zohaib-khan-786/Infernonet/InfernoNet/Documentation/FreshGuard IoT Monitor.pdf

F

r

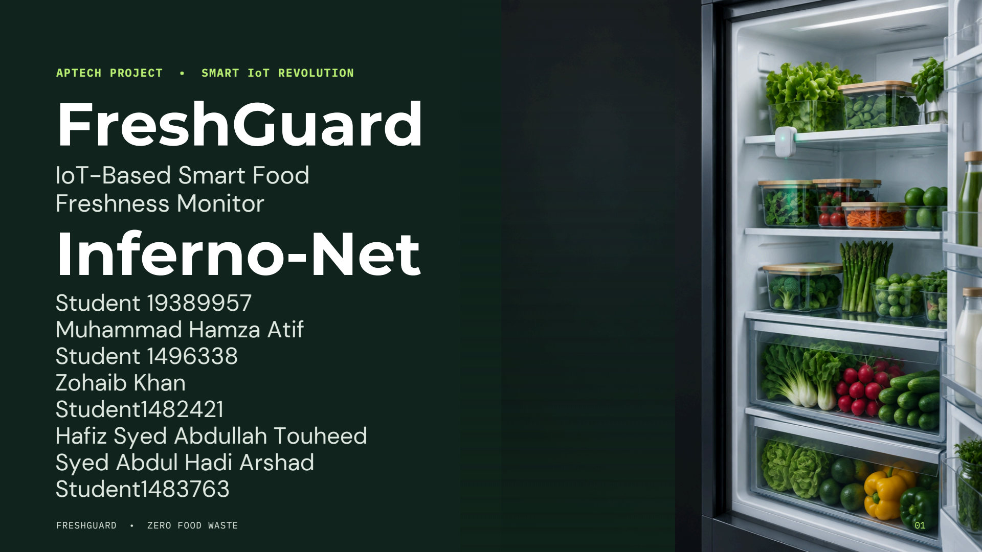
[picture p1: page 1]

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
# d IoT-Based Smart Food Freshness Monitor ZERO FOOD WASTE FRESHGUARD • ZERO FOOD WASTE

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
# tif

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
# aib

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
# fiz

S

y

e

d

A

b

d

# ulla

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
# ul H

a

# di A

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
01 / CONTEXT

# Waste often begins with missing visibility

OVERBUY

Items are forgotten behind newer stock.

POOR STORAGE

Temperature and humidity drift unnoticed.

LATE ACTION

Spoilage is discovered only at use time.

Continuous monitoring turns hidden drift into an early decision.

FRESHGUARD • ZERO FOOD WASTE | 02

02 / SOLUTION

# A small loop with a practical outcome

SENSE
conditions

INTERPRET
risk

NOTIFY
user

ACT
earlier

## A prototype that records storage conditions, links them to registered food, and creates

freshness guidance.

FRESHGUARD • ZERO FOOD WASTE | 03

03 / ARCHITECTURE

# From shelf conditions to a useful alert

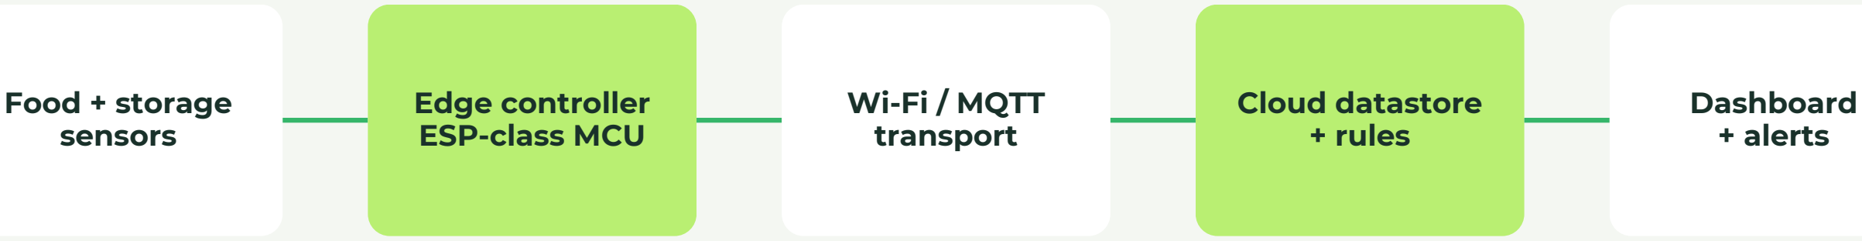
[picture p2: figure]
Food + storage sensors; Edge controller ESP-class MCU; Wi-Fi / MQTT transport; Cloud datastore + rules; Dashboard + alerts

## Telemetry → timestamp → store → evaluate → visualize

FRESHGUARD • ZERO FOOD WASTE | 04

04 / BUILD

# Hardware components

Controller

ESP32 / Wi-Fi MCU

Temperature

Digital probe or DHT

Humidity

DHT-class sensor

Gas / VOC

Air-quality sensor

Identity

RFID / NFC reader

Local alert

LED + buzzer

Display

Small OLED

Power

USB supply + enclosure

FRESHGUARD • ZERO FOOD WASTE | 05

05 / SENSING

# Three signals, one storage picture

### 01 TEMPERATURE

Tracks cold-chain stability and warm excursions.

Use trends and calibrated thresholds— not a single reading.

### 02 HUMIDITY

Reveals moisture conditions linked to drying or mold risk.

Use trends and calibrated thresholds— not a single reading.

### 03 GAS / VOC

Detects relative changes in emitted compounds during spoilage.

Use trends and calibrated thresholds— not a single reading.

FRESHGUARD • ZERO FOOD WASTE | 06

06 / IDENTITY
Register once. Track continuously.

1

SCAN OR ENTER

### RFID/NFC tag or manual ID

2

ADD CONTEXT

### Food type, quantity, stored date

3

LINK LOCATION

### Fridge zone or container sensor

FRESHGUARD • ZERO FOOD WASTE | 07

07 / LOGIC

# Freshness is a decision, not a sensor value

ITEM PROFILE
type • stored date • expected life

LIVE CONDITIONS
temperature • humidity • VOC trend

RULES
thresholds • duration • confidence

DECISION
ENGINE

FRESH

USE SOON

CHECK / DISCARD

FRESHGUARD • ZERO FOOD WASTE | 08

08 / EXPERIENCE

# The right alert, through the right path

RULE TRIGGERED

LOCAL

LED status • OLED message • buzzer for urgent events

REMOTE

Dashboard banner • push/email notification • event history

FRESHGUARD • ZERO FOOD WASTE | 09

09 / DASHBOARD
See status now. Understand change over time.

LIVE STATUS

## Item freshness Storage conditions Alert history Trend charts

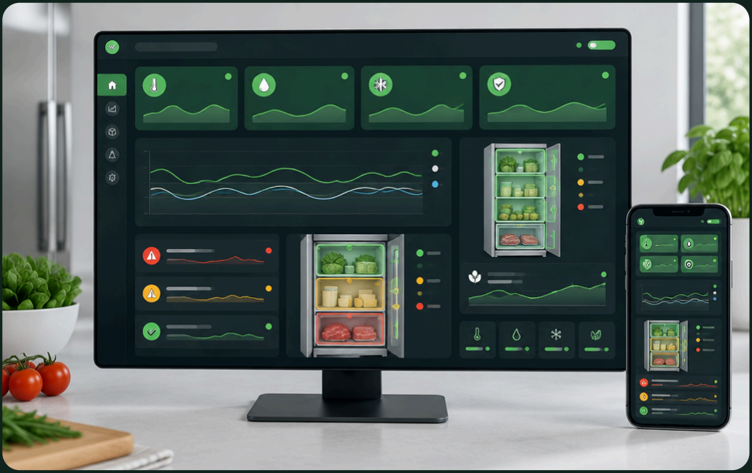
[picture p3: figure]

FRESHGUARD • ZERO FOOD WASTE | 10

10 / REQUIREMENTS

# What the system must do

REGISTER

Create and update food records

SAMPLE

Read sensors at set intervals

STORE

Timestamp and retain telemetry

EVALUATE

Apply freshness rules

ALERT

Notify on meaningful risk

VISUALIZE

Show status and history

FRESHGUARD • ZERO FOOD WASTE | 11

11 / QUALITY

# Useful means reliable, clear, and maintainable

RELIABILITY

Recover from Wi-Fi loss; buffer readings.

USABILITY

Status understandable at a glance.

SECURITY

Authenticated access; protected data.

PERFORMANCE

Timely sampling and alert delivery.

MAINTAINABILITY

Configurable thresholds and modular code.

FRESHGUARD • ZERO FOOD WASTE | 12

# IoT test matrix

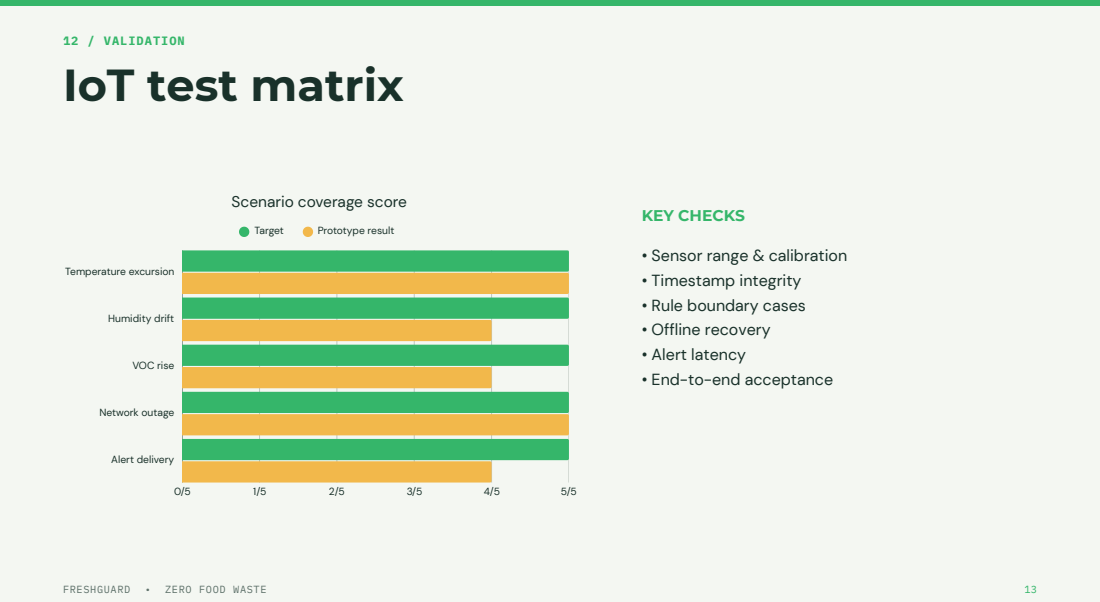
[picture p4: page 13]
12 / VALIDATION; Target; Prototype result; Temperature excursion; Humidity drift; VOC rise; Network outage; Alert delivery; KEY CHECKS; FRESHGUARD • ZERO FOOD WASTE

Scenario coverage score

• Sensor range & calibration
• Timestamp integrity
• Rule boundary cases
• Offline recovery
• Alert latency
• End-to-end acceptance

13 / SUBMISSION

# Final project package

01

WORKING PROTOTYPE

Sensors, controller,
alerts

02

SOURCE CODE

Firmware, backend,
dashboard

03

DOCUMENTATION

Architecture, setup,
user guide

04

EVIDENCE

Test matrix, logs,
screenshots

05

DEMO

Scenario-led
presentation
FRESHGUARD • ZERO FOOD WASTE | 14

14 / CONCLUSION

# FreshGuard makes storage conditions visible—and action

timely.

PRACTICAL PURPOSE

## Reduce avoidable waste through

monitoring, context, and early prompts.

HONEST BOUNDARY

## A prototype risk indicator—not a laboratory test or guarantee of food

safety.

FRESHGUARD • ZERO FOOD WASTE | 15

FRESHGUARD

# Thank you

# Questions & Discussion

ZERO FOOD WASTE × SMART IoT REVOLUTION

FRESHGUARD • ZERO FOOD WASTE | 16
