zohaib-khan-786/Infernonet/FreshGuard_Enterprise_Dashboard_UI_Guide.md

# FreshGuard Enterprise Dashboard — UI & Feature Build Guide

## 1. Product Definition

FreshGuard is an enterprise cold-storage monitoring and food-safety platform.

The dashboard is not a generic IoT telemetry screen. It is an operational control center designed to answer, immediately:

1. Is the refrigeration/storage environment safe?
2. Is the Raspberry Pi/controller and hardware healthy?
3. What changed recently?
4. Which food/items need attention?
5. Are temperature, humidity, gas, pressure, and cooling conditions within configured limits?
6. Is the refrigerator actively cooling?
7. What alerts require action?
8. What has happened over time?
9. Is the device online and actually reporting fresh data?

The UI must prioritize operational clarity over decoration.

---

# 2. Design Direction

## Visual language

Use a premium enterprise dark interface.

### Primary characteristics

- Dark navy/near-black application shell.
- Slightly lighter blue-black cards.
- High contrast typography.
- Thin borders instead of heavy shadows.
- Moderate corner radius: 10–14px.
- Restrained glow only around active/critical status indicators.
- Dense enough for professional monitoring, but never cramped.
- Strong visual hierarchy.
- Consistent status colors.
- Compact controls.
- Responsive layout.
- No excessive gradients.
- No glassmorphism everywhere.
- No giant hero section.
- No unnecessary 3D graphics.
- No decorative charts without operational meaning.

### Suggested palette

```text
App background:       #06111F
Sidebar:              #081525
Card:                 #0B1B2D
Card elevated:        #10243A
Border:               #1C3854
Primary text:         #F3F7FB
Secondary text:       #91A4B8
Muted text:            #60758A

Success:               #20C997
Warning:               #F59E0B
Danger:                #EF4444
Info:                  #3B82F6
Purple/diagnostic:     #8B5CF6
Cyan/temperature:      #22D3EE
```

Do not hard-code these colors into chart libraries if the chart system has a central theme. Define them as design tokens.

---

# 3. Global Application Layout

Desktop:

```text
┌──────────────────────────────────────────────────────────────────────────┐
│ Sidebar │ Global Header                                                  │
│         ├────────────────────────────────────────────────────────────────┤
│         │ Page content                                                    │
│         │                                                                  │
│         │                                                                  │
└─────────┴──────────────────────────────────────────────────────────────────┘
```

Recommended dimensions:

```text
Sidebar width: 240–260px
Header height: 68–76px
Content max-width: 1800px
Content padding: 20–28px
Card gap: 14–18px
```

The content should use a 12-column responsive grid.

---

# 4. Sidebar

## Brand area

Show:

- FreshGuard logo
- FreshGuard name
- Subtitle: `Cold-Storage Safety Monitor`
- Current application version

Example:

```text
[Shield]
FreshGuard
Cold-Storage Safety Monitor
```

## Navigation

### Main

- Dashboard
- Live Monitoring
- Food & Inventory
- Refrigeration
- Alerts
- Logs & History
- Reports

### Administration

- Devices
- Thresholds
- Users & Roles
- Integrations
- Settings

### Bottom status card

```text
● System Online
All systems operational
```

The status card changes to:

```text
● Degraded
2 devices need attention
```

or

```text
● Offline
Live telemetry unavailable
```

## Sidebar behavior

Desktop:
- Always visible.
- Active item has a filled background and subtle left/accent indicator.

Tablet:
- Collapsible.

Mobile:
- Off-canvas drawer.
- Bottom navigation may be used for the five most important destinations.

---

# 5. Global Header

The header should identify the currently selected device/site.

Example:

```text
[Refrigerator Icon]

Refrigerator Unit #1     ● Online
Location: Kitchen
ID: FG-001
Last sync: 2 min ago
```

Right side:

```text
Date / Time
Notifications
User avatar
User name
Role
Dropdown
```

## Device selector

Allow:

```text
All Devices
Refrigerator Unit #1
Refrigerator Unit #2
...
```

Changing device refreshes all dashboard telemetry.

## Connection indicator

States:

### Online

```text
● Online
Last sync: 8 sec ago
```

### Delayed

```text
● Delayed
Last sync: 2 min ago
```

### Offline

```text
● Offline
Last sync: 18 min ago
```

Never imply that a stale reading is live.

---

# 6. Dashboard Page

The dashboard is the primary operational page.

## Layout

```text
Header

KPI / telemetry cards
──────────────────────────────────────────────

Temperature Trends        Quick Stats
                         Device Health
──────────────────────────────────────────────

Food & Storage            Environmental Conditions

Alerts & Notifications    Recent Events

Quick Actions
```

---

# 7. Top Telemetry Cards

Use 5 primary cards.

## Card 1 — Refrigerator Temperature

Display:

```text
Refrigerator Temperature

2.8 °C

Optimal

Target: 2–5 °C
```

Include:
- Current value
- Unit
- Status
- Target range
- Mini sparkline
- Last updated timestamp

Status examples:

```text
Optimal
Warning
Critical
No Data
```

## Card 2 — Humidity

```text
Humidity

61.3 %RH

Optimal

Target: 50–70 %RH
```

## Card 3 — System Pressure

```text
System Pressure

1,003 hPa

Normal

Target: 950–1,050 hPa
```

If refrigeration pressure transducers are later added, this card should become configurable to display suction/discharge pressure.

## Card 4 — Air Quality / Gas

```text
Air Quality

137.8 ppm

Good

Target: <300 ppm
```

For MQ-135, do not falsely represent an uncalibrated sensor as laboratory-grade ppm.

The UI should support a `relative / uncalibrated` designation.

## Card 5 — Pi Temperature

```text
Pi Temperature

32.1 °C

Normal

Target: <60 °C
```

This becomes important when the refrigeration system is also used to cool the Raspberry Pi.

---

# 8. KPI Card Interaction

Each card is clickable.

Clicking opens the metric detail drawer/page.

Metric detail contains:

- Current value
- Target
- Current status
- Historical chart
- Min
- Max
- Average
- Time outside threshold
- Number of alerts
- Last update
- Sensor/device source
- Sensor health

Example:

```text
Temperature
2.8 °C

Target
2–5 °C

Today
Min     Avg     Max
2.1     2.9     4.8

Out of range
00:12:14

Alerts
2
```

---

# 9. Temperature Trends Chart

This is the main chart.

## Chart type

Line chart.

## Series

For the full refrigeration version support:

```text
Refrigerator
Evaporator
Condenser
Pi CPU
Coolant
Ambient
```

The user can toggle series.

## Controls

```text
1H   6H   24H   7D   30D
```

Also support custom date/time range.

## Chart requirements

- Interactive tooltip.
- Crosshair.
- Timestamp.
- Current value.
- Threshold bands.
- Threshold lines.
- Alarm markers.
- Door-open markers.
- Compressor start/stop markers.
- Missing-data indication.
- Zoom/pan for long ranges.
- Legend with clickable series.
- Export CSV.
- Export chart image/report.

## Threshold visualization

Example:

```text
Critical High ─────────────────
Warning High  ─────────────────
                temperature line
Warning Low   ─────────────────
Critical Low  ─────────────────
```

Do not rely solely on color. Labels must exist.

---

# 10. Environmental Conditions Panel

Use a compact 2x3 grid.

Cards:

### Temperature
Current:
`2.8 °C`

Target:
`2–5 °C`

Status:
`Optimal`

### Humidity
Current:
`61.3 %RH`

Target:
`50–70 %`

### Gas
Current:
`137.8 ppm`

Target:
`<300 ppm`

### Pressure
Current:
`1,003 hPa`

Target:
`950–1,050 hPa`

### Pi Temperature
Current:
`32.1 °C`

Target:
`<60 °C`

### Ambient Temperature
Current:
`24.6 °C`

Target:
`Reference only`

---

# 11. Quick Stats

Quick Stats are operational states rather than raw sensors.

## Compressor

```text
Compressor
Running

Runtime: 42 min
```

States:

- Running
- Stopped
- Starting
- Fault
- Locked out

## Energy

```text
Energy Consumption
0.82 kWh

Today
```

If an energy meter is installed, support:

- Instant power
- Current
- Voltage
- Energy today
- Energy this week
- Energy this month
- Compressor energy

## Door

```text
Door Status
Closed

Since 2h 14m
```

States:

- Closed
- Open
- Open too long
- Sensor fault

## Fan

```text
Evaporator Fan
On
```

States:

- On
- Off
- Fault

---

# 12. Device Health

Device Health is a hardware diagnostics panel.

List every important component.

Example:

```text
Device Health                       Healthy

● Raspberry Pi 4              Online
● ADS1115 ADC                 Online
● BMP280                      Online
● DHT11                        Online
● MQ-135                      Online
● MFRC522 RFID                Online
● DS3231 RTC                  Online
● Refrigeration controller    Online
● Temperature probe #1        Online
● Pressure sensor             Online
```

Each item should show:

- Online/offline
- Last reading
- Last communication
- Error count
- Firmware version where applicable

Clicking opens diagnostics.

---

# 13. Hardware Diagnostics

Provide:

```text
Device
Firmware
Uptime
CPU temperature
CPU load
Memory
Storage
Network
MQTT connection
Last packet
Packet loss
Sensor status
GPIO status
```

For Raspberry Pi:

```text
CPU Temperature
CPU Load
RAM
Disk
Temperature throttling
Undervoltage
Network
MQTT
```

---

# 14. Alerts & Notifications

This panel should show alerts requiring attention.

Each alert:

```text
[Severity]
Title
Short explanation
Timestamp
Device
Current value
Threshold
Action
```

Example:

```text
CRITICAL
Refrigerator temperature too high

Current: 8.7 °C
Limit: 5 °C

Started 14:21
Refrigerator Unit #1

[Acknowledge]
[View details]
```

## Severity

Use:

```text
Critical
Warning
Info
Resolved
```

Do not make every event an alert.

---

# 15. Alert Detail

Opening an alert should show:

```text
Alert
Refrigerator temperature too high

Current value
8.7 °C

Threshold
5 °C

Started
14:21

Duration
00:18:34

Device
FG-001

Sensor
Evaporator temperature

Related events
Door opened
Compressor started
Temperature crossed threshold
```

Actions:

- Acknowledge
- Resolve
- Add note
- View chart
- View related events

---

# 16. Food & Storage

This is a core business feature.

Display:

```text
Food & Storage

8 Items

Fresh             6
Needs Attention   1
Expired           1
```

Use a donut chart for composition.

The chart should never be the only representation. Always show counts beside it.

## Inventory table

Columns:

```text
Item
RFID / ID
Category
Stored
Last checked
Temperature exposure
Status
Expiry
Actions
```

Example:

```text
Milk
F-001
Dairy
26 May 14:12
Fresh
28 May
Fresh
>
```

---

# 17. Food Item Detail

Clicking an item opens:

```text
Milk

Status: Fresh

RFID:
F-001

Stored:
26 May 14:12

Expiry:
28 May

Current storage temperature:
2.8 °C

Temperature exposure:
Within limits

Door events:
2

Temperature excursions:
0

History
```

Show a temperature exposure timeline.

---

# 18. RFID Workflow

When RFID is scanned:

```text
RFID Scan Detected

Tag:
04:A3:...

Item:
Milk

Action:
Inventory lookup

Result:
Found

Status:
Fresh
```

If unknown:

```text
Unknown RFID tag

Tag:
04:A3:...

[Register Item]
[Ignore]
```

---

# 19. Recent Events

Show a chronological event stream.

Example:

```text
14:28  RFID
Food item scanned

13:42  Door
Door opened for 4 seconds

12:17  Temperature
Temperature returned to normal

11:03  Gas
Gas level increased

08:00  System
System started
```

Each event should have:

- Timestamp
- Event type
- Description
- Device
- Severity
- Related entity

Provide:

`View All`

---

# 20. Event Log Page

Full searchable audit log.

Filters:

```text
Device
Event type
Severity
Sensor
User
Date range
```

Search:

```text
Search events...
```

Table:

```text
Timestamp
Type
Device
Source
Value
Severity
Message
User
```

Support pagination and export.

---

# 21. Refrigeration Page

This page is required for the custom refrigerator concept.

## System overview

Display:

```text
Cooling System

Compressor       Running
Evaporator       -7.5 °C
Condenser        32.4 °C
Coolant          6.8 °C
Refrigerator     3.1 °C
Pi               32.1 °C
```

## Refrigeration schematic

Provide a simplified animated flow diagram:

```text
Compressor
    ↓
Condenser
    ↓
Expansion Device
    ↓
Evaporator
    ↓
Compressor
```

Show current temperatures and pressures around the loop.

Do not use decorative animation that obscures actual system state.

---

# 22. Pi Cooling Page

Because the Raspberry Pi is also a cooling load, expose its thermal system separately.

Show:

```text
Pi Temperature
32.1 °C

Cold Plate
8.2 °C

Coolant
6.8 °C

Ambient
24.6 °C

Dew Point
16.1 °C

Condensation Risk
Low
```

## Critical safety indicator

If:

```text
Cold surface temperature <= calculated dew point
```

show:

```text
CONDENSATION RISK
Cold surface is at/below dew point.

Cooling protection may activate.
```

This should be a high-priority safety condition.

---

# 23. Cooling System Controls

Controls must be permission-protected.

Possible controls:

```text
Cooling Mode
[Auto]

Compressor
[Running]

Evaporator Fan
[On]

Pump
[On]

Pi Cooling
[Enabled]
```

Manual controls require confirmation.

Example:

```text
Start compressor manually?

This bypasses automatic cooling logic.

[Cancel] [Confirm]
```

Never allow dangerous hardware controls through an accidental single click.

---

# 24. Energy Dashboard

Display:

### Current

```text
Power
142 W

Voltage
231 V

Current
0.62 A
```

### Consumption

```text
Today       2.8 kWh
7 days      17.4 kWh
30 days     74.2 kWh
```

Charts:

1. Power over time — line
2. Energy consumption by day — bar
3. Compressor runtime — bar
4. Temperature vs power — multi-series line
5. Energy per cooling hour — line

---

# 25. System Performance Charts

## Temperature vs time

Line.

Series:
- Refrigerator
- Evaporator
- Pi
- Ambient

## Humidity vs time

Line.

## Pressure vs time

Line.

## Gas level vs time

Line.

## Power vs time

Line.

## Compressor runtime

Bar chart by hour/day.

## Energy consumption

Bar chart by day.

## Food status

Donut chart:
- Fresh
- Needs attention
- Expired

## Alert distribution

Bar chart:
- Critical
- Warning
- Info
- Resolved

## Sensor health

Bar chart or status table:
- Online
- Delayed
- Offline

---

# 26. Chart Interaction Rules

Every chart must support:

- Hover tooltip.
- Exact timestamp.
- Current value.
- Time-range selector.
- Legend toggles.
- Threshold overlay.
- Empty state.
- Loading state.
- Error state.
- No-data state.

Charts must not show fake data as real data.

Use explicit demo labels when seeded data is used.

---

# 27. Reports

Reports page:

```text
Reports

Temperature Report
Food Storage Report
Energy Report
Device Health Report
Alert Report
Audit Report
```

Filters:

```text
Device
Date range
Report type
```

Actions:

```text
Preview
Export PDF
Export CSV
```

---

# 28. Dashboard Quick Actions

Provide four compact actions:

```text
Export Report
Refresh Data
Scan RFID
Settings
```

Additional actions can be:

```text
Add Food Item
Acknowledge Alerts
Run Diagnostics
Device Restart
```

Dangerous actions must be visually separated.

---

# 29. Notifications Center

Bell icon opens a notification drawer.

Group by:

```text
Critical
Today
Earlier
```

Example:

```text
Critical
Temperature exceeded limit
2 min ago

Warning
Door open too long
12 min ago

Info
RFID item scanned
24 min ago
```

Provide:

`Mark all read`

Do not automatically clear critical notifications.

---

# 30. Threshold Management

Administrator page.

Each threshold has:

```text
Metric
Minimum
Maximum
Warning level
Critical level
Delay
Action
Enabled
```

Example:

```text
Refrigerator Temperature

Target:
2–5 °C

Warning:
1–7 °C

Critical:
<0 °C or >8 °C

Delay:
60 seconds
```

Allow per-device and global thresholds.

Show change history.

---

# 31. Audit Trail

Every configuration change should be logged.

Example:

```text
27 Sep 2026 15:55

Admin changed:
Temperature max

Previous:
5 °C

New:
6 °C

Reason:
Testing

User:
Administrator
```

Never silently overwrite configuration history.

---

# 32. Device Management

Device table:

```text
Device ID
Name
Type
Location
Status
Firmware
Last Seen
Health
Actions
```

Device detail:

```text
Identity
Connectivity
Sensors
Firmware
Telemetry
Thresholds
Logs
Maintenance
```

Actions:

- Rename
- Assign location
- Update configuration
- Restart
- Disable
- Remove

Dangerous actions require confirmation.

---

# 33. Settings

Organize settings into sections:

### General
- Site name
- Time zone
- Units

### Monitoring
- Sampling interval
- Telemetry retention
- Chart defaults

### Alerts
- Thresholds
- Notification channels
- Alert delays

### Device
- MQTT
- Network
- Firmware

### Security
- Users
- Roles
- API keys
- Sessions

### Integrations
- MQTT
- Backend
- Email
- Webhooks

---

# 34. User Roles

Support:

```text
Administrator
Operator
Viewer
Maintenance
```

Administrator:
- Everything.

Operator:
- Monitor
- Acknowledge alerts
- Inventory
- Reports

Viewer:
- Read-only.

Maintenance:
- Diagnostics
- Hardware
- Device controls
- No user administration.

---

# 35. Responsive Design

## Desktop ≥ 1440px

Full dashboard:

```text
Sidebar
5 KPI cards
Large trend chart
Quick stats
Device health
Food
Environmental
Alerts
Events
```

## Laptop 1024–1439px

- Sidebar remains.
- KPI cards wrap.
- Right panels move below main chart.
- Reduce chart height.

## Tablet 768–1023px

- Collapsible sidebar.
- 2-column cards.
- Right rail becomes a normal content section.
- Charts full width.

## Mobile <768px

Order:

1. Device/header
2. Critical alert
3. Temperature
4. Pi temperature
5. Humidity
6. Other metrics
7. Trend chart
8. Alerts
9. Food
10. Events

Use horizontal scrolling only for dense tables.

Never make the entire dashboard horizontally scroll.

---

# 36. Application States

Every page and component needs:

## Loading

Skeleton cards and chart placeholders.

## Empty

Example:

```text
No telemetry available

The device has not reported any readings yet.
```

## Offline

```text
Device offline

Last reading:
27 Sep 2026 15:52

Data shown below is historical.
```

## Error

```text
Unable to load telemetry

Retry
```

## Stale

```text
Data stale

Last update: 8 minutes ago
```

The UI must never make stale telemetry look live.

---

# 37. Status System

Use consistent status semantics everywhere.

```text
GREEN
Healthy / Optimal / Fresh / Online

AMBER
Warning / Needs attention / Delayed

RED
Critical / Expired / Offline / Fault

BLUE
Informational / Normal system event

PURPLE
Diagnostic / System subsystem
```

Always include text labels. Do not communicate state by color alone.

---

# 38. Accessibility

Required:

- Keyboard navigation.
- Visible focus state.
- Minimum readable contrast.
- Semantic buttons.
- Accessible labels.
- Tooltips for icons.
- Do not rely solely on color.
- Screen-reader-friendly status messages.
- Tables with proper headers.
- Modal focus trapping.

---

# 39. Information Hierarchy

The user should be able to determine these in under a few seconds:

```text
1. Is the system online?
2. Is the refrigerator safe?
3. Is the Pi safe?
4. Is anything currently wrong?
5. What needs action?
```

Do not place low-level diagnostics above operational status.

The dashboard is for decisions first and diagnostics second.

---

# 40. Data Freshness Model

Every telemetry value should carry:

```text
value
unit
timestamp
source
status
quality
```

Example:

```json
{
  "metric": "refrigerator_temperature",
  "value": 2.8,
  "unit": "°C",
  "timestamp": "2026-09-27T15:58:11+05:00",
  "source": "BMP280",
  "status": "optimal",
  "quality": "fresh"
}
```

Possible quality:

```text
fresh
delayed
stale
missing
invalid
```

---

# 41. Suggested Component Architecture

Use reusable components.

```text
AppShell
├── Sidebar
├── Header
├── DeviceSelector
├── NotificationCenter
└── UserMenu

Dashboard
├── AlertBanner
├── MetricCard
├── TrendChart
├── QuickStats
├── DeviceHealth
├── FoodSummary
├── EnvironmentalGrid
├── AlertList
├── EventTimeline
└── QuickActions

Inventory
├── InventorySummary
├── InventoryTable
├── FoodItemDrawer
├── RFIDScanner
└── FoodHistory

Refrigeration
├── CoolingOverview
├── RefrigerationDiagram
├── CompressorStatus
├── ThermalMetrics
├── PressureMetrics
└── CoolingControls

Diagnostics
├── DeviceHealth
├── SensorStatus
├── NetworkStatus
├── SystemResources
└── HardwareLogs
```

---

# 42. Recommended Frontend Structure

```text
src/
├── app/
│   ├── dashboard/
│   ├── monitoring/
│   ├── inventory/
│   ├── refrigeration/
│   ├── alerts/
│   ├── logs/
│   ├── reports/
│   ├── devices/
│   └── settings/
│
├── components/
│   ├── layout/
│   ├── cards/
│   ├── charts/
│   ├── alerts/
│   ├── inventory/
│   ├── refrigeration/
│   ├── diagnostics/
│   └── common/
│
├── lib/
│   ├── api/
│   ├── telemetry/
│   ├── formatting/
│   └── permissions/
│
├── hooks/
├── types/
└── styles/
```

---

# 43. Data Model Concepts

Core entities:

```text
Device
Sensor
TelemetryReading
Threshold
Alert
Event
FoodItem
RFIDTag
RefrigerationState
EnergyReading
User
Role
AuditEntry
Report
```

Relationships:

```text
Device
 ├── Sensors
 ├── Telemetry
 ├── Alerts
 ├── Events
 ├── Thresholds
 └── RefrigerationState

FoodItem
 └── RFIDTag
```

---

# 44. Real-Time Updates

The UI should support real-time telemetry.

Preferred architecture:

```text
Sensors
   ↓
ESP32 / Raspberry Pi
   ↓
MQTT
   ↓
Backend
   ↓
WebSocket / SSE
   ↓
Dashboard
```

Do not poll every metric independently from the browser if a real-time event stream is available.

The UI should visibly show:

```text
Live
Delayed
Offline
```

---

# 45. MQTT / Telemetry UI Requirements

Show connection status:

```text
MQTT
Connected

Last message:
2 sec ago
```

If disconnected:

```text
MQTT
Disconnected

Last message:
4 min ago
```

Telemetry packets should have:

- Device ID
- Sequence number
- Timestamp
- Sensor values
- Firmware version
- Quality/status

---

# 46. Enterprise UX Rules

1. Never hide important operational state behind navigation.
2. Never show raw technical data without context.
3. Every metric needs a unit.
4. Every metric should have a timestamp.
5. Every abnormal value needs a threshold/context.
6. Every alert needs an action or explanation.
7. Historical data must be visually distinguishable from live data.
8. Destructive actions require confirmation.
9. Hardware controls require appropriate permissions.
10. Tables must be searchable/filterable.
11. Charts must have useful tooltips.
12. Empty/error/offline states must be designed, not improvised.
13. Do not use fake success states.
14. Do not call uncalibrated MQ-135 readings laboratory-grade measurements.
15. Do not make the UI look like a toy IoT dashboard.

---

# 47. Dashboard Priority Model

The dashboard should visually prioritize:

```text
CRITICAL ALERT
      ↓
CURRENT SAFETY STATE
      ↓
LIVE TELEMETRY
      ↓
COOLING SYSTEM
      ↓
FOOD / INVENTORY
      ↓
HISTORY
      ↓
DIAGNOSTICS
```

Low-level technical details belong deeper in the application.

---

# 48. Implementation Sequence

Build in this order.

## Phase 1 — Application shell

- Sidebar
- Header
- Device selector
- Responsive grid
- Theme tokens
- Typography

## Phase 2 — Dashboard

- Metric cards
- Alert banner
- Trend charts
- Quick stats
- Device health
- Environmental cards
- Food summary
- Recent events

## Phase 3 — Inventory

- Food table
- Food details
- RFID flow
- Status system

## Phase 4 — Alerts

- Alert list
- Alert detail
- Acknowledgement
- Resolution
- Alert history

## Phase 5 — Refrigeration

- Refrigeration overview
- Compressor
- Evaporator
- Condenser
- Coolant
- Pi cooling
- Condensation risk
- Cooling diagram

## Phase 6 — Diagnostics

- Device health
- Sensor health
- Network
- MQTT
- Raspberry Pi system metrics

## Phase 7 — Reports

- PDF
- CSV
- Filtered reports
- Historical analytics

## Phase 8 — Administration

- Devices
- Thresholds
- Users
- Roles
- Settings
- Audit trail

---

# 49. Final Visual Requirement

The finished product should feel like:

```text
Enterprise monitoring software
+
Industrial refrigeration control
+
Food inventory system
+
IoT observability platform
```

It should NOT feel like:

```text
Student IoT project
Generic admin template
Generic AI dashboard
Crypto dashboard
Gaming UI
```

The interface must communicate that FreshGuard is monitoring a real physical system whose incorrect state can have physical consequences.

Use visual density where information matters, but maintain strong grouping and whitespace.

The most important screen should make the operational state obvious without requiring the user to interpret raw sensor graphs.

---

# 50. Build Acceptance Checklist

Before considering the UI complete:

- [ ] Enterprise dark theme implemented.
- [ ] Responsive desktop/tablet/mobile layouts.
- [ ] Sidebar navigation.
- [ ] Device selector.
- [ ] Live/offline/stale states.
- [ ] Temperature KPI.
- [ ] Humidity KPI.
- [ ] Pressure KPI.
- [ ] Gas KPI.
- [ ] Pi temperature KPI.
- [ ] Temperature trend chart.
- [ ] Environmental conditions.
- [ ] Quick stats.
- [ ] Compressor state.
- [ ] Energy state.
- [ ] Door state.
- [ ] Fan state.
- [ ] Device health.
- [ ] Food inventory.
- [ ] RFID workflow.
- [ ] Alerts.
- [ ] Event timeline.
- [ ] Refrigeration page.
- [ ] Pi cooling page.
- [ ] Dew-point/condensation risk.
- [ ] Energy analytics.
- [ ] Reports.
- [ ] Threshold management.
- [ ] Audit history.
- [ ] Device management.
- [ ] User roles.
- [ ] Settings.
- [ ] Loading states.
- [ ] Empty states.
- [ ] Error states.
- [ ] Offline states.
- [ ] Accessibility.
- [ ] Chart tooltips.
- [ ] Chart range controls.
- [ ] CSV/PDF export.
- [ ] No fake live-data claims.
- [ ] No unsupported food-safety claims.
- [ ] Dangerous hardware actions protected by permissions and confirmation.
