zohaib-khan-786/Infernonet/docs/BUILD_SHEET.html

# FreshGuard — Bench Build Sheet

ESP8266MOD cold-storage food-safety monitor · work top-down, power up in stages, verify before adding the next stage · full reference: docs/WIRING_DIAGRAM.html

## A · Parts check — do not start until every box is ticked

| Part | Model / part number | Count | Check before building
☐ | MCU board | ESP8266MOD | 1 | NodeMCU. Note the silkscreen — trust GPIO numbers, not D-labels
☐ | I/O expander | PCF8574 | 2 | Must be PCF8574 (0x20), not PCF8574A (0x38)
☐ | Level shifter | 4-ch BSS138 | 1 | Bidirectional, has LV1–LV4 / HV1–HV4
☐ | Temperature + pressure | BME280 | 1 | BME280, chip id 0x60 — a real BMP280 (0x58) is rejected by the driver
☐ | Humidity | removed | 0 | DHT11 no longer fitted - the BME280 measures humidity itself, and GPIO16 is now spare
☐ | Gas | MQ-135 | 1 | 4-pin breakout with A0 and D0
☐ | ADC | ADS1115 | 1 | Adafruit 2349 or CJMCU-1115
☐ | RTC | DS3231 | 1 | Charging path must be disabled — see stage D
☐ | RFID | MFRC522 | 1 | 13.56 MHz kit · 3.3 V only
☐ | Display | 16×2 LCD + PCF8574 backpack | 1 | Address 0x27 · 5 V supply
☐ | Door sensor | Reed switch, SPST-NO | 1 | Magnetic type
☐ | Buzzer | TMB12A05 | 1 | 5 V active, 12 mm. The A12 is 12 V and will not sound
☐ | MOSFET | IRFZ44N | 2 | TO-220 logic-level. Buzzer only + 1 spare. NEVER IRF540N — it will not conduct at a 3.3 V gate. The three LEDs need no transistor.
☐ | Diode | 1N4148 | 1 | DO-35 · buzzer flyback
☐ | Resistors 4.7 kΩ | 1/4 W | 1 | MQ divider upper leg
☐ | Resistors 2.2 kΩ | 1/4 W | 1 | MQ divider lower leg
☐ | Resistors 10 kΩ | 1/4 W | 1 | Reed pull-up only — recommended, the PCF8574 has an internal one
☐ | Resistors 330 Ω | 1/4 W | 3 | LED current limiting
☐ | Capacitors 100 nF | ceramic X7R, 104 | 3 | ESP8266 3V3 pin · MQ-135 supply · 5 V rail
☐ | Bulk capacitor | 1000 µF, 16 V | 1 | On the 5 V rail
☐ | LEDs | green · yellow · red, 3 mm | 3 | Indicator colours
☐ | Supply | USB 5 V, 1 A min | 1 | Wi-Fi bursts exceed 300 mA
☐ | Tools | multimeter, side cutters, solderless breadboard | — | Meter is mandatory, not optional

## B · Before first power

### Do not fit these — your modules already have them

Part | Why it is unnecessary | How to confirm
I²C pull-ups | BME280, ADS1115, most PCF8574 and DS3231 breakouts already carry 4.7–10 kΩ on SDA/SCL. The BSS138 board carries its own for the LCD side. | Power off. Measure SDA to 3V3. ~4.7–10 kΩ means they are fitted. Do not add a second set.

### Do not economise on these three

1. 1N4148 across the buzzer. A buzzer is an inductive load; switching it off spikes to tens of volts on a 5 V rail. That spike is created outside the buzzer, by your switching, so no module can contain it. Without it you get unexplainable sensor faults, brownouts and eventually a dead MOSFET.
2. 1000 µF on the 5 V rail. Three loads share one USB feed: ESP8266 Wi-Fi spikes over 300 mA, the MQ-135 heater at ~150 mA, and the LCD plus buzzer. This belongs to the supply path, not to any module.
3. The 100 nF decoupling. The disturbance comes from the inductance of the wire, so a cap soldered to the module is at the wrong end of it to respond.

### Blocking items — resolve all four

1. PCF8574 fitted. Without it the firmware reports Sensor Fault permanently and never produces a food verdict.
2. DS3231 charging disabled. On the HW-084/ZS-042 boards, remove the resistor feeding the DS3231 VCH pin. Confirm with a meter that no current flows into a non-rechargeable CR2032.
3. Level shifter orientation. LV → 3V3, HV → 5V, GND → common ground. LV/HV reversed destroys the translator.
4. No 5 V on any GPIO. Trace it once by hand before applying power. The ESP8266 is 3.3 V only and there is no protection.

#### One clarification, because it trips up almost everyone

The I²C bus is not a component — it is the single shared SDA + SCL wire pair running from GPIO4/GPIO5. Five devices hang off it: BME280 (0x76), DS3231 (0x68), ADS1115 (0x48), the expander PCF8574 (0x20), and — through the level shifter — your LCD backpack (0x27). The RC522 is on a separate SPI bus, and the LEDs and buzzer are plain switch outputs, and only the buzzer has a transistor. The DHT11 is gone - humidity now comes off the BME280 on that same I2C bus, which frees GPIO16.
And note there are two PCF8574 chips, unrelated to each other: the one already soldered inside your LCD at 0x27, and the separate expander module you are buying at 0x20.

## C · Build order — one stage at a time

### Stage 1 · 3.3 V I²C bus

Wire SDA and SCL as a shared pair to BME280, DS3231, ADS1115, PCF8574. Every VCC to 3V3, every GND to common ground. Fit 100 nF at each module. Address straps: BME280 CSB→3V3 and SDO→GND (0x76) · ADS1115 ADDR→GND (0x48) · PCF8574 A0/A1/A2→GND (0x20).

Add 4.7 kΩ pull-ups SDA→3V3 and SCL→3V3 only if your modules carry none.

### Stage 2 · (removed)

This stage used to wire the DHT11 to GPIO16. The DHT11 is removed - the BME280 measures humidity over the I2C bus you already built in stage 1, so nothing is wired here. GPIO16 (silkscreen D0) is spare and is the only non-boot-strapped pin the ESP8266 has to spare.

Reminder from stage 1: on NodeMCU, silkscreen D0 is GPIO16 and GPIO0 is D3. Different pins.

### Stage 3 · RC522 on SPI

3.3V→3V3, GND→GND, SS/NSS→GPIO15, SCK→GPIO14, MOSI→GPIO13, MISO→GPIO12, RST→PCF8574 P5, IRQ unused.

Silkscreen D5=GPIO14, D6=GPIO12, D7=GPIO13, D8=GPIO15.

### Stage 4 · Level shifter and LCD

LV→3V3, HV→5V, GND→common GND. LV1←GPIO4 (SDA) to HV1→LCD SDA. LV2←GPIO5 (SCL) to HV2→LCD SCL. LCD VCC→5V, GND→GND. LV3/LV4 unused.

Adjust the contrast pot only after power-on — the usual symptom is a solid block of blocks.

### Stage 5 · MOSFET driver stage — build 4 identical

gate← PCF pin, source→GND, drain→load, 100 kΩ from gate to GND.

PCF | Load | Wiring from the 5 V rail | Extra
P1 | green | 5V → anode → cathode → 330 Ω → drain | —
P2 | yellow | 5V → anode → cathode → 330 Ω → drain | —
P3 | red | 5V → anode → cathode → 330 Ω → drain | —
P4 | buzzer | 5V → buzzer + ; buzzer − → drain | 1N4148: cathode to 5V, anode to drain

The gate pull-down is what keeps the buzzer silent during boot and if I²C hangs.

### Stage 6 · Reed switch on P0

One terminal to P0, the other to GND, with 10 kΩ from P0 to 3V3. Closed must read LOW. If the switch is normally-closed, invert REED_CLOSED_LEVEL and re-test.

### Stage 7 · MQ-135 into ADS1115 AIN0

MQ-135 VCC→5V with 100 nF across it, GND→GND, D0 unused. Then A0 → 4.7 kΩ → AIN0 node → 2.2 kΩ → GND. AIN1–AIN3 unused.

Measure A0 before fitting the divider. Expect 0.3–0.6 V on a 10 kΩ-load board, lower in a hot humid cabinet. Record the value and the board's load resistor below.

Measured A0 (5 V, 5 min) | Load resistor RL on board | Expected AIN0 = A0 × 0.319

## D · First power-on — staged, meter on the rails

### Power in stages. Do not connect everything and switch on.

| Stage | Measure | Accept | Reject if
☐ | 1 · MCU only | 3V3 pin to GND | 3.20 – 3.40 V | Below 3.1 V or above 3.5 V
☐ | 2 · add I²C modules | 3V3 again, then droop under load | stays above 3.15 V | sags toward 3.0 V
☐ | 3 · add 5 V loads one at a time | 5V at the buzzer, then the LEDs | holds 4.75 – 5.25 V | any visible droop — fit more bulk capacitance
☐ | 4 · final | both rails, board warm after 10 min | stable and warm to touch, not hot | any module too hot to touch

## E · Serial log — expected on first boot

These are the strings the compiled firmware emits. None has yet been observed on hardware — this is what to compare against, not a record of a successful run.

[MQ135] Relative baseline captured: AIN0 0.1xx mV (ADS code nnn) [MQ135] Divider 4.7k/2.2k configured as 4700/2200 ohm; scale 0.319; max A0 at 3300 mV AIN0 10350 mV [MQ135] No ppm/calibration claim; tune delta using test evidence. [ADS1115] OK range=GAIN_ONE full-scale=+/-4.096 V rate=128 SPS [Inventory] Loaded n item(s) [WiFi] Connected: a.b.c.d [Backend] Disabled until BACKEND_URL + BACKEND_INGEST_KEY are set

### Acceptance criteria for "it works"

1. No Sensor Fault in the reported status — the PCF8574 is answering at 0x20.
2. Temperature and pressure both read live, not zero.
3. Humidity reads live.
4. MQ baseline captured, and the AIN0 value sits in the range recorded in stage 7.
5. All three LEDs change with the status the device reports.
6. Buzzer beeps on an alert, and stays silent when idle.
7. LCD shows the status pages, with the contrast pot adjusted.
8. RFID tag scan registers an inventory item and it survives a power cycle.
9. Door open is detected and cleared correctly.
10. [Backend] seq n accepted appears once the service URL and key are set.

## F · Commissioning the backend link

1. Start the service: cd backend && npm start. Confirm GET /healthz returns {"status":"ok"}.
2. In the firmware set BACKEND_URL to the origin only — http://192.168.1.50:8080, no trailing slash and no /api suffix.
3. Set BACKEND_INGEST_KEY to the plaintext whose SHA-256 is the service's FG_INGEST_KEY_SHA256. The service stores only the hash.
4. For plain HTTP over the LAN, no TLS fingerprint is needed. If you use an https URL you must also set BACKEND_TLS_FINGERPRINT_ENABLED and supply a real fingerprint, or the firmware refuses to send.
5. Open the dashboard at http://localhost:5173. The device appears within one interval (30 s).

Built by ______________________ Date ____________ Hardware revision ______

A0 in clean air (measured) | | Load RL
AIN0 after divider | | 3V3 rail (loaded)
5V rail (all loads on) | | Buzzer marking verified | ☐ yes ☐ no

Pin assignments, I²C addresses, the PCF channel map and the 0xC1 configuration value are taken from the compiled FreshGuard.ino, so this sheet and the firmware cannot silently disagree. GPIO numbers are authoritative; the NodeMCU silkscreen column is provisional until confirmed against the actual module.
No step on this sheet has been performed on hardware. There is no bench record, no measured current draw and no confirmed board layout behind any of it. Treat every "accept" figure as a starting point to measure, not a validated limit.
