zohaib-khan-786/Infernonet/docs/WIRING_DIAGRAM.html

# FreshGuard — Complete Wiring & Pinout Diagram

ESP8266MOD cold-storage food-safety monitor · derived from the compiled firmware (FreshGuard.ino) so the wiring and the code cannot disagree.

#### Before you power anything up

- The ESP8266 is 3.3 V only. Nothing 5 V may touch a GPIO. Your BSS138 level shifter is what makes the 5 V LCD safe.
- You do not yet have a PCF8574. It is not an accessory — without it the firmware reports Sensor Fault permanently and no food verdict is ever produced.
- Common ground is mandatory. USB negative, every module GND, and the shifter's GND terminal must all be tied.

## 1System topology

Three separate buses leave the ESP8266: a 3.3 V I²C bus, a 5 V-shifted I²C branch for the LCD, and hardware SPI for the RFID reader. Everything switched (LEDs, buzzer) hangs off the I/O expander, never off the MCU.

Two I²C buses, two voltage domains. The LCD branch is the only 5 V logic path and it is isolated by the shifter. Switched loads never touch a GPIO — the expander drives MOSFET gates.

## 2ESP8266 pin assignment

GPIO numbers are authoritative. The NodeMCU silkscreen is not confirmed for your board, so treat the left column as unverified until you check it against the actual module.

Silkscreen* | GPIO | Function | Dir | Voltage | Connects to
D1 | 5 | I²C SCL | bidir | 3V3 | ADS1115, BMP280, DS3231, PCF8574, and shifter LV2
D2 | 4 | I²C SDA | bidir | 3V3 | ADS1115, BMP280, DS3231, PCF8574, and shifter LV1
D0 | 16 | spare | — | 3V3 | unused — the DHT11 was removed; humidity comes from the BME280
D5 | 14 | SPI SCK | out | 3V3 | RC522 SCK
D6 | 12 | SPI MISO | in | 3V3 | RC522 MISO
D7 | 13 | SPI MOSI | out | 3V3 | RC522 MOSI
D8 | 15 | RC522 SS | out | 3V3 | RC522 SDA/SS/NSS
D3 | 0 | spare | — | boot | Must be HIGH at power-up — leave unused
D4 | 2 | spare | — | boot | Must be HIGH at power-up; also drives the onboard LED
RX / TX | 3 / 1 | Serial debug | in/out | 3V3 | Keep free — this is the 115200 baud console
— | 6–11 | not exposed | — | — | GPIO9/10 are the flash interface. Do not attempt.

* The single most common wiring mistake on this board: on NodeMCU, silkscreen D0 is GPIO16, and GPIO0 is D3. They are different pins. Trust the GPIO number.

#### Why there is no GPIO left

Seven pins serve the three buses, and the two remaining candidates (GPIO0, GPIO2) are boot-strapped — pulling either one at power-up puts the ESP8266 into the wrong boot mode. That is the entire reason the design moves the reed switch, LEDs, buzzer and RC522 reset onto a PCF8574 expander rather than onto the MCU.

## 3I²C bus map

All five devices share the same two wires. Four sit in the 3.3 V domain; the LCD is the only 5 V participant and is the only one behind the shifter.

Address | Device | Domain | VCC | Notes
0x76 | BMP280 | 3V3 | 3V3 | Temperature + pressure. Use 0x77 only if SDO is tied high.
0x68 | DS3231 | 3V3 | 3V3 | RTC. Verify the CR2032 charging path first — see §6.
0x48 | ADS1115 | 3V3 | 3V3 | AIN0 only. AIN1–AIN3 intentionally unused. Address from the ADDR strap.
0x20 | PCF8574 | 3V3 | 3V3 | Must be the 8-bit PCF8574. The PCF8574A answers on 0x38 and will not be found.
0x27 | LCD backpack | 5V | 5V | Contains its own PCF8574 inside the module. Configurable via the A0/A1/A2 solder links.

Pull-ups: one set of 4.7 kΩ from SDA and SCL to 3V3. Most modules already carry them — if you fit a second set you halve the effective resistance, which is harmless but unnecessary. Note the pull-ups belong on the 3.3 V side only; on a shifter board, pull-ups to 5 V on the LV side would fight the translator.

## 4PCF8574 channel map

P0 is the only input; P1–P5 are outputs. The configuration register is written as 0xC1, which makes P0, P6 and P7 inputs and P1–P5 outputs.

One driver topology, four times. Gate from the expander, 100 kΩ pull-down so the load is off during boot and if I²C hangs, source to ground, load between +5 V and drain.

#### Why one MOSFET, and why not an NPN or a ULN2003A

The buzzer is the only load that needs a transistor, because it is the only one that is both inductive and over 25 mA.

MOSFET, not NPN: the port's 100 µA HIGH is ample to charge a MOSFET gate (a few picofarads, finished in well under a microsecond, and drawing nothing thereafter) but nowhere near enough to hold an NPN base in saturation. An NPN here would give a click, not a beep.

TO-220, not TO-92: purely mechanical. TO-92 leads are 0.65 mm apart and line up with no perfboard hole spacing whatsoever, so it cannot be inserted without bending. TO-220 leads are 2.54 mm and drop straight into three adjacent holes. A ULN2003A was considered and rejected: it inverts the logic, needs four extra pull-up resistors because its Darlington inputs draw more than 100 µA, and its inputs cannot be held off at boot, so the buzzer would sound on every power cycle.

## 5Definitive connection list

Every wire, in build order. Each row names the pin, what it belongs to, and what it connects to. This section is the bench checklist — the sections above explain why.

### ESP8266 — pin to purpose

Pin | GPIO | Belongs to | Connects to | Domain
VIN | — | Power in | USB 5 V | 5V
GND | — | Power | Common ground | —
D2 | 4 | I²C SDA | I²C bus + shifter LV1 | 3V3
D1 | 5 | I²C SCL | I²C bus + shifter LV2 | 3V3
D0 | 16 | spare | unused — the DHT11 was removed, humidity is read from the BME280 over I²C
D5 | 14 | RC522 SCK | RC522 SCK | 3V3
D6 | 12 | RC522 MISO | RC522 MISO | 3V3
D7 | 13 | RC522 MOSI | RC522 MOSI | 3V3
D8 | 15 | RC522 SS | RC522 SDA/SS/NSS | 3V3
D3 | 0 | unused | — boot-strapped HIGH at power-up | —
D4 | 2 | unused | — boot-strapped HIGH at power-up | —
RX / TX | 3 / 1 | Serial console | USB serial monitor @ 115200 | 3V3

### I²C bus — parallel to four devices

Module | Address | VCC | GND | SDA / SCL | Address straps & unused pins
BMP280 | 0x76 | 3V3 | GND | bus | CSB→3V3 · SDO→GND
DS3231 | 0x68 | 3V3 | GND | bus | SQW, 32K unused
ADS1115 | 0x48 | 3V3 | GND | bus | ADDR→GND · ALRT unused
PCF8574 | 0x20 | 3V3 | GND | bus | A0,A1,A2→GND

100 nF from each module's VCC to GND at the pins.

### Level shifter and LCD — the only 5 V logic path

Terminal | Connects to | Note
LV | 3V3 | low-voltage reference
HV | 5V | high-voltage reference
GND | Common ground | must be the same ground as everything else
LV1 → HV1 | GPIO4 → LCD SDA | bidirectional
LV2 → HV2 | GPIO5 → LCD SCL | bidirectional
LV3 / LV4 | unused | only two channels are needed
LCD VCC | 5V | backpack supply
LCD GND | GND | —

### PCF8574 channel assignment

Ch | Direction | Belongs to | Connects to
P0 | input | Reed switch (door) | one terminal to P0, other to GND · 10 kΩ from P0 to 3V3 · closed = LOW
P1 | output | Green status LED | gate of MOSFET 1
P2 | output | Yellow status LED | gate of MOSFET 2
P3 | output | Red status LED | gate of MOSFET 3
P4 | output | Buzzer | gate of MOSFET 4
P5 | output | RC522 reset | RC522 RST direct · 3V3 logic · active LOW
P6 / P7 | input | unused | left unconnected

### Output stage — the LEDs are direct, only the buzzer gets a MOSFET

The three driver styles are not interchangeable, because the PCF8574 port is quasi-bidirectional: its HIGH state sources only about 100 µA while its LOW state sinks 25 mA. That 250× asymmetry decides the wiring for each load.

Channel | Load | Wiring | Polarity
P1 | green LED | 5V → anode → cathode → 330 Ω → pin | active-LOW — the pin sinks ~8 mA
P2 | yellow LED | 5V → anode → cathode → 330 Ω → pin | active-LOW
P3 | red LED | 5V → anode → cathode → 330 Ω → pin | active-LOW
P4 | buzzer | 5V → buzzer + ; buzzer − → drain of IRFZ44N | active-HIGH — the pin drives the gate
P5 | RC522 reset | pin → RC522 RST direct | active-LOW

### Buzzer driver — TO-220, one only

Terminal | Connects to
gate | PCF8574 P4
gate | 100 kΩ to GND — holds the buzzer silent at boot and through an I²C hang
source | GND
drain | buzzer −
flyback | 1N4148 cathode to 5V, anode to drain

#### Why the LEDs need no transistor, and the buzzer does

The LEDs are driven from the rail into the pin, so the pin's strong pull-down MOSFET closes the path at about 8 mA — inside the 25 mA sink rating. In the off state the weak 100 µA source simply holds the LED off at a few tens of millivolts. No driver transistor is involved and the pin never sources more than 100 µA.

The buzzer is different twice over. It is inductive and draws up to 30 mA, which exceeds the 25 mA sink rating — and switching an inductive load without a flyback path spikes back into the shared 5 V rail and the I²C bus. Hence the one MOSFET and the 1N4148.

A MOSFET rather than an NPN, because the port's 100 µA is ample to charge a gate (a few picofarads, done in under a microsecond) but nowhere near enough to hold an NPN base in saturation. The same 100 µA is precisely what P5's TTL input needs, which is why the RC522 reset goes straight in — that is the port's intended use.

#### The one part substitution that will silently fail

Use IRFZ44N or IRLZ44N — TO-220, logic-level, Vgs(th) 1–2 V, so the 3.3 V HIGH turns it fully on. Do not fit an IRF540N. It is the most common MOSFET in the world and its Vgs(th) is specified at 2–4 V, which means at a 3.3 V gate it is not guaranteed to conduct at all. The symptom is a buzzer that appears completely dead.

Three leads at 2.54 mm pitch drop straight into three adjacent perfboard holes. That is the reason for the TO-220 package: TO-92 leads are 0.65 mm apart and align with no perfboard hole spacing at all.

Step | Do this | Expect
1 | Power the module at 5 V. Do not connect A0 to the divider yet. | —
2 | Measure A0 to GND with a multimeter, outdoors or in a well-ventilated room, after 5 minutes. | 0.3 – 0.6 V on a 10 kΩ board
3 | Identify RL on the board — it is often marked, or trace A0 back to GND and read the resistor. | 1 k / 10 k / 22 k
4 | Connect the divider, then measure AIN0. | ≈ 0.32 × the A0 value from step 2
5 | Run the firmware and watch the serial log for the captured baseline. | [MQ135] Relative baseline captured: AIN0 … mV

#### What the firmware now does about preheat drift

The datasheet asks for 24–48 hours of preheat before the element settles. The firmware warms up for 60 seconds — long enough to stop a cold sensor raising a false alarm, far short of a settled resistance. On its own that meant the remaining drift accumulated as a rising delta over a shift and could read as spoilage that was not there.

The firmware therefore tracks the baseline slowly (2% per averaging pass, a ~4 minute time constant) but only while the measured delta is already inside the clear threshold. That gate is what makes it safe: tracking can never walk the baseline up into a real event, because a genuine gas rise outpaces it and stops tracking on the next pass. It is RAM-only by design — persisting a tracked baseline would mean thousands of LittleFS writes a year for no benefit, since the baseline is re-captured on every cold boot.

### RC522 — 3.3 V only, never 5 V

Terminal | Connects to
3.3V | 3V3
GND | GND
SDA / SS / NSS | GPIO15
SCK | GPIO14
MOSI | GPIO13
MISO | GPIO12
RST | PCF8574 P5
IRQ | unused

This is the module most often destroyed by a 5 V miswire. It is a 3.3 V part.

## 6Power distribution

#### 5 V rail — from USB / VIN

- LCD backpack VCC
- Buzzer positive terminal
- LED anodes (via series resistor)
- Level shifter HV terminal
- MQ-135 VCC — verify its supply requirement first

#### 3.3 V rail — board regulator output

- ESP8266 (its own onboard regulator)
- BMP280, DS3231, ADS1115, PCF8574
- RC522
- I²C pull-ups, reed pull-up, gate pull-downs
- Level shifter LV terminal

#### Never join the two rails

5 V and 3.3 V must meet only inside the level shifter. A single stray jumper between the LCD's VCC and an ESP8266 pin destroys the module. The shifter is the only bridge between the domains.

Decoupling: 100 nF ceramic at each module's VCC/GND, right at the pins, plus 470 µF bulk on the 5 V rail. The ESP8266's Wi-Fi bursts draw well over 300 mA — if the board's regulator or the USB lead is marginal, brownouts will look like random sensor faults.

## 7Pre-power safety checklist

#### Blocking items

- PCF8574 fitted and addressed 0x20. Without it the firmware latches Sensor Fault forever. Check it is the PCF8574, not the PCF8574A (0x38).
- DS3231 charging path. The HW-084 board charges its cell. On a non-rechargeable CR2032 that is a safety hazard — remove the charging resistor or fit a rechargeable cell. Verify which you have.
- Level shifter orientation. LV to 3V3, HV to 5V, GND to common ground. LV/HV reversed destroys the translator.

#### Verify before relying on it

- MQ-135 divider. A0 → 4.7 kΩ → ADS1115 AIN0 → 2.2 kΩ → GND. This keeps AIN0 under 3300 mV for any input up to ~10.35 V at A0. The resistor values are placeholders until measured.
- Reed switch polarity. Closed must read LOW. If your switch is normally-closed, invert the REED_CLOSED_LEVEL constant and re-test.
- Inductive reed coil. If yours has a coil rather than bare contacts, add a flyback diode with its cathode to the P0 side, anode to GND. Confirm polarity before soldering.
- Buzzer type — resolved. Use a TMB12A05 (5 V active buzzer, 12 mm, ~30 mA, 2300 Hz, built-in oscillator). A TMB12A12 is a 12 V part rated 8–15 V and will be silent at 5 V; using it would require a second power supply on a USB-powered device. Because the buzzer is active, plain on/off from the expander is correct and no tone generator is needed in firmware.

## 8Bill of materials

Decisions taken and locked: one IRFZ44N for the buzzer only, 330 Ω LED resistors, 10 kΩ reed pull-up, 5 V MQ-135 supply, two shifter channels, charging path disabled on the DS3231.

Status | Qty | Part | Specification
Have | 1 | Level shifter | 4-channel BSS138, LV1–LV4 / HV1–HV4. Channels 1 and 2 used.
BUY | 2 | PCF8574 module | 8-bit, address 0x20. One spare. Not PCF8574A (0x38).
BUY | 2 | IRFZ44N (or IRLZ44N) | TO-220 N-channel, logic-level. 1 used for the buzzer + 1 spare. Never IRF540N - Vgs(th) 2–4 V means it may not conduct at a 3.3 V gate. 100 kΩ gate pull-down, 1N4148 flyback.
BUY | 4 | 100 kΩ resistor | MOSFET gate pull-downs.
BUY | 3 | 330 Ω resistor | LED current limiting from the 5 V rail.
BUY | 1 | 1N4148 diode | Flyback across the buzzer coil.
BUY | 1 | TMB12A05 | 5 V active buzzer, 12 mm. Replaces the 12 V TMB12A12.
BUY | 1 ea | 4.7 kΩ and 2.2 kΩ | MQ-135 divider into ADS1115 AIN0.
BUY | 1 | 10 kΩ resistor | Reed pull-up on P0. Recommended for noise immunity; the PCF8574's internal 33–50 kΩ pull-up will also work.
BUY | 3 | 100 nF ceramic | Decoupling at the ESP8266 3V3 pin, the MQ-135 supply, and the 5 V rail.
BUY | 1 | 1000 µF electrolytic | Bulk capacitance on the 5 V rail. Sized for the MQ-135 heater: 33 Ω at 5 V is ~150 mA, on the same rail as the LCD backlight and buzzer, sharing a supply with the ESP8266's 300 mA+ Wi-Fi peaks.
NOT FIT | 0 | I²C pull-up resistors | Your modules almost certainly carry them. Power off, measure SDA to 3V3 — if you read ~4.7–10 kΩ they are present. Do not add a second set.
BUY | 1 | 1000 µF electrolytic | Bulk capacitance on the 5 V rail. Sized for the MQ-135 heater: 33 Ω at 5 V is ~150 mA, on the same rail as the LCD backlight and buzzer, sharing a supply with the ESP8266's 300 mA+ Wi-Fi peaks.
ACTION | — | DS3231 module | Remove the resistor feeding the VCH pin, then meter-confirm no charge current into the CR2032.

## 9Complete component inventory

Every part in the build, with the model or part number to buy. Where any module of a given kind will do, that is stated rather than inventing a part number.

### Active and sensor modules

Component | Model / part number | Form factor | Bus | Addr | Qty | Status
MCU board | ESP8266MOD on NodeMCU DevKit (v1.0 / v2 / v3) | PCB module | — | — | 1 | Have
Pressure + temperature | BME280 (Bosch) — chip id 0x60 | I²C breakout | I²C | 0x76 | 1 | Have
Gas | MQ-135 — breakout with A0 + D0 | 4-pin module | analog | — | 1 | Have
16-bit ADC | ADS1115 (Texas Instruments) — Adafruit 2349 or CJMCU-1115 | I²C breakout | I²C | 0x48 | 1 | Have
Real-time clock | DS3231 — module marked HW-084 or ZS-042 | I²C module | I²C | 0x68 | 1 | Have
RFID reader | MFRC522 13.56 MHz kit | SPI module | SPI | — | 1 | Have
Display | 16×2 character LCD, HD44780-compatible, with PCF8574 backpack | I²C module | I²C | 0x27 | 1 | Have
I/O expander | PCF8574 — 8-bit, 8 I/O | DIP-16 module | I²C | 0x20 | 2 | BUY
Level shifter | 4-channel BSS138 module (LV1–LV4 / HV1–HV4) | PCB module | I²C | — | 1 | Have
Door sensor | Reed switch, SPST normally-open, magnetic | glass tube | GPIO | — | 1 | Have
Buzzer | TMB12A05 — 5 V active magnetic, 12 mm, 2300 Hz, ~30 mA | TH 12 mm | GPIO | — | 1 | BUY

Superseded: the TMB12A12 is a 12 V part (8–15 V) and will not sound at 5 V. The A05 is the 5 V member of the same family with the same footprint.

### Discrete semiconductors

Component | Model / part number | Package | Qty | Role
N-channel MOSFET | IRFZ44N / IRLZ44N | TO-220 | 2 | 1 for the buzzer + 1 spare. Not IRF540N (Vgs(th) 2–4 V may not conduct at 3.3 V). The three LEDs need none.
Switching diode | 1N4148 | DO-35 | 1 | Flyback across the buzzer coil
Status LED — good | Green, 3 mm | TH 3 mm | 1 | Overall status: Fresh
Status LED — warning | Yellow/amber, 3 mm | TH 3 mm | 1 | Overall status: Use Soon
Status LED — alarm | Red, 3 mm | TH 3 mm | 1 | Overall status: Check Food / Sensor Fault

The LEDs are driven from the overall status, which is the worst of the zone reading and every registered item's storage duration. A zone reading that is fine will still show a fault LED if an item has passed its limit.

### Resistors

Value | Qty | Wattage | Function
4.7 kΩ | 1 | 1/4 W | MQ-135 divider, upper leg (A0 → AIN0)
2.2 kΩ | 1 | 1/4 W | MQ-135 divider, lower leg (AIN0 → GND)
10 kΩ | 1 | 1/4 W | Reed pull-up on P0. Recommended, not required — see the note below.
100 kΩ | 4 | 1/4 W | MOSFET gate pull-down, one per channel
330 Ω | 3 | 1/4 W | LED current limiting from the 5 V rail

#### Pull-up resistors: check before you fit any

I²C pull-ups are almost certainly already on your modules. The Adafruit BMP280 and ADS1115, most PCF8574 and DS3231 breakouts all carry 4.7–10 kΩ on SDA and SCL, usually with a solder bridge to remove them. The BSS138 shifter board carries its own for the LCD side. Power off and measure from SDA to 3V3: if you read roughly 4.7–10 kΩ, they are present and you do not need to fit any. Do not add a second set on top — four modules in parallel gives ~1.2 kΩ, which is acceptable but worth knowing.

No DHT11. It has been removed: the BME280 measures humidity itself. The 10 kΩ reed pull-up is the only 10 kΩ in the build.

The reed switch pull-up is the one judgement call. PCF8574 input ports have an internal pull-up of roughly 33–50 kΩ, so P0 will read HIGH with the switch open and no external resistor at all. It will work. For a bare switch on a cable sitting next to a fridge compressor, 10 kΩ is cheap insurance against noise, which is why it is listed as recommended rather than required.

### Capacitors

Value | Qty | Type | Function
100 nF | 3 | Ceramic X7R, marking 104 | At the ESP8266 3V3 pin · at the MQ-135 supply pins · on the 5 V rail
1000 µF | 1 | Electrolytic, 16 V | Bulk capacitance on the 5 V rail

#### Why capacitors cannot be delegated to the modules

A resistor is a static property — you can point a meter at it and see whether it is there. That is why pull-ups are usually already on your modules. A capacitor and a flyback diode protect against transients, and by definition you cannot confirm either with a meter before it matters.

Decoupling. The disturbance is created by the inductance of the wire connecting the module. Even 10 cm of hookup wire is roughly 50–100 nH, and a fast current edge across that inductance produces a voltage spike at the far end, at the pin. A cap soldered onto the module is at the wrong end of the wire to respond to it.

Bulk on the 5 V rail. This belongs to the shared supply path, not to any module. Three loads fight over one USB feed: ESP8266 Wi-Fi transients above 300 mA, the MQ-135 heater at ~150 mA, and the LCD backlight plus buzzer. No sensor can buffer a transient happening at the far end of the USB cable.

Only three decoupling caps are listed, not one per module. The low-current sensors draw so little that their own decoupling barely matters. The ones that count are the ESP8266 rail, the MQ-135 supply, and the 5 V bulk.

#### The one part not to economise on: the 1N4148

A buzzer is an inductive load. Switching it off makes the collapsing magnetic field generate a spike of V = L·di/dt that can reach tens of volts on a 5 V rail. That spike is created by the act of switching, which happens outside the buzzer — no module can contain it, because the module has no idea when you switch it. Every buzzer datasheet assumes you will flyback it.

Without the diode the spike lands across the MOSFET drain and couples back through the shared ground and 5 V rails into every other module. In practice: sensor faults that make no sense, MCU brownouts, and eventually a dead MOSFET. On a device meant to sit unattended in a food bank, that is a reliability landmine for about two cents.

Exception: a bare glass reed switch is just two contacts and stores no energy, so it needs no diode. Only an inductive reed coil does.

### Power and mechanical

Item | Specification | Qty | Status
Power supply | USB 5 V, 1 A minimum (ESP8266 Wi-Fi bursts exceed 300 mA) | 1 | Have
Battery | CR2032 — non-rechargeable, charging path disabled | 1 | Have
Breadboard or perfboard | Breadboard for the prototype, perfboard for the fixed build | 1 | BUY
Hookup wire | 22–26 AWG solid core | as needed | BUY
Enclosure | ABS box, vented, sized for the cold cabinet interior | 1 | BUY

#### Three part substitutions that will silently break the build

- BME280, not BMP280 — confirmed. These modules are routinely mislabelled in both directions, and the two are not interchangeable. The firmware uses the Adafruit_BME280 driver, whose begin() accepts chip id 0x60 only. A genuine BMP280 returns 0x58 and would be rejected. The two share the temperature and pressure register map, so swapping drivers to suit the part actually fitted is the correct fix, not a workaround.
- PCF8574 ≠ PCF8574A. The "A" variant answers on 0x38. The firmware looks only at 0x20, so the A version is invisible and the device latches Sensor Fault forever.
- RC522 is 3.3 V only. It is the module most often destroyed by a 5 V miswire. It is the one item in this build where giving it the "correct" 5 V rail will brick it.

Humidity now comes from the BME280. The DHT11 has been removed, so the BME280 is the only environmental sensor: temperature, pressure and humidity all come from chip id 0x60, and one failure takes all three down. This also frees GPIO16. The one thing to know is that Adafruit_BME280 has an empty constructor, so humidity oversampling reads NAN until setSampling() is called explicitly — the firmware does this at boot, because the alternative is a silent permanent humidity fault.

Generated from FreshGuard.ino — pin defines, the I²C address list, the PCF channel map and the 0xC1 configuration value are all read from the compiled source, so this document and the firmware cannot silently drift apart. GPIO numbers are authoritative; the NodeMCU silkscreen column is provisional until confirmed against your actual module.

Nothing in this document has been verified on hardware. There is no bench test, no measured current draw and no confirmed board layout behind any of it.
