zohaib-khan-786/Infernonet/InfernoNet/Documentation/FreshGuard Developer Guide.pdf

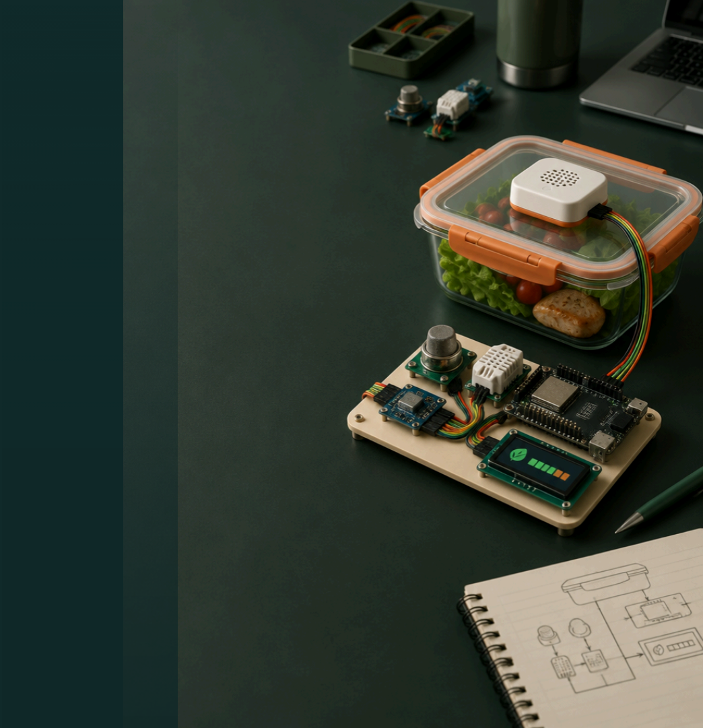
[picture p5: figure]

DEVELOPER GUIDE · SRS-ALIGNED

# FreshGuard

# IoT-Based Smart Food Freshness Monitor

Professional academic implementation guide Team Inferno-Net

SECTION 01

# Project Overview

Purpose, boundaries and success criteria

PURPOSE

Monitor food condition using environmental and gas-sensing inputs.

OBJECTIVES

Acquire sensor data; identify food; estimate freshness; notify users.

IN SCOPE

Prototype sensing, local status, dashboard and temporary
offline operation.

LIMITATIONS

Not a laboratory-grade safety instrument. Exact accuracy depends on calibration.

FRESHGUARD · DEVELOPER GUIDE | 01

SECTION 02

# System Architecture

End-to-end implementation architecture

SENSE

Environmental + gas sensors

EDGE

Controller: to be selected by team

ANALYZE

Freshness rules + storage

PRESENT

Local indicators + dashboard

FRESHGUARD · DEVELOPER GUIDE | 02

SECTION 03

# Hardware Components

Inventory derived from SRS roles

COMPONENT / ROLE | SELECTION STATUS
Controller — acquisition, logic, connectivity | To be selected by team
Gas sensor(s) — spoilage-related signal | Model to be selected by team
Temperature / humidity — context input | Model to be selected by team
Display / LEDs / buzzer — local feedback | As specified or team-selected
Power, breadboard, cables, enclosure | Document ratings and quantities
FRESHGUARD · DEVELOPER GUIDE | 03

SECTION 04

# Software Requirements

Development environment and implementation options

FIRMWARE

IDE, language and libraries: select to match controller.

CONNECTIVITY

Protocol and network
credentials: to be selected by team.

DATA

Local buffer plus remote
persistence; define schema and timestamps.

INTERFACE

Dashboard technology: use an SRS-listed option; document versions.

FRESHGUARD · DEVELOPER GUIDE | 04

SECTION 05

# Hardware & Sensor Integration

Safe wiring and traceable data flow

POWER

Verify voltage and current ratings

CONNECT

Pin mapping: to be selected by team

READ

Timestamp raw sensor samples

VALIDATE

Reject impossible or missing readings

FRESHGUARD · DEVELOPER GUIDE | 05

SECTION 06

# Calibration & Baseline

Prepare sensors before freshness monitoring

WARM UP

Follow sensor datasheet timing

BASELINE

Capture clean-air reference

EXPOSE

Use controlled food conditions

RECORD

Store date, environment and offsets

FRESHGUARD · DEVELOPER GUIDE | 06

SECTION 07

# Food Registration & Identification

Create a durable identity before monitoring

REGISTER

Create food record

IDENTIFY

Method: to be selected by team

ASSOCIATE

Link sensor stream to item ID

TRACK

Maintain status and
timestamps
FRESHGUARD · DEVELOPER GUIDE | 07

SECTION 08

# Freshness Analysis Engine

Inputs, normalization and decision flow

INPUTS

Gas, temperature, humidity, time

NORMALIZE

Apply baseline and quality checks

EVALUATE

Rules / model from
documented matrix

OUTPUT

Freshness state + confidence note

FRESHGUARD · DEVELOPER GUIDE | 08

SECTION 09

# Threshold & Decision Matrices

Document rules without inventing unspecified values

FIELD | TEAM DOCUMENTATION REQUIREMENT
Food category | Name, storage condition and expected monitoring period
Sensor input | Unit, sample interval, baseline and valid range
Threshold | Exact value: to be selected by team and justified
Decision rule | Inputs, operators, persistence window and state
Evidence | Calibration run, source and test result
FRESHGUARD · DEVELOPER GUIDE | 09

SECTION 10

# Alerts & Dashboard

Consistent feedback across local and remote channels

LOCAL

Display, LED or buzzer
communicates current state.

REMOTE

Send notification when
connectivity and configured service permit.

DASHBOARD

Show item, latest values, state, timestamp and connection
status.

MESSAGE

Use clear severity, cause, time and recommended user check.

FRESHGUARD · DEVELOPER GUIDE | 10

SECTION 11

# Offline Sync & Data Handling

Store-and-forward behavior during network loss

DETECT

Recognize connection failure

BUFFER

Queue timestamped records
locally

CONTINUE

Keep sensing and local alerts active

SYNC

Upload in order; prevent
duplicates
FRESHGUARD · DEVELOPER GUIDE | 11

SECTION 12

# Testing & Validation

Minimum IoT test matrix

SCENARIO | EXPECTED EVIDENCE
Power-up and sensor initialization | Stable boot log; failure state visible
Known environmental change | Raw values respond in plausible direction
Food state transition | Rule and alert activate as documented
Temporary network loss | Local operation continues; records buffered
Reconnect and sync | Queued records upload once, in order
FRESHGUARD · DEVELOPER GUIDE | 12

SECTION 13

# Implementation Procedure

Recommended build order

1 · DEFINE

Freeze selections and
interfaces

2 · INTEGRATE

Wire one sensor at a time

3 · IMPLEMENT

Add registration, rules and UI

4 · VALIDATE

Run matrix; package final demo

FRESHGUARD · DEVELOPER GUIDE | 13

SECTION 14

# Troubleshooting

Common prototype faults and first checks

SYMPTOM | CHECK FIRST
No sensor readings | Power rails, common ground, pin map, bus address
Values fixed or implausible | Warm-up, units, range, baseline, damaged sensor
Dashboard stale | Timestamp, network status, endpoint and credentials
Repeated alerts | Threshold hysteresis / persistence: team-defined
Sync duplicates | Record ID, acknowledgement and retry logic
FRESHGUARD · DEVELOPER GUIDE | 14

SECTION 15

# Submission & Demo Checklist

Evidence required for a reproducible prototype

REPORT

Architecture, decisions,
calibration, matrices, results and limitations.

SOURCE ZIP

Firmware, dashboard, schema, README, dependency versions; no live secrets.

DEMO

Registration → sensing →
decision → alert → offline recovery.

FINAL GATE

All placeholders resolved or explicitly marked “to be
selected by team”.
FRESHGUARD · DEVELOPER GUIDE | 15

PROJECT TEAM

### Project identity and member details Names · roles · IDs · supervisor: to be completed by team

Keep final documentation reproducible: record selected controller, pin mapping, thresholds, wiring, credentials handling and dependency versions.

# FreshGuard

# IoT-Based Smart Food Freshness Monitor

ZERO FOOD WASTE

# Inferno-Net

# Student 19389957 Muhammad Hamza Atif Student 1496338 Zohaib Khan Student1482421 Hafiz Syed Abdullah Touheed Syed Abdul Hadi Arshad Student1483763
