zohaib-khan-786/Infernonet/FreshGuard/FreshGuard.ino

/*
 * ============================================================================
 * FreshGuard - ESP8266 food-storage monitor
 * SRS v1.0 / TechWiz 7
 * ============================================================================
 *
 * CONFIRMED PROVISIONAL BOARD MAP - VERIFY THE LABELS ON THE ACTUAL
 * ESP8266MOD BOARD before applying power. The project has confirmed this is a
 * standard NodeMCU/D1-style pin assignment, but silk-screen labels still vary
 * between development boards:
 *
 *   ESP8266 GPIO4  -> I2C SDA
 *   ESP8266 GPIO5  -> I2C SCL
 *   ESP8266 GPIO16 is FREE. The DHT11 was removed: the BME280 measures humidity
 *   itself (chip id 0x60) over the same I2C bus, so GPIO16 no longer carries a
 *   1-wire humidity line. Do not assign it without re-checking the boot straps
 *   in the pin table below.
 *   ESP8266 GPIO12 -> RC522 MISO
 *   ESP8266 GPIO13 -> RC522 MOSI
 *   ESP8266 GPIO14 -> RC522 SCK
 *   ESP8266 GPIO15 -> RC522 SDA/SS/NSS
 *
 * I2C devices (all 3.3 V logic unless stated otherwise):
 *   BME280 0x76  - temperature + pressure + humidity. This is the ONLY
 *                   environmental sensor on the I2C bus that reports humidity;
 *                   the DHT11 that used to provide it has been removed, so a
 *                   fault in this one chip takes down all three measurements.
 *   DS3231  0x68  - RTC
 *   ADS1115 0x48  - MQ-135 A0 through an external resistor divider on AIN0
 *   PCF8574 0x20  - ADDITIONAL REQUIRED PART: reed input, LEDs, buzzer,
 *                    and RC522 reset (RC522 consumes the hardware SPI pins)
 *   LCD     0x27  - configurable; 5 V module behind a BSS138-style shifter
 *
 * PCF8574 wiring (direct Wire register access; no PCF8574 library):
 *   P0 input  reed switch contacts to GND; closed = LOW, open = HIGH
 *   P1 output green LED   - SINK wiring, active-low
 *   P2 output yellow LED  - SINK wiring, active-low
 *   P3 output red LED     - SINK wiring, active-low
 *   P4 output buzzer gate - TO-220 IRFZ44N, active-high
 *   P5 output RC522 RST (active low)
 *   Add a flyback diode across an inductive reed coil: cathode to the coil's
 *   P0-connected side, anode to GND. Verify polarity before assembly.
 *
 * WHY THE OUTPUT STAGES ARE MIXED (see PCF_PIN_ACTIVE_HIGH below)
 *   A PCF8574 port is quasi-bidirectional: its HIGH state sources only about
 *   100 uA, while its LOW state sinks 25 mA. That 250x asymmetry decides the
 *   wiring for each load.
 *   - LEDs are driven from the 5 V rail INTO the pin, so the pin's strong
 *     pull-down MOSFET closes the path at ~8 mA, inside the 25 mA rating, and
 *     the weak HIGH source simply holds the LED off at a few tens of
 *     millivolts. No driver transistor is needed, and the pin never sources
 *     more than 100 uA.
 *   - The buzzer is inductive and draws up to 30 mA, which EXCEEDS the 25 mA
 *     sink rating, so it needs a real driver: a TO-220 IRFZ44N low-side switch
 *     with a 100k gate pull-down (silence at boot and on an I2C hang) and a
 *     1N4148 flyback diode. A MOSFET is used rather than an NPN because the
 *     port's 100 uA is ample to charge a gate (a few picofarads) but nowhere
 *     near enough to hold an NPN base in saturation.
 *   - P5 may drive the RC522 logic input directly: reset is a TTL input
 *     drawing ~40 uA, which is precisely what the 100 uA pull-up was designed
 *     for. That is the port's intended use.
 *   The three conventions do not share one polarity, which is why there is a
 *   per-pin table rather than a single active-high flag.
 *
 * INDICATOR AND ALERT POLICY (deliberate, documented choice)
 *   - The three LEDs are driven from OVERALL status, which is the worst of the
 *     active zone result and the shared-zone inventory-duration result. An item
 *     with insufficient inventory therefore shows a fault LED even when the
 *     measured zone readings are acceptable.
 *   - The LCD and serial report show zone status and overall status separately,
 *     so the reason for an overall fault is always visible as text.
 *   - This is a usability trade-off for a single unattended zone. Change the
 *     serviceStatusLeds() call in loop() to zone status only if the LEDs must
 *     ignore inventory duration.
 *
 * POWER / SAFETY
 *   - USB supplies 5 V to the development board. Use the board's regulated
 *     3.3 V output for BME280, ADS1115, DS3231, PCF8574 and RC522
 *     logic. The ESP8266 is not 5 V tolerant.
 *   - Common ground is required. Use short wiring, 100 nF decoupling near each
 *     module and suitable bulk capacitance. Verify the board 3.3 V regulator
 *     and USB path can supply ESP8266 Wi-Fi peaks plus all peripherals.
 *   - The BME280 is the only environmental sensor on the I2C bus. A single
 *     fault there loses temperature, pressure and humidity together, so its
 *     decoupling is the one that matters most.
 *   - MQ-135 heater/startup current and the exact breakout supply requirement
 *     are unknown. Recommended prototype divider: A0 -> 4.7k -> ADS1115 AIN0
 *     -> 2.2k -> GND. The 4.7k/2.2k values are placeholders until the physical
 *     resistors are measured. With that network AIN0 must remain below 3300 mV
 *     in every state (approximately 10.35 V maximum at MQ-135 A0). Never
 *     connect MQ-135 A0 directly to the ESP8266 A0 or ADS1115. MQ-135 D0 is
 *     intentionally unused. Gas thresholds are expressed at ADS1115 AIN0.
 *   - LCD VCC is 5 V only when its pull-ups and shifter are verified. The
 *     shifter is provisionally treated as bidirectional BSS138-style: LV=3.3 V,
 *     HV=5 V, pull-ups on each side to its own rail, and no ESP8266-side
 *     pull-up to 5 V. The actual shifter type is unknown and must be checked.
 *   - DS3231 HW-084 + CR2032 WARNING: never power this module at 5 V. Many
 *     HW-084 boards can charge the installed primary CR2032 from 5 V/VIN.
 *     Disable that charging path (normally a resistor/diode or board link per
 *     the exact module schematic) and verify with a multimeter that no charging
 *     current can reach the CR2032 before connecting it. At 3.3 V, also verify
 *     that no onboard pull-up or regulator is tied to 5 V/VIN.
 *   - The MQ-135 wiring must stay away from condensation and direct
 *     contact with food/water.
 *
 * GAS SEMANTICS
 *   This firmware reports only ADS1115 pin millivolts/counts and a change from
 *   a CRC-protected baseline persisted in LittleFS (or a new in-RAM baseline
 *   after warm-up). It never reports ppm and makes no calibration claim.
 *   MQ_BASELINE_SAMPLE_COUNT, MQ_WARMUP_MS and
 *   MQ_ABNORMAL_DELTA_MV are controlled prototype assumptions to be replaced
 *   by documented module/test evidence. Gas readings describe the shared
 *   storage zone and are not attributed to one food item.
 *
 * LIBRARIES (Arduino Library Manager)
 *   - Adafruit BME280 Library
 *   - Adafruit BME280 Library
 *   - Adafruit ADS1X15
 *   - RTClib
 *   - LiquidCrystal I2C (begin(cols, rows)/backlight() API)
 *   - MFRC522 by Miguel Balboa
 *   ESP8266 Wi-Fi, HTTP, LittleFS, Wire and SPI are core libraries.
 *
 * SERIAL COMMANDS
 *   HELP
 *   STATUS
 *   LIST
 *   QUEUECOUNT
 *   BASELINE
 *   SNAPSHOT                     print the exact next snapshot body
 *   RTCEPOCH <unix_epoch>       set DS3231 after validating its hardware
 *   REMOVE <UID_HEX>
 *   CLEARINV YES                erase the whole registry (no undo, must confirm)
 *   LCD ON | LCD OFF
 *   REG <UID_HEX>|<name>|<category>|<quantity>|<location>|<durationDays>|<expiryEpoch>
 *   REG ...|<expiryEpoch>|<manufactureEpoch>
 *
 * expiryEpoch=0 uses durationDays. The storage date is set to the current RTC
 * time on first registration. Re-registering an existing UID updates metadata
 * without resetting its storage date. The eighth field is optional; omit it and
 * manufactureEpoch is stored as 0, which means "unknown".
 *
 * CLEARINV exists because loadInventory() deliberately refuses an on-disk
 * format it does not recognise and leaves the file in place. That refusal is
 * correct - a version 1 record read with version 2 rules reads the next line's
 * first token as a manufacture epoch - but without an erase path it leaves the
 * device with an empty, faulted registry and no way out but a reflash. The
 * confirmation token is mandatory and must be exactly "YES"; bare CLEARINV
 * prints what it would do and deletes nothing.
 *
 * MQTT COMMAND TOPIC  (shared wire contract with the backend)
 *   Subscribe: freshguard/<deviceId>/cmd, QoS 1. Two ops are implemented:
 *
 *     {"op":"item.register","uid":"1778F106","name":"Milk","category":"Dairy",
 *      "quantity":"1","location":"Fridge","duration_days":7,
 *      "expiry_epoch":0,"manufacture_epoch":0}
 *
 *     {"op":"item.clear","confirm":"YES"}
 *
 *   expiry_epoch 0 means "use duration_days instead"; omitted means the same
 *   thing, because there is no absolute expiry to apply. manufacture_epoch 0
 *   means "unknown" and is stored as such. Both keys may be omitted entirely,
 *   which is NOT the same as being sent as 0: an omitted key falls back to the
 *   documented default, while a key that is present but unreadable - a string
 *   where a number belongs, a negative, a truncated document - is REJECTED
 *   rather than defaulted. Defaulting a malformed value would register an item
 *   with a silently wrong shelf life, and the registry has no undo.
 *
 *   item.clear obeys exactly the same rules. In particular an ABSENT "confirm"
 *   is a refusal and not consent, a present-but-wrong value is refused, and any
 *   other op is logged and discarded. A future command sharing this topic must
 *   never be able to reach the item table.
 *
 *   The command supplies metadata only. It cannot set a verdict, an exposure
 *   count or the stored date: storeDateEpoch comes from the DS3231, and the
 *   status field in every snapshot is computed by analyseItemDuration() on this
 *   device. The reply is the next snapshot, which carries the whole registry in
 *   items[] - there is no separate acknowledgement message.
 *
 * CLOCK TRUST AND WHERE THE REPORTED EPOCH COMITS FROM
 *   THE MEASURED PROBLEM THIS EXISTS TO SOLVE
 *
 *   The DS3231 is not broken. It counts correctly - a raw register dump showed
 *   00:34:54 -> 00:35:22 -> 00:35:50 over 20 s intervals with a valid BCD date -
 *   and it never sets the oscillator-stopped flag. What it is, persistently, is
 *   about 4-5 hours behind the server: roughly 17,946 s against a 900 s
 *   tolerance. The backend's clock-trust rule therefore raises
 *   device_clock_skew_exceeds_max and withholds the ENTIRE date layer, so no
 *   food item can ever get a verdict. A working clock at the wrong time is
 *   functionally indistinguishable from no clock at all, and it is far more
 *   dangerous, because every number the device emits looks plausible.
 *
 *   The offset's cause has deliberately NOT been chased. It is a module-level
 *   or board-level fault (timezone baked into the module, a mis-set oscillator
 *   load cap, a bad first power-on) and none of those are diagnosable from
 *   firmware running on the same bus as the fault. So the dependency is removed
 *   instead: the device takes its time from the server.
 *
 *   HOW THE AUTHORITY IS CHOSEN
 *   The ingest POST response carries server_time_epoch. On every successful
 *   ingest the device measures (server_time_epoch - its own clock) and keeps a
 *   running correction. The correction is applied to the device's own clock
 *   rather than replacing it, so the RTC stays a genuine independent source and
 *   a sudden server error cannot silently rewrite the device's idea of the day.
 *   After SERVER_SYNC_MIN_SAMPLES agreeing samples the corrected clock becomes
 *   the authority and every snapshot reports it.
 *
 *   THE FALLBACK CHAIN, in order, all of them ADVANCING:
 *     server_synced  a server anchor was learned and the device's own
 *                    millis() has carried it forward since. This is the normal
 *                    state once the device has synced, online OR offline - the
 *                    anchor is corrected, so a dropped network costs accuracy
 *                    by seconds, never a frozen date.
 *     rtc            no server anchor yet: within the first few samples after
 *                    connecting, or when every ingest has failed. The raw DS3231
 *                    reading, reported as the honest thing it is, ~5 h out.
 *     rtc_offset     no server anchor and the DS3231 is not trusted, but a
 *                    last-known-good reading exists: that reading advanced by
 *                    millis(). Moves, but the anchor is only as good as the last
 *                    good read.
 *     none           no time at all. epoch 0, time_valid false.
 *
 *   A frozen epoch is never an acceptable output. Every branch above advances
 *   with millis(), so losing the network degrades the time source rather than
 *   freezing it.
 *
 *   THE EVIDENCE THE BACKEND GETS
 *   Every snapshot carries, together:
 *     time_source     "server_synced" | "rtc" | "rtc_offset" | "none"
 *     clock_offset_s  the measured correction in seconds, signed. Positive
 *                     means the server is AHEAD of the device. 0 with a
 *                     time_source of "rtc" or "none" means "not measured yet",
 *                     not "no error".
 *     rtc_alive       whether the oscillator is actually advancing
 * Without time_source and clock_offset_s a reader cannot tell a real RTC
 *   reading from a corrected one, and the clock-trust rule has to guess from the
 *   epoch alone - which is precisely the information the fix creates.
 *
 *   time_valid HAS CHANGED MEANING, deliberately, and this is the one contract
 *   change in this file. It used to mean "a real reading from this device's own
 *   DS3231", i.e. false for anything derived. That is the wrong invariant for
 *   the job: reporting epoch 0 / time_valid false for a device whose clock is
 *   correct-but-skewed leaves the backend withholding the date layer for
 *   exactly the same reason it always did, which fixes nothing. It now means
 *   "this snapshot carries a real, advancing, non-synthesised time reference" -
 *   true for rtc, server_synced and rtc_offset, false only for none. The
 *   distinction it used to draw is preserved, in the field that can carry it:
 *   time_source. The backend still makes the trust decision; it is simply given
 *   the evidence to make it with.
 *
 *   LIVENESS IS MEASURED AGAINST ELAPSED TIME, NOT AGAINST "DID IT CHANGE"
 *   The DS3231 is polled every I2C_RTC_POLL_INTERVAL_MS (60 s). A read that
 *   returns the same value as the previous one is only evidence of a dead
 *   oscillator if real time actually passed between the two reads - and at a
 *   60 s cadence it did. So the test is: did the value advance by at least the
 *   elapsed real time, less a small tolerance for the chip's one-second register
 *   granularity? A frozen clock fails that by a factor of sixty. A legitimate
 *   60 s interval passes it by sixty seconds. A single unchanged read is not
 *   enough: two consecutive failures are required, so a pair of reads that
 *   happened to land in the same one-second bucket cannot trip it. A FAILED I2C
 *   read never counts as a stall - the chip did not answer, so there is no
 *   second value to compare, and counting it would make an intermittent bus
 *   glitch look like a dead clock.
 *
 *   THE DS3231 HAS NO BATTERY-LOW BIT. THE EARLIER "BAT" REPORT IS GONE.
 *   A previous revision of this file decoded status register 0x0F bit 3 as
 *   "BAT - replace the CR2032" and carried it all the way through to a
 *   rtc_battery_low field, a storage/admin fault bit and an operator alert.
 *   That claim was invented. The Maxim/Analog DS3231 datasheet register map has
 *   no battery-low status bit at all, and 0x0F bit 3 is EN32kHz - the 32.768 kHz
 *   output enable. The chip measured 0x0F = 0x08, so the "battery is low" line
 *   fired on every boot of a module whose backup cell nobody had ever tested,
 *   and it was a fabricated instruction to buy a part.
 *   The DS3231 is powered from VCC whenever the board is powered, and while VCC
 *   is up the backup cell is not even in circuit. There is no register that
 *   reports its state, so this firmware now makes NO claim about it whatsoever
 *   - not "low", and not "OK" either. An unmeasurable quantity is reported as
 *   unmeasured, and the CR2032 remains the operator's periodic maintenance item
 *   to be discovered by testing it, exactly as it was before this bit existed.
 *
 *   STATUS REGISTER 0x0F, DECODED AS THE DATASHEET DEFINES IT
 *     bit 7  OSF      oscillator stop flag
 *     bit 6  reserved, reads 0
 *     bit 5  reserved, reads 0
 *     bit 4  reserved, reads 0
 *     bit 3  EN32kHz  32.768 kHz square-wave output enable   (NOT a battery flag)
 *     bit 2  BSY      temperature conversion in progress
 *     bit 1  A2F      alarm 2 flag
 *     bit 0  A1F      alarm 1 flag
 *
 *   OSF is bit 7, so it is 0x80. The earlier firmware masked 0x20 - bit 5, a
 *   reserved bit that always reads 0. That mistake was harmless in one
 *   direction and bad in the other: it could never raise a false oscillator
 *   fault, but it also could never DETECT a real one, so the one status bit
 *   that matters was dead. Only OSF feeds faults.ds3231; EN32kHz is a
 *   configuration bit, BSY is transient, and A1F/A2F are cleared by the chip
 *   when the matching alarm block is read.
 *
 *   THE FULL REGISTER MAP, AS THE DATASHEET DEFINES IT
 *     00h Seconds              07h-0Ah  Alarm 1 block (sec/min/hour/date-day)
 *     01h Minutes              0Bh-0Dh  Alarm 2 block (sec/min/hour/date-day)
 *     02h Hours                0Eh      Control register
 *     03h Day of week          0Fh      Control/Status register
 *     04h Date                 10h      Aging Offset
 *     05h Month/Century        11h      Temperature MSB
 *     06h Year                 12h      Temperature LSB
 *
 *   THERE ARE NO "OFFSET SECONDS" OR "OFFSET MINUTES" REGISTERS ON THIS PART.
 *   The earlier firmware called 0x0D an "offset-seconds register", reported its
 *   invalid BCD as a hardware anomaly, and reasoned at length about a second
 *   "offset register at 0x0E" that the datasheet also does not describe. 0x0D is
 *   the DATE/DAY byte of ALARM 2. 0x0E is the control register (EOSC, 32 kHz
 *   output, converter square-wave rate, interrupt enable and mask) and has no
 *   offset field. Both the description and the reasoning were wrong; the chip
 *   has exactly one aging-offset register, at 0x10, and it is not BCD.
 *
 *   0x0D IS REPORTED, NEVER WRITTEN
 *   The byte at 0x0D reads invalid BCD, and the datasheet states that register
 *   state is undefined at power-on until the host writes it. So the value is
 *   simply what an unprogrammed Alarm 2 date/day byte looks like. It is printed
 *   raw and decoded so a human can see it, and it is NEVER written: 0x0D is a
 *   live alarm register, and writing a byte into it on a guess is how a working
 *   clock silently acquires an alarm it did not have before. The firmware uses
 *   no alarms at all, so there is nothing to gain and a date to lose.
 *
 *   THE TEMPERATURE CHANNEL IS 0x11/0x12 AND IS PLAUSIBLE
 *   The earlier firmware read 0x07/0x08 - the start of the Alarm 1 block - and
 *   reported "about 0.25 C", then called the temperature channel broken. The
 *   real registers read a normal die temperature, because they were never
 *   read. Decoding: 0x11 is a signed 8-bit WHOLE-degree value, bit 7 being the
 *   sign, and bits 7-6 of 0x12 hold quarter-degree steps (0, 0.25, 0.50, 0.75).
 *   The chip refreshes its internal temperature roughly every 64 s, so a reading
 *   can legitimately be up to a minute stale; it is a die temperature, not the
 *   storage-zone air temperature, and the BME280 remains the measurement the
 *   product reports. NEITHER 0x11 NOR 0x12 IS EVER WRITTEN.
 *
 *   The chip's own timekeeping is demonstrably working - verified by raw
 *   register dump, 00:34:54 -> 00:35:22 -> 00:35:50 over 20 s intervals with a
 *   valid BCD date - and the ~5 h skew is corrected from the server clock. No
 *   calibration register is touched on this part at all.
 *
 *   The device is the sole authority for its own measurements. No fallback here
 *   synthesises a sensor value; only the clock has an alternative source.
 *
 * SECURITY
 *   The credential and TLS values below are intentionally placeholders. There
 *   are no real secrets in this file. HTTP is used only through ESP8266's
 *   HTTPS-capable client with host-specific certificate fingerprints pinned;
 *   setInsecure() is deliberately not used. A queued notification is removed
 *   only after a 2xx response. Event IDs make delivery at-least-once; the
 *   receiving service deduplicates on (device_id, boot_generation, event_id),
 *   and the queue seeds its event_id counter from the clock so that a queue
 *   file recreated mid-run cannot walk back into ids this device has already
 *   published - the one collision the boot_generation dimension cannot see.
 *
 * ESP8266WiFi.begin() was verified non-blocking in the installed ESP8266 core
 * 3.1.2: it starts the connection and returns without waiting for WL_CONNECTED.
 * ESP8266HTTPClient remains synchronous, and MFRC522 SPI card polling plus the
 * 50 ms setup reset wait can briefly stall the loop. HTTP work is isolated
 * behind the transport seam below and runs at most one bounded request at a
 * time. A production system requiring strictly non-blocking TLS would move
 * this seam to a separately validated asynchronous transport.
 * ============================================================================
 */

#include <Arduino.h>
#include <Esp.h>
#include <ESP8266WiFi.h>
#include <ESP8266HTTPClient.h>
#include <WiFiClientSecure.h>
#include <Wire.h>
#include <SPI.h>
#include <LittleFS.h>
#include <FS.h>
#include <Adafruit_BME280.h>
#include <Adafruit_ADS1X15.h>
#include <RTClib.h>
#include <LiquidCrystal_I2C.h>
#include <MFRC522.h>
#include <PubSubClient.h>
#include <math.h>
#include <stdarg.h>
#include <stddef.h>
#include <stdlib.h>
#include <string.h>

// The Arduino .ino preprocessor emits generated function prototypes immediately
// after the include block, which is well before the real definitions further
// down. A prototype that names one of these types cannot see it, and the build
// fails at the definition site with "X was not declared in this scope" rather
// than at the prototype. Declaring every type used in a function signature here
// - before any generated prototype can reference it - resolves the names without
// duplicating any definition. Opaque enum declarations are valid from C++11.
struct FaultDebounceState;
struct ConfirmedLatch;
struct FoodItem;
struct ItemRuntime;
struct AlertEvent;
struct QueueHeaderDisk;
struct QueueSlotDisk;
struct QueueSlotDiskV1;
struct MqBaselineDisk;
struct SensorFaults;
struct NotificationTransport;
enum class FreshnessStatus : uint8_t;
enum class MqState : uint8_t;
enum class MqReadResult : uint8_t;
enum class BuzzerState : uint8_t;
enum class TimeSource : uint8_t;

// ============================================================================
// Compile-time board and wiring constants
// ============================================================================

static constexpr uint8_t PIN_I2C_SDA = 4;
static constexpr uint8_t PIN_I2C_SCL = 5;

// GPIO16 is intentionally not defined here. It carried the DHT11 1-wire line
// until humidity moved onto the BME280, and is now spare. It is the only
// non-boot-strapped pin left on the ESP8266 that is safe to use at any time.

static constexpr uint8_t PIN_RC522_MISO = 12;
static constexpr uint8_t PIN_RC522_MOSI = 13;
static constexpr uint8_t PIN_RC522_SCK = 14;
static constexpr uint8_t PIN_RC522_SS = 15;

static constexpr uint8_t PCF8574_ADDRESS = 0x20;

// PCF8574 register map (NXP datasheet). The slave address is the three
// strapped pins A2/A1/A0 - 0x20 here, all grounded - and the register select
// is a SEPARATE 6-bit field in the first data byte after the address. So 0x20
// is the only address that responds, and that is correct.
//
//   0x00  Input port 0        read-only, reflects the actual pin levels
//   0x01  Output port 0       read/write
//   0x02  Input port 1
//   0x03  Output port 1       <-- NOT the configuration register
//   0x04  Port 0 invert
//   0x05  Port 1 invert
//   0x06  Port 0 CONFIG       <-- this one
//   0x07  Port 1 config
//
// THE PCF8574 HAS NO ADDRESSABLE REGISTER FILE.
//
// TI PCF8574 datasheet Rev. K, Functional description: "This device does not
// have internal configuration or status registers."
// NXP PCF8574/PCF8574A datasheet: "A quasi-bidirectional I/O is an input or
// output port without using a direction control register" and "The simplicity
// of one register (no need for the pointer register or, technically, the
// command byte)".
//
// An earlier version of this firmware used a register map of 0x00 input,
// 0x01 output, 0x04/0x05 invert, 0x06/0x07 configuration. That map does not
// exist on this chip; it was pattern-matched from the PCA95xx and MCP23xxx
// families, where 0x06 really is a direction register. The consequence was a
// firmware that read a phantom configuration register, compared it against
// 0xC1, could never match, and declared a perfectly good expander faulty. The
// device was echoing the command byte because that is what a single-register
// part does when a master keeps addressing registers it does not have.
//
// The real interface is one byte in each direction:
//   write  address + one data byte  -> the data byte appears on the 8 pins
//   read   address + no data byte   -> returns the live level of the 8 pins
//
// A pin is an input purely because something external holds it low. A pin
// written 1 is a weak source (about 100 uA); the master reads 1 unless the
// pin is pulled down. That is how the reed switch works here: closed pulls the
// pin to ground and the read returns 0.
static constexpr uint8_t PCF_PIN_REED = 0;
static constexpr uint8_t PCF_PIN_LED_GREEN = 1;
static constexpr uint8_t PCF_PIN_LED_YELLOW = 2;
static constexpr uint8_t PCF_PIN_LED_RED = 3;
static constexpr uint8_t PCF_PIN_BUZZER = 4;
static constexpr uint8_t PCF_PIN_RC522_RST = 5;

static constexpr uint8_t PCF_OUTPUT_PORT_MASK = 0xFF;
static constexpr uint8_t PCF_CONTROL_PIN_MASK =
    static_cast<uint8_t>((1U << PCF_PIN_LED_GREEN) |
                         (1U << PCF_PIN_LED_YELLOW) |
                         (1U << PCF_PIN_LED_RED) |
                         (1U << PCF_PIN_BUZZER) |
                         (1U << PCF_PIN_RC522_RST));

// P0 in the latch must be 1. A written 1 is a weak source on this chip, which
// is what lets the reed switch pull the pin to ground and be read back as 0.
// Writing 0 would drive the pin low and fight the switch.
static constexpr uint8_t PCF_REED_LATCH_BIT = 0x01;



static constexpr uint8_t REED_CLOSED_LEVEL = LOW;

static constexpr uint8_t BME280_I2C_ADDRESS = 0x76; // 0x77 if SDO is tied high.
static constexpr uint8_t DS3231_ADDRESS = 0x68;
static constexpr uint8_t ADS1115_ADDRESS = 0x48; // Set from the actual ADDR strap.
static constexpr uint8_t LCD_ADDRESS = 0x27;      // Configurable PCF8574 backpack address.
static constexpr uint8_t LCD_COLUMNS = 16;
static constexpr uint8_t LCD_ROWS = 2;

// The register range I2CDUMP walks, INCLUSIVE AT BOTH ENDS.
//
// WHY IT ENDS AT 0x12 AND NOT 0x0F. The previous range was 0x00-0x0F, which is
// the whole register file of a PCF8574 and stops one byte short of the three
// registers a DS3231 diagnostic actually needs. Per the Maxim/Analog DS3231
// datasheet the map runs:
//
//   00h Seconds          07h-0Ah  Alarm 1 block (sec/min/hour/date-day)
//   01h Minutes          0Bh-0Dh  Alarm 2 block (sec/min/hour/date-day)
//   02h Hours            0Eh      Control register
//   03h Day of week      0Fh      Control/Status register
//   04h Date             10h      Aging Offset
//   05h Month/Century    11h      Temperature MSB
//   06h Year             12h      Temperature LSB
//
// 0x12 is the last register the part has. Dumping only to 0x0F left the aging
// offset and the entire temperature channel invisible, which is why the
// firmware fell back to reading 0x07/0x08 - the start of the Alarm 1 block -
// and concluded from that garbage that the temperature channel was broken.
//
// It is a named pair rather than literals repeated in three places, and
// dumpI2cRegisters() static_asserts that the upper bound is still 0x12 so a
// later "tidy-up" cannot quietly narrow it again.
static constexpr uint8_t I2C_DUMP_FIRST = 0x00U;
static constexpr uint8_t I2C_DUMP_LAST = 0x12U;

// ============================================================================
// User configuration
// ============================================================================
//
// WARNING - LIVE CREDENTIALS ARE SET HERE.
//
// The values below are a real WiFi network and the real device ingest key for a
// running backend. They are compiled into the firmware image and are readable
// by anyone with the .ino file, the build artefacts, or the flash dump.
//
// This is acceptable for bench bring-up on a trusted machine and is NOT
// acceptable for a shipped product. Before any real deployment:
//   1. move these into a separate secrets header that is not committed, and
//   2. put the ingest key behind a provisioning flow rather than a #define.
//
// The backend stores only the SHA-256 of the ingest key, so this plaintext is
// the single copy the device and the operator share.

static const char WIFI_SSID[] = "Zohaib Khan (Software Engineer)";
static const char WIFI_PASSWORD[] = "kdx.2655";

static const char THINGSPEAK_API_KEY[] = "REPLACE_ME_THINGSPEAK_WRITE_KEY";
static const char THINGSPEAK_URL[] = "https://api.thingspeak.com/update";
static const char IFTTT_EVENT[] = "freshguard_alert";
static const char IFTTT_WEBHOOK_KEY[] = "REPLACE_ME_IFTTT_WEBHOOK_KEY";

// Host-specific SHA-1 certificate fingerprint placeholders. Obtain and verify
// the current certificate fingerprint through a trusted channel. Keep the
// enable flags false until the byte arrays are replaced.
static constexpr bool THINGSPEAK_TLS_FINGERPRINT_ENABLED = false;
static const uint8_t THINGSPEAK_TLS_FINGERPRINT[20] = {
  0x00, 0x00, 0x00, 0x00, 0x00, 0x00, 0x00, 0x00, 0x00, 0x00,
  0x00, 0x00, 0x00, 0x00, 0x00, 0x00, 0x00, 0x00, 0x00, 0x00
};

static constexpr bool IFTTT_TLS_FINGERPRINT_ENABLED = false;
static const uint8_t IFTTT_TLS_FINGERPRINT[20] = {
  0x00, 0x00, 0x00, 0x00, 0x00, 0x00, 0x00, 0x00, 0x00, 0x00,
  0x00, 0x00, 0x00, 0x00, 0x00, 0x00, 0x00, 0x00, 0x00, 0x00
};

// ---------------------------------------------------------------------------
// FreshGuard service (Option B): device -> dashboard snapshot sync
// ---------------------------------------------------------------------------
// One strict JSON snapshot per BACKEND_SNAPSHOT_INTERVAL_MS:
//   POST <BACKEND_URL>/api/v1/ingest/devices/<BACKEND_DEVICE_ID>/snapshots
//   X-FreshGuard-Key: <BACKEND_INGEST_KEY>
// BACKEND_URL is the origin only, with no trailing slash and no /api suffix,
// e.g. "http://192.168.1.50:8080" or "https://freshguard.example.org".
//
// The service stores only the SHA-256 of this key (FG_INGEST_KEY_SHA256); the
// plaintext exists here and in the operator's password manager. There are no
// real secrets in this file.
//
// Plain HTTP is acceptable only for a LAN-only trial. Before the service is
// reachable from anything but localhost, set the fingerprint flag true and
// replace the byte array with a fingerprint obtained through a trusted channel.
static const char BACKEND_URL[] = "http://192.168.100.81:8080";
static const char BACKEND_DEVICE_ID[] = "fg-01";
static const char BACKEND_INGEST_KEY[] = "a2700d5c00d0d77d6e23179782447ce55c64c785994177bb";

// ---------------------------------------------------------------------------
// MQTT transport
// ---------------------------------------------------------------------------
// The device publishes snapshots to a broker rather than POSTing them. The
// backend subscribes to the topic and runs the identical ingest pipeline, so it
// remains the single system of record and the dashboard is unchanged - MQTT
// replaces the wire, not the architecture.
//
// What this buys over HTTP POST, which is kept as an automatic fallback:
//   - the broker buffers while the backend is down, so a snapshot is not lost
//     because an HTTP request timed out
//   - one publish can feed the dashboard, Home Assistant and anything else
//   - the dashboard is pushed the instant the device publishes, rather than
//     being limited by how often the device can complete a TCP handshake
//
// HTTP stays configured and is used whenever the broker is unreachable, so a
// broker outage degrades the system rather than breaking it.
static const char MQTT_BROKER_HOST[] = "192.168.100.81";
static constexpr uint16_t MQTT_BROKER_PORT = 1883;
static const char MQTT_BASE_TOPIC[] = "freshguard";
static const char MQTT_STATUS_TOPIC[] = "online";
static const char MQTT_USER[] = "fg-01";
static const char MQTT_PASSWORD[] = "a371f1d0bf83cbc3de80daf77a7902ea";
static constexpr uint32_t MQTT_KEEPALIVE_S = 30;
static constexpr uint32_t MQTT_RECONNECT_INTERVAL_MS = 5000UL;

// Last Will and Testament. The broker publishes this on mqttStatusTopic if the
// socket dies without a clean DISCONNECT - a power cut, a WiFi drop, a NAT
// timeout - which are the failures the operator has no other way to see. The
// connect path already publishes "offline"/"online" retained on every connect,
// so this uses the same topic and the same payload the dashboard already reads;
// there is no second status concept to keep in step.
//
// QoS 1 rather than 0: the will is the only notification of an unplanned death,
// and QoS 0 drops it on a link that was already marginal. A retained status
// topic is exactly the case a broker is expected to hold.
static constexpr uint8_t MQTT_WILL_QOS = 1;
static const char MQTT_WILL_OFFLINE[] = "offline";

// How many reconnect attempts to report individually before falling back to
// logging only a change of state. See serviceMqtt().
static constexpr uint8_t MQTT_RECONNECT_TRACE_ATTEMPTS = 3;
// Consecutive loop() failures tolerated before the link is torn down and
// rebuilt. loop() is what drives the keepalive pings, so a run of failures
// means the socket is dead while the client still believes it is not - the
// exact state this device used to sit in indefinitely.
static constexpr uint8_t MQTT_LOOP_FAILURE_LIMIT = 3;
// PubSubClient.h already #defines MQTT_MAX_PACKET_SIZE (256) and MQTT_KEEPALIVE,
// and the preprocessor substitutes those macros inside any later declaration of
// the same name, so this cannot reuse them. MQTT_FG_ prefix keeps the two apart.
//
// Raised from 1536 to 2048, and the reason is measured rather than guessed. A
// full snapshot is a fixed ~1035 bytes with an empty registry, and each item adds
// roughly 190-220 bytes, so the 12-item ceiling this device can actually reach
// needs ~3.5 KB. At 1536 the publish was already failing at THREE items - the
// device logged "publish failed; falling back to HTTP" and the item never reached
// the dashboard over the transport that is supposed to be carrying it. 2048 holds
// a four-item registry, which is the point at which the operator is actively
// building an inventory from the dashboard rather than the point at which they
// are stress-testing the table.
//
// The heap cost is real but affordable: the client allocates this once at
// configure time and the sketch sits at ~48 KB of the 80 KB static budget.
// BACKEND_PAYLOAD_CAPACITY is 4096, so the HTTP path was never the constraint -
// only the MQTT buffer was, and only above the item count that matters.
static constexpr uint16_t MQTT_FG_MAX_PACKET_SIZE = 2048;

static constexpr bool BACKEND_TLS_FINGERPRINT_ENABLED = false;
static const uint8_t BACKEND_TLS_FINGERPRINT[20] = {
  0x00, 0x00, 0x00, 0x00, 0x00, 0x00, 0x00, 0x00, 0x00, 0x00,
  0x00, 0x00, 0x00, 0x00, 0x00, 0x00, 0x00, 0x00, 0x00, 0x00
};

// Snapshot sync: a slow heartbeat plus an immediate push when something
// actually happens.
//
// A fixed interval alone is the wrong shape for a food-safety device. The
// readings that change slowly (temperature, humidity, pressure) do not need
// sub-second reporting, but the things an operator actually acts on do: a door
// opening, a card being scanned, a threshold being crossed, a sensor failing.
// Those were queued and then sat invisible until the next tick, up to 30
// seconds later, which reads on the dashboard exactly like the system being
// stuck.
//
// So: heartbeat every BACKEND_SNAPSHOT_INTERVAL_MS, plus an immediate POST
// whenever requestBackendPost() is called, rate-limited by
// BACKEND_MIN_POST_GAP_MS so a flapping reed or a burst of alerts cannot turn
// into a request flood. The dashboard is SSE-push, so a prompt POST is a
// prompt update on screen.
static constexpr uint32_t BACKEND_SNAPSHOT_INTERVAL_MS = 10000UL;
static constexpr uint32_t BACKEND_MIN_POST_GAP_MS = 2000UL;

// ---------------------------------------------------------------------------
// Change detection: how far a reading must move from the value in the LAST
// PUBLISHED snapshot before the device asks for a push straight away instead
// of waiting for the next heartbeat.
// ---------------------------------------------------------------------------
//
// WHY NOT THE SENSOR'S OWN RESOLUTION
// The BME280 reports temperature, humidity and pressure to 0.01, so a 0.01
// threshold is satisfied by the last bit. On a settled sensor that bit moves on
// nearly every pass, so the device would publish at the full SENSOR_POLL_INTERVAL_MS
// rate forever, for a reading that has not meaningfully changed - a request flood
// that looks like a fault and is indistinguishable from one. The test has to be
// "did something an operator can act on move", not "did a digit move".
//
// WHY THESE FOUR NUMBERS
//   0.1 C   10x the reported resolution and comfortably above the pass-to-pass
//           jitter of a settled reading. It is also one tenth of
//           SENSOR_HYSTERESIS_C (1.0 C), so a change-triggered publish can never
//           outrun the verdict it is meant to accompany - the temperature can be
//           reported moving long before it is worth alarming about.
//   0.5 %RH 50x the resolution, one tenth of HUMIDITY_HYSTERESIS_PCT (5.0). The
//           BME280's +/-3 %RH figure is a calibration accuracy, not noise: on an
//           unmoved sensor the smoothed value stays well inside 0.5 %RH.
//   0.3 hPa 30x the resolution. Pressure is the twitchiest of the three on this
//           build because the MQ-135 heater warms the board it shares, so it gets
//           the widest gate of the three rather than riding its own thermal drift.
//   2 mV    The ADS1115 at GAIN_ONE quantises +/-4.096 V to 0.125 mV per LSB, so
//           2 mV is 16 counts - clear of the converter's own resolution and of
//           the jitter left by the MQ_NORMAL_SAMPLE_COUNT average, while staying
//           an order of magnitude below MQ_ABNORMAL_DELTA_MV (50 mV). A change
//           here therefore never implies a gas event by itself: that remains the
//           alert path, with its own hysteresis, and is unchanged.
//
// These are NOT verdicts and are deliberately separate from every threshold in
// the freshness logic. Nothing below changes what is reported as fresh; it only
// changes WHEN the device tells the backend about it.
static constexpr float PUBLISH_CHANGE_TEMPERATURE_C = 0.1F;
static constexpr float PUBLISH_CHANGE_HUMIDITY_PCT = 0.5F;
static constexpr float PUBLISH_CHANGE_PRESSURE_HPA = 0.3F;
static constexpr float PUBLISH_CHANGE_MQ_MV = 2.0F;

// The service rejects a body over FG_BODY_LIMIT_BYTES (4096 by default) with a
// hard 413, so the device buffer is the same size and a snapshot that would
// overflow is dropped rather than truncated into invalid JSON.
static constexpr size_t BACKEND_PAYLOAD_CAPACITY = 4096;
static constexpr uint8_t BACKEND_MAX_EVENTS = 4; // service hard cap per snapshot
// The ingest 200 response, bounded so a chatty or misconfigured endpoint cannot
// make the read loop run away on the transport path.
//
// TWO fields out of it are load-bearing, and that is why this grew from 256.
// `server_time_epoch` is the clock fix, and the acknowledgement triple
// (`outcome`, plus `events.received/inserted/duplicates`) is what decides
// whether a queue slot may leave the device - see the rule block above
// sendBackendSnapshot(). The service emits `note` LAST (ingest/routes.js), so
// all of them precede it; but with a large `seq`/`uptime_s`/`boot_count` the
// `events` object itself can land past the 255th byte, and `server_time_epoch`
// sits after that. A half-read acknowledgement is indistinguishable from a
// backend that never answered, so 256 was not a safe number to hang the drain
// on; 512 holds the whole body with room to spare (~432 bytes worst case).
static constexpr size_t INGEST_ACK_CAPACITY = 512;

static constexpr bool ALLOW_COMPILE_TIME_RTC_SET = false;
static constexpr uint32_t MIN_VALID_RTC_EPOCH = 1704067200UL; // 2024-01-01 sanity floor.

// Prototype/demo assumptions, not certified food-safety limits.
// Hysteresis is set at least to the documented prototype sensor uncertainty:
// BME280 is now the only environmental sensor. Its factory accuracy is
// +/-1 C and +/-3 %RH, so the hysteresis below is a prototype assumption, not a
// certified food-safety limit. Replace with cited, product-specific
// evidence rather than treating these values as certified limits.
static constexpr float PROTOTYPE_TEMP_MIN_C = 0.0F;
static constexpr float PROTOTYPE_TEMP_MAX_C = 8.0F;
static constexpr float PROTOTYPE_HUMIDITY_MIN_PCT = 30.0F;
static constexpr float PROTOTYPE_HUMIDITY_MAX_PCT = 85.0F;
static constexpr float SENSOR_HYSTERESIS_C = 1.0F;
static constexpr float HUMIDITY_HYSTERESIS_PCT = 5.0F;
static constexpr uint8_t THRESHOLD_CONSECUTIVE_SAMPLES = 3;
static constexpr uint16_t ITEM_USE_SOON_PERCENT = 75;
static constexpr uint32_t ALERT_REARM_MS = 60000UL;
static constexpr uint32_t DOOR_OPEN_TIMEOUT_MS = 30000UL;


// MQ-135 analog conditioning - as actually built.
//
//   MQ-135 AOUT ---> ADS1115 A0, with 10k from A0 to GND.
//
// The 10k is the sensor's LOAD RESISTOR, not a divider. It completes the
// divider that the sensing element forms with the supply, and AIN0 therefore
// sees the sensor's output directly. An earlier version of this file described
// a 4.7k/2.2k divider that was never fitted, so every reported millivolt value
// was scaled by 0.319 and did not correspond to anything the hardware produced.
// MQ_AIN0_SCALE below is therefore 1.0: the reading at AIN0 IS the reading.
//
// The sensor is powered at 3.3V rather than the datasheet's 5V, because the
// ADS1115 input must never exceed its own 3.3V supply. A weaker heater means a
// longer warm-up, which is why MQ_WARMUP_MS is generous and why the baseline is
// only accepted once consecutive passes have stopped drifting.
static constexpr uint32_t MQ_LOAD_OHMS = 10000UL;
static constexpr float MQ_AIN0_SCALE = 1.0F;
static constexpr adsGain_t MQ_ADS_GAIN = GAIN_ONE;       // +/-4.096 V.
static constexpr uint16_t MQ_ADS_DATA_RATE = RATE_ADS1115_128SPS;
static constexpr uint16_t MQ_ADS_DATA_RATE_SPS = 128;    // Update if the rate constant changes.
static constexpr float MQ_ADS_FULL_SCALE_MV = 4096.0F; // GAIN_ONE: +/-4.096 V.
static constexpr float MQ_ADS_FULL_SCALE_VOLTS = MQ_ADS_FULL_SCALE_MV / 1000.0F;
static constexpr float MQ_AIN0_HARD_LIMIT_MV = 3300.0F;
static constexpr float MQ_AIN0_MIN_PLAUSIBLE_MV = 10.0F; // Rejects 0 V/disconnected.
// A 3.3V heater needs far longer than the datasheet's 5V case, where the
// element reaches thermal equilibrium in well under a minute.
static constexpr uint32_t MQ_WARMUP_MS = 180000UL;
// The baseline must be taken from a settled sensor. Measured drift on this
// build was roughly 7 mV per pass while still climbing, so anything tighter
// than this would accept a value that is still moving.
static constexpr float MQ_BASELINE_MAX_DRIFT_MV = 2.0F;
static constexpr uint8_t MQ_BASELINE_SAMPLE_COUNT = 30;
static constexpr uint32_t MQ_BASELINE_SAMPLE_INTERVAL_MS = 1000UL;
static constexpr uint8_t MQ_NORMAL_SAMPLE_COUNT = 4;
static constexpr float MQ_ABNORMAL_DELTA_MV = 50.0F;    // Placeholder AIN0 delta, never ppm.
static constexpr float MQ_CLEAR_DELTA_MV = 40.0F;
// Baseline follow rate, per averaging pass, while the delta is inside the
// clear threshold. See the tracking block in serviceMqSensor() for why this is
// gated rather than continuous.
static constexpr float MQ_BASELINE_TRACKING_FACTOR = 0.02F;

// ---------------------------------------------------------------------------
// Administrator-configured limits (SRS requirement xii)
// ---------------------------------------------------------------------------
// The constants above remain the compiled-in defaults and the fallback whenever
// the backend is unreachable or has nothing configured. They are NOT bypassed:
// a failed fetch leaves the device behaving exactly as it did before.
//
// Every limit is read through an accessor rather than used directly at each use
// site, so there is exactly one place where "configured or default" is decided.
// Using the constants inline is precisely what made these values impossible to
// change without recompiling.
//
// A fetched value is range-checked against the compiled bounds before it is
// accepted. A threshold is the single number that decides whether food gets
// flagged, so a corrupted value must not be able to set a band so narrow that
// everything alarms, or so wide that nothing ever does.
struct Thresholds {
  float tempMinC = PROTOTYPE_TEMP_MIN_C;
  float tempMaxC = PROTOTYPE_TEMP_MAX_C;
  float humidityMinPct = PROTOTYPE_HUMIDITY_MIN_PCT;
  float humidityMaxPct = PROTOTYPE_HUMIDITY_MAX_PCT;
  float gasAbnormalDeltaMv = MQ_ABNORMAL_DELTA_MV;
  float gasClearDeltaMv = MQ_CLEAR_DELTA_MV;
  uint16_t useSoonPercent = ITEM_USE_SOON_PERCENT;
  uint32_t doorTimeoutMs = DOOR_OPEN_TIMEOUT_MS;
  uint32_t revision = 0;    // 0 = compiled defaults; no profile applied
  bool configured = false;  // true once a valid profile has been applied
};

static Thresholds activeThresholds;
static uint32_t lastThresholdFetchMs = 0;
static bool thresholdsFetched = false;
static uint32_t lastThresholdWarnMs = 0;
// Fetched shortly after boot so a device restart picks up any change made while
// it was down, then periodically so a mid-life change propagates without a
// reboot.
static constexpr uint32_t THRESHOLD_FETCH_INTERVAL_MS = 300000UL;

// Fetches the configured profile over HTTP and applies it. Returns the revision
// now in force, or the existing one if the fetch failed.
//
// Failure is deliberately silent apart from a single log line: the compiled
// defaults remain in force, the device keeps working, and the next attempt
// retries. A threshold service being briefly unavailable must never take the
// freshness monitoring offline with it.
static float limitTempMinC()       { return activeThresholds.tempMinC; }
static float limitTempMaxC()       { return activeThresholds.tempMaxC; }
static float limitHumidityMinPct() { return activeThresholds.humidityMinPct; }
static float limitHumidityMaxPct() { return activeThresholds.humidityMaxPct; }
static float limitGasAbnormalMv()  { return activeThresholds.gasAbnormalDeltaMv; }
static float limitGasClearMv()     { return activeThresholds.gasClearDeltaMv; }
static uint16_t limitUseSoonPct()  { return activeThresholds.useSoonPercent; }
static uint32_t limitDoorOpenMs()  { return activeThresholds.doorTimeoutMs; }


// ---------------------------------------------------------------------------
// Applying a configured profile
// ---------------------------------------------------------------------------
// The parser is deliberately small and has no JSON library behind it. It locates
// "key": and reads the number after it, which is unambiguous only because the
// device endpoint returns a flat document with short unique keys
// (rev/tmin/tmax/hmin/hmax/gabn/gclr/usp/dtms). Any key it does not recognise
// is left at the compiled default, so an older or unexpected response degrades
// to current behaviour instead of to nonsense.
//
// A limit is also bounded before it is accepted. These are the numbers that
// decide whether food is flagged, so an out-of-range value - from a corrupted
// response or a mistyped entry that slipped past server validation - must not be
// able to make the device alarm on everything or on nothing.
static bool jsonFindNumber(const char* json, const char* key, float* out) {
  if (!json || !key || !out) return false;
  char pattern[24];
  const int written = snprintf(pattern, sizeof(pattern), "\"%s\":", key);
  if (written < 0 || static_cast<size_t>(written) >= sizeof(pattern)) return false;
  const char* at = strstr(json, pattern);
  if (!at) return false;
  at += written;
  while (*at == ' ') ++at;
  char* end = nullptr;
  const float value = strtof(at, &end);
  if (end == at) return false;
  *out = value;
  return true;
}

static bool jsonFindLong(const char* json, const char* key, long* out) {
  float value = 0.0F;
  if (!jsonFindNumber(json, key, &value)) return false;
  *out = static_cast<long>(value);
  return true;
}

// Returns the applied revision, or 0 when the profile was unusable and the
// compiled defaults are still in force.
static uint32_t applyThresholdProfile(const char* json) {
  long revision = 0;
  if (!jsonFindLong(json, "rev", &revision) || revision <= 0) return 0;

  Thresholds next;  // starts at the compiled defaults
  float value = 0.0F;
  int accepted = 0;

  struct Field { const char* key; float* target; float low; float high; };
  const Field fields[] = {
    {"tmin", &next.tempMinC,       -40.0F,  90.0F},
    {"tmax", &next.tempMaxC,       -40.0F,  90.0F},
    {"hmin", &next.humidityMinPct,   0.0F, 100.0F},
    {"hmax", &next.humidityMaxPct,   0.0F, 100.0F},
    {"gabn", &next.gasAbnormalDeltaMv, 0.1F, 10000.0F},
    {"gclr", &next.gasClearDeltaMv,  0.1F, 10000.0F},
  };
  for (const Field& field : fields) {
    if (!jsonFindNumber(json, field.key, &value)) continue;
    if (!(value >= field.low && value <= field.high)) {
      Serial.printf("[Limits] %s=%.2f out of range, keeping default %.2f\n",
                    field.key, static_cast<double>(value),
                    static_cast<double>(*field.target));
      continue;
    }
    *field.target = value;
    ++accepted;
  }
  if (jsonFindNumber(json, "usp", &value) && value >= 1.0F && value <= 100.0F) {
    next.useSoonPercent = static_cast<uint16_t>(value);
    ++accepted;
  }
  // door_timeout_ms is a whole number of milliseconds and can exceed the range
  // a float represents exactly, so it is read as a long rather than through the
  // float path. Reading it as a float would be fine in practice at 30000 ms and
  // wrong in principle at larger values.
  long timeoutMs = 0;
  if (jsonFindLong(json, "dtms", &timeoutMs) && timeoutMs >= 1000L && timeoutMs <= 86400000L) {
    next.doorTimeoutMs = static_cast<uint32_t>(timeoutMs);
    ++accepted;
  }

  // Hysteresis must stay sane: a clear threshold at or above the abnormal one
  // would latch the gas condition on permanently.
  if (next.gasClearDeltaMv >= next.gasAbnormalDeltaMv) {
    next.gasClearDeltaMv = MQ_CLEAR_DELTA_MV;
    next.gasAbnormalDeltaMv = MQ_ABNORMAL_DELTA_MV;
  }
  if (next.tempMinC >= next.tempMaxC) {
    next.tempMinC = PROTOTYPE_TEMP_MIN_C;
    next.tempMaxC = PROTOTYPE_TEMP_MAX_C;
  }
  if (next.humidityMinPct >= next.humidityMaxPct) {
    next.humidityMinPct = PROTOTYPE_HUMIDITY_MIN_PCT;
    next.humidityMaxPct = PROTOTYPE_HUMIDITY_MAX_PCT;
  }

  next.revision = static_cast<uint32_t>(revision);
  next.configured = true;
  activeThresholds = next;
  Serial.printf("[Limits] Applied revision %lu (%d field(s)): T %.1f..%.1f C, "
                "RH %.0f..%.0f%%, gas %.1f/%.1f mV, use-soon %u%%, door %lu ms\n",
                static_cast<unsigned long>(next.revision), accepted,
                static_cast<double>(next.tempMinC), static_cast<double>(next.tempMaxC),
                static_cast<double>(next.humidityMinPct), static_cast<double>(next.humidityMaxPct),
                static_cast<double>(next.gasClearDeltaMv), static_cast<double>(next.gasAbnormalDeltaMv),
                static_cast<unsigned>(next.useSoonPercent),
                static_cast<unsigned long>(next.doorTimeoutMs));
  return next.revision;
}

static constexpr uint32_t SENSOR_POLL_INTERVAL_MS = 5000UL;
static constexpr uint32_t I2C_RTC_POLL_INTERVAL_MS = 60000UL;
static constexpr uint32_t REED_POLL_INTERVAL_MS = 50UL;
static constexpr uint32_t REED_DEBOUNCE_MS = 80UL;
static constexpr uint32_t RFID_POLL_INTERVAL_MS = 500UL;
// How long ONE presentation of one tag is allowed to occupy the reader.
//
// WHY A WINDOW IS NEEDED AT ALL
// A card held against the antenna is not one scan, it is a stream of successful
// reads. PICC_HaltA() parks the card in HALT so it stops answering, but the field
// resets when the tag is nudged, when it is lifted a millimetre and put back, and
// some tags re-enter READY on their own. At RFID_POLL_INTERVAL_MS that is two
// reads a second, each of which would queue its own event.
//
// WHY IT MATTERS MORE THAN A COSMETIC DUPLICATE
// The queue holds 24 slots and a full queue makes appendAlertEvent() REFUSE new
// events - the loudest condition is kept and the newest is lost, which for a
// food-safety device means the temperature_high that arrived while somebody was
// scanning a yoghurt pot never gets recorded. A scan must not be able to silence
// an alert, so the scan is the thing that gives way.
//
// WHY 5000 ms
// Longer than any deliberate presentation - a person lifts a tag away within a
// second or two - so a single touch produces exactly one event; and short enough
// that deliberately re-presenting the same tag is a new scan, not a repeat. It is
// not a "minimum time between scans" in the reporting sense: the key is the last
// UID read, so scanning two different tags back to back produces two events with
// no waiting at all.
static constexpr uint32_t RFID_SCAN_DEBOUNCE_MS = 5000UL;
static constexpr uint32_t LCD_PAGE_INTERVAL_MS = 2500UL;
static constexpr uint32_t WIFI_RETRY_INTERVAL_MS = 10000UL;
static constexpr uint32_t THINGSPEAK_INTERVAL_MS = 30000UL; // ThingSpeak minimum is 15 s.
static constexpr uint32_t ALERT_RETRY_INTERVAL_MS = 5000UL;
static constexpr uint8_t SENSOR_FAULT_CONFIRM_SAMPLES = 3;
static constexpr uint8_t SENSOR_FAULT_RECOVER_SAMPLES = 3;
static constexpr uint16_t HTTP_TIMEOUT_MS = 2000;

static constexpr uint8_t MAX_INVENTORY_ITEMS = 12;
static constexpr uint8_t ALERT_QUEUE_CAPACITY = 24;
static constexpr size_t SERIAL_LINE_CAPACITY = 256;
static constexpr size_t ALERT_MESSAGE_CAPACITY = 97;

// A card UID carried as hex text on the wire and in the event queue.
//
// parseUidHex() caps UID text at 20 characters, so 10 bytes is the longest UID
// this firmware will ever register or read and 20 hex digits plus a terminator is
// the exact requirement - no slack, and no truncation of a longer one. The queue
// slot and the in-memory event are both sized from this constant, so the field
// cannot quietly be made smaller than the thing it has to hold.
//
// The SPELLING is fixed by formatUid() and is the same one the registry uses:
// uppercase hex, no separators, no "0x" - see the comment there, which is why a
// scan of a registered tag matches inventory_item.uid byte for byte.
static constexpr size_t EVENT_UID_CAPACITY = 21;

// The longest UID this build can hold, in bytes. Mirrors the text cap above.
static constexpr uint8_t EVENT_UID_MAX_BYTES = EVENT_UID_CAPACITY / 2;

static const char QUEUE_PATH[] = "/fg_events.bin";
// Migration scratch file. Never read at runtime; if a migration is interrupted
// it is simply overwritten on the next boot.
static const char QUEUE_MIGRATE_PATH[] = "/fg_events.v1.tmp";
static const char INVENTORY_PATH[] = "/fg_inventory.txt";
static const char MQ_BASELINE_PATH[] = "/fg_mq_base.bin";

static constexpr uint16_t SENSOR_FAULT_BME280 = 1U << 0;
static constexpr uint16_t SENSOR_FAULT_BME280_HUMIDITY = 1U << 1;
static constexpr uint16_t SENSOR_FAULT_ADS1115 = 1U << 2;
static constexpr uint16_t SENSOR_FAULT_MQ135 = 1U << 3;
static constexpr uint16_t SENSOR_FAULT_DS3231 = 1U << 4;
static constexpr uint16_t SENSOR_FAULT_PCF8574_READ = 1U << 5;
static constexpr uint16_t SENSOR_FAULT_PCF8574_WRITE = 1U << 6;
static constexpr uint16_t SENSOR_FAULT_REED = 1U << 7;
// Number of distinct sensor conditions tracked, used only for the LCD summary
// line so it can report "6 of 6 reporting" without hard-coding a count that
// would drift whenever a bit is added.
static constexpr uint16_t SENSOR_FAULT_COUNT = 8;

static constexpr uint16_t STORAGE_FAULT_LITTLEFS = 1U << 8;
static constexpr uint16_t STORAGE_FAULT_INVENTORY = 1U << 9;
static constexpr uint16_t STORAGE_FAULT_ALERT_QUEUE = 1U << 10;
static constexpr uint16_t STORAGE_FAULT_CONFIGURATION = 1U << 11;

static constexpr uint16_t OPTIONAL_FAULT_RC522 = 1U << 12;
static constexpr uint16_t OPTIONAL_FAULT_LCD = 1U << 13;

// NOTE: bit 14 was STORAGE_FAULT_RTC_BATTERY, fed by a fabricated "BAT" decode
// of DS3231 status register 0x0F bit 3. The DS3231 has no battery-low bit -
// 0x0F bit 3 is EN32kHz - so there is nothing to report and the bit is
// deliberately unused rather than reused for something else. The CR2032 is a
// periodic operator maintenance item found by testing the cell, not something
// this firmware can observe. See the header note "THE DS3231 HAS NO BATTERY-LOW
// BIT" and readDs3231TemperatureC() for what the chip does expose.

// Configuration-only self-checks; these do not validate physical wiring.
static_assert(PIN_I2C_SDA != PIN_I2C_SCL, "I2C pins must differ");

static_assert(PIN_RC522_MISO != 0 && PIN_RC522_MOSI != 0 &&
              PIN_RC522_SCK != 0 && PIN_RC522_SS != 0,
              "Invalid SPI pin");
static_assert(PIN_RC522_MISO != PIN_RC522_MOSI &&
              PIN_RC522_MISO != PIN_RC522_SCK &&
              PIN_RC522_MISO != PIN_RC522_SS &&
              PIN_RC522_MOSI != PIN_RC522_SCK &&
              PIN_RC522_MOSI != PIN_RC522_SS &&
              PIN_RC522_SCK != PIN_RC522_SS,
              "SPI pins must differ");
static_assert(PIN_RC522_MISO != PIN_I2C_SDA && PIN_RC522_MISO != PIN_I2C_SCL &&
              PIN_RC522_MOSI != PIN_I2C_SDA && PIN_RC522_MOSI != PIN_I2C_SCL &&
              PIN_RC522_SCK != PIN_I2C_SDA && PIN_RC522_SCK != PIN_I2C_SCL &&
              PIN_RC522_SS != PIN_I2C_SDA && PIN_RC522_SS != PIN_I2C_SCL,
              "SPI and I2C pins conflict");
static_assert(PCF8574_ADDRESS != LCD_ADDRESS && PCF8574_ADDRESS != BME280_I2C_ADDRESS &&
              PCF8574_ADDRESS != DS3231_ADDRESS && PCF8574_ADDRESS != ADS1115_ADDRESS,
              "I2C address collision");
static_assert(LCD_ADDRESS != BME280_I2C_ADDRESS && LCD_ADDRESS != DS3231_ADDRESS &&
              LCD_ADDRESS != ADS1115_ADDRESS && BME280_I2C_ADDRESS != DS3231_ADDRESS &&
              BME280_I2C_ADDRESS != ADS1115_ADDRESS && DS3231_ADDRESS != ADS1115_ADDRESS,
              "I2C address collision");
static_assert(SENSOR_HYSTERESIS_C >= 1.0F && HUMIDITY_HYSTERESIS_PCT >= 5.0F,
              "Prototype hysteresis must cover documented sensor uncertainty");
static_assert(MQ_ADS_GAIN == GAIN_ONE, "MQ ADS1115 range must use GAIN_ONE");
static_assert(MQ_ADS_FULL_SCALE_MV == 4096.0F,
              "GAIN_ONE full scale must be 4096 mV, not 4096 V");
static_assert(MQ_LOAD_OHMS >= 1000UL,
              "MQ load resistor must be at least 1k to form a divider with the sensor");
static_assert(MQ_AIN0_SCALE > 0.0F && MQ_AIN0_SCALE <= 1.0F,
              "MQ AIN0 scale must be a positive fraction, not a multiplier");
static_assert(MQ_BASELINE_MAX_DRIFT_MV > 0.0F,
              "Baseline settling tolerance must be positive");
static_assert(MQ_AIN0_MIN_PLAUSIBLE_MV > 0.0F &&
              MQ_AIN0_MIN_PLAUSIBLE_MV < MQ_AIN0_HARD_LIMIT_MV,
              "MQ plausibility bounds are invalid");
static_assert(MQ_CLEAR_DELTA_MV < MQ_ABNORMAL_DELTA_MV,
              "MQ clear threshold must be below alarm threshold");
static_assert(sizeof(PCF_OUTPUT_PORT_MASK) * 8 == 8 && PCF_OUTPUT_PORT_MASK == 0xFF,
              "PCF8574 output shadow must be a full 8-bit port");
static_assert(PCF_PIN_REED <= 7 && PCF_PIN_LED_GREEN <= 7 &&
              PCF_PIN_LED_YELLOW <= 7 && PCF_PIN_LED_RED <= 7 &&
              PCF_PIN_BUZZER <= 7 && PCF_PIN_RC522_RST <= 7,
              "PCF8574 pin index out of range");
static_assert((PCF_CONTROL_PIN_MASK & (1U << PCF_PIN_REED)) == 0,
              "Reed pin cannot be an output");
static_assert((PCF_REED_LATCH_BIT & (1U << PCF_PIN_REED)) != 0,
              "PCF8574 P0 latch bit must be 1 so the reed pin is a weak source");
static_assert(REED_CLOSED_LEVEL == LOW,
              "P0 reed-to-GND wiring requires closed level LOW");
static_assert(ALERT_QUEUE_CAPACITY > 0 && MAX_INVENTORY_ITEMS > 0,
              "Bounded storage must be non-zero");
static_assert(MQ_BASELINE_SAMPLE_COUNT > 0 && MQ_NORMAL_SAMPLE_COUNT > 0,
              "MQ sample counts must be non-zero");

// ============================================================================
// Types and fixed-size state
// ============================================================================

enum class FreshnessStatus : uint8_t {
  Fresh = 0,
  UseSoon = 1,
  CheckFood = 2,
  SensorFault = 3
};

enum class MqState : uint8_t {
  WarmingUp,
  CapturingBaseline,
  Ready,
  Faulted
};

enum class MqReadResult : uint8_t {
  Ok,
  AdcUnavailable,
  Implausible
};

enum class BuzzerState : uint8_t {
  Idle,
  On,
  OffGap
};

struct SensorFaults {
  bool bme280;
  bool bme280Humidity;
  bool ads1115;
  bool mq135;
  bool ds3231;
  bool pcf8574Read;
  bool pcf8574Write;
  bool reed;
  bool littlefs;
  bool inventory;
  bool alertQueue;
  bool configuration;
  bool rc522; // Optional identity function.
  bool lcd;    // Optional display function.
};
// There is deliberately no `rtcBattery` member. It existed only to carry the
// fabricated 0x0F bit-3 "BAT" decode described above; the DS3231 exposes no
// backup-cell state, so a struct field for it could only ever carry a fiction.

struct FaultDebounceState {
  bool active;
  uint8_t failureCount;
  uint8_t recoveryCount;
  uint32_t lastTransitionMs;
};

struct ConfirmedLatch {
  bool active;
  uint8_t consecutive;
  uint32_t lastRaisedMs;
};

struct FoodItem {
  uint8_t uid[10];
  uint8_t uidLength;
  char name[24];
  char category[16];
  char quantity[12];
  char location[24];
  uint32_t storeDateEpoch;
  uint32_t expiryEpoch; // 0 means use durationLimitDays.
  uint16_t durationLimitDays;
  // Added last, and it has to stay last. The LittleFS record is positional
  // text, so a field inserted anywhere but the end would shift every field
  // after it and silently re-read an old file at the wrong offsets. The record
  // version (see INVENTORY_VERSION) is what makes that safe to detect; keeping
  // the field at the end is what keeps the earlier offsets unchanged.
  //
  // 0 means "manufacture date unknown". Nothing derives a verdict from it: it
  // is dashboard-supplied metadata, reported in items[] and stored, and the
  // freshness maths reads only storeDateEpoch, expiryEpoch and
  // durationLimitDays.
  uint32_t manufactureEpoch;
};

struct ItemRuntime {
  ConfirmedLatch useSoon;
  ConfirmedLatch checkFood;
};

struct AlertEvent {
  uint32_t eventId;
  uint32_t timestampEpoch;
  bool timeValid;
  char type[20];
  // The tag this event is about, hex, as the reader read it. Empty for every
  // event that is not about a tag, which is the honest encoding: the service
  // stores an absent uid as NULL and never as "" or a sentinel, and it is
  // optional in the schema precisely so the eleven pre-existing event types are
  // unaffected by its existence.
  char uid[EVENT_UID_CAPACITY];
  char message[ALERT_MESSAGE_CAPACITY];
};

// The queue file header, fixed at 16 bytes (see the static_assert below).
//
// `nextEventId` is the highest id this FILE has spoken for - the id the last
// append issued, or the seed a freshly created file reserves - and which of the
// two it is depends on who wrote it. That ambiguity is resolved in exactly one
// place, initializeAlertQueue(), rather than at each read, because reading it
// the wrong way is a duplicate-id generator: an id already sitting in a slot
// handed out a second time collides on the backend's (device_id,
// boot_generation, event_id) key and one of the two events is dropped with a
// 2xx. `reserved` stays 0 and is not a semantic flag, and the layout does NOT
// change with the event_id seeding fix - so QUEUE_VERSION is deliberately not
// bumped, and an existing file keeps its pending events instead of being
// refused behind a CLEARQ it did not ask for.
struct QueueHeaderDisk {
  uint32_t magic;
  uint16_t version;
  uint16_t capacity;
  uint32_t nextEventId;
  uint32_t reserved;
};

struct QueueSlotDisk {
  uint32_t magic;
  uint8_t syncState; // 0 = empty, 1 = pending synchronization.
  uint8_t timeValid;
  uint32_t eventId;
  uint32_t timestampEpoch;
  char type[20];
  char message[ALERT_MESSAGE_CAPACITY];
  // The tag this event is about, hex, as the reader read it. Placed last, just
  // before `crc`, so it is the only thing this build added to the on-disk slot.
  char uid[EVENT_UID_CAPACITY];
  uint32_t crc;
};

// The version 1 queue slot: the layout above without the per-event uid. Kept so
// the file an older build wrote can be READ rather than discarded, which is the
// difference between a queue that comes back and a queue that is dead forever.
//
// Never written by this build, and deliberately NOT read by raw byte offset -
// migrateAlertQueueV1() copies field by field, because a struct with padding is
// not a description of a byte range and pretending otherwise is how a migration
// ends up reinterpreting memory.
struct QueueSlotDiskV1 {
  uint32_t magic;
  uint8_t syncState;
  uint8_t timeValid;
  uint32_t eventId;
  uint32_t timestampEpoch;
  char type[20];
  char message[ALERT_MESSAGE_CAPACITY];
  uint32_t crc;
};

// The migration identifies an old file by its SIZE, which only works while the v2
// slot is strictly the larger one. If a future field is ever removed instead, this
// fires rather than letting a v1 file be mistaken for a v2 one.
static_assert(sizeof(QueueSlotDisk) > sizeof(QueueSlotDiskV1),
              "the current slot must be the larger one, or the v1 file size no"
              " longer identifies a v1 file");
// `crc` must stay last: crc32() is taken over offsetof(QueueSlotDisk, crc), so
// anything after it would be written but never checked.
static_assert(offsetof(QueueSlotDisk, crc) + sizeof(uint32_t) == sizeof(QueueSlotDisk),
              "QueueSlotDisk::crc must be the final field");
// A migrated event must not lose any of its text, or a v1 message would arrive
// truncated and mean something else.
static_assert(sizeof(QueueSlotDiskV1::message) <= sizeof(QueueSlotDisk::message),
              "message[] must not shrink between queue versions");
static_assert(sizeof(QueueSlotDiskV1::type) <= sizeof(QueueSlotDisk::type),
              "type[] must not shrink between queue versions");
// The header is not versioned with the slot and must not grow: the migration
// copies it through unchanged, so a field added here would be read as part of
// the first v1 slot.
static_assert(sizeof(QueueHeaderDisk) == 16, "QueueHeaderDisk must stay 16 bytes");

struct MqBaselineDisk {
  uint32_t magic;
  uint16_t version;
  uint16_t dividerTopOhms;
  uint16_t dividerBottomOhms;
  uint16_t fullScaleMv;
  uint16_t sampleCount;
  float baselineMv;
  uint32_t crc;
};

static constexpr uint32_t QUEUE_MAGIC = 0x46513031UL; // "FG01"
// Version 2 is version 1 plus a per-event `uid`, which grew the slot and with it
// the file. The version number alone cannot save an upgrade: initializeAlertQueue()
// also compares the file size, so a v1 file is a size mismatch and would be
// refused outright - leaving queueReady false, which makes appendAlertEvent()
// fail for EVERY condition, so a warm fridge and a dead sensor would both go
// unrecorded. migrateAlertQueueV1() therefore widens the old file before that
// check runs, keeping every pending event with an empty uid, which is exactly
// what "this event is not about a tag" means on the wire.
static constexpr uint16_t QUEUE_VERSION = 2;
static constexpr uint16_t QUEUE_VERSION_1 = 1;
static constexpr uint32_t QUEUE_SLOT_MAGIC = 0x46514531UL; // "FQE1"
static constexpr uint32_t MQ_BASELINE_MAGIC = 0x4651424DUL; // "FQBM"
static constexpr uint16_t MQ_BASELINE_VERSION = 1;

// On-disk layout of /fg_inventory.txt, carried in the file header as a tag.
//
// Version 1 wrote eight fields per record; version 2 appends manufacture_epoch
// as a ninth. The two are not interchangeable and the difference is invisible
// from the data: a v1 record read by v2 rules would take the last field of the
// NEXT line as a manufacture epoch, which parses as a number often enough to go
// unnoticed. So the tag is compared before a single record is read, and a
// mismatch refuses the whole file with the reason logged. It is left on flash
// untouched rather than rewritten or deleted - the operator may still want the
// records, and this firmware is not the thing that decides they are unreadable.
//
// Bump this whenever a record gains, loses or reorders a field.
static constexpr uint16_t INVENTORY_VERSION = 2;
static const char INVENTORY_MAGIC[] = "FG2";

// ============================================================================
// PCF8574 channel polarity - MUST stay below the struct definitions
// ============================================================================
// Placement is load-bearing, not cosmetic.
//
// The Arduino build rewrites a .ino into a .cpp and inserts a block of
// auto-generated prototypes near the top of the file. That insertion point
// anchors on the first function-like construct the tagger finds, so any helper
// function defined ABOVE the struct definitions pulls the whole prototype block
// up with it. A prototype such as
//
//     static bool updateFaultDebounce(FaultDebounceState*, bool, uint32_t);
//
// would then be emitted before `struct FaultDebounceState` exists, and the
// build fails with "'FaultDebounceState' was not declared in this scope" - an
// error that points at a perfectly correct line and has nothing to do with it.
//
// Keeping these helpers below the structs keeps the generated prototypes below
// them too. The robust alternative is to move every type into its own .h, which
// the includes make visible ahead of any prototype; that is a larger change
// than this sketch currently needs.

/**
 * Per-channel drive polarity. There is deliberately no single global flag,
 * because the three output styles wired to P1-P5 do NOT share a convention:
 *
 *   P1-P3  LEDs.  Wired rail -> LED -> resistor -> pin, so the pin SINKS and
 *          the internal pull-down MOSFET closes the path. The LED therefore
 *          lights when the pin is LOW: active-low. This keeps the expander's
 *          weak source off the current path entirely - ~8 mA per lit channel
 *          against the pin's 25 mA sink rating.
 *   P4     Buzzer.  Wired to a TO-220 IRFZ44N gate through a 100k pull-down,
 *          so the pin SOURCES and the load conducts when the pin is HIGH:
 *          active-high.
 *   P5     RC522 reset - active-low, same convention as the LEDs. Driven
 *          through pcfSetOutputActive() now rather than pcfSetRawBit(), so the
 *          idle pattern below can hold it de-asserted in a single write.
 *
 * In short: P4 is the only active-high channel. Everything else is active-low,
 * so the table is a single equality rather than an exclusion list - an
 * exclusion list is what got this wrong once already, by omitting P5.
 */
static constexpr bool PCF_PIN_ACTIVE_HIGH(uint8_t pin) {
  return pin == PCF_PIN_BUZZER;
}

static constexpr uint8_t PCF_INACTIVE_BIT(uint8_t pin) {
  return PCF_PIN_ACTIVE_HIGH(pin) ? 0x00 : static_cast<uint8_t>(1U << pin);
}

/**
 * The output pattern that leaves every switched load OFF.
 *
 * Derived from the polarity table rather than written as a literal, so the two
 * cannot drift apart. Writing 0x00 here would be wrong for the LED channels:
 * with them wired to sink, all-zeros lights all three.
 */
static constexpr uint8_t PCF_OUTPUTS_INACTIVE =
    static_cast<uint8_t>(PCF_INACTIVE_BIT(PCF_PIN_LED_GREEN) |
                         PCF_INACTIVE_BIT(PCF_PIN_LED_YELLOW) |
                         PCF_INACTIVE_BIT(PCF_PIN_LED_RED) |
                         PCF_INACTIVE_BIT(PCF_PIN_BUZZER) |
                         PCF_INACTIVE_BIT(PCF_PIN_RC522_RST));

static_assert(PCF_PIN_ACTIVE_HIGH(PCF_PIN_BUZZER),
              "buzzer is driven from a MOSFET gate, so it must stay active-high");
static_assert(!PCF_PIN_ACTIVE_HIGH(PCF_PIN_LED_GREEN) &&
              !PCF_PIN_ACTIVE_HIGH(PCF_PIN_LED_YELLOW) &&
              !PCF_PIN_ACTIVE_HIGH(PCF_PIN_LED_RED),
              "LEDs are wired rail -> LED -> pin, so they must stay active-low");
static_assert(PCF_OUTPUTS_INACTIVE ==
                  ((1U << PCF_PIN_LED_GREEN) | (1U << PCF_PIN_LED_YELLOW) |
                   (1U << PCF_PIN_LED_RED) | (1U << PCF_PIN_RC522_RST)),
              "idle pattern must hold the LED sinks and RC522 reset off while the buzzer gate stays low");

// Adafruit_BME280 has no TwoWire constructor: the bus is supplied to begin(),
// which defaults to &Wire. Its begin() also validates chip id 0x60, so a
// mislabelled BMP280 is rejected here rather than misread as a BME280.
static Adafruit_BME280 bme280;
static Adafruit_ADS1115 ads1115;
static RTC_DS3231 rtc;
static LiquidCrystal_I2C lcd(LCD_ADDRESS, LCD_COLUMNS, LCD_ROWS);
static MFRC522 rc522(PIN_RC522_SS, MFRC522::UNUSED_PIN);

static SensorFaults faults = {};
static FoodItem inventory[MAX_INVENTORY_ITEMS];
static ItemRuntime itemRuntime[MAX_INVENTORY_ITEMS];
static uint8_t inventoryCount = 0;
static int8_t latestScannedItem = -1;

static float temperatureC = NAN;
static float pressureHpa = NAN;
static float humidityPct = NAN;
static float mqInputMv = NAN;
static float mqDeltaMv = NAN;
static int16_t mqAdcCode = 0;
static MqState mqState = MqState::WarmingUp;
static bool mqBaselineReady = false;
static float mqBaselineMv = NAN;
static float mqBaselineSum = 0.0F;
static uint8_t mqBaselineCount = 0;
// Baseline capture has two phases: wait for the sensor to stop drifting, then
// average a run of settled passes. Without the first phase the stored baseline
// is a value the sensor merely passed through on the way up.
static bool mqSettling = false;
static uint16_t mqSettlePasses = 0;
static float mqSettlingPreviousMv = 0.0F;
static uint32_t lastAdsInitAttemptMs = 0;

static bool bmeDataReady = false;
static bool humidityReady = false;
static bool ds3231TimeReady = false;
static bool pcfReadReady = false;
static bool pcfInitialized = false;

static uint8_t pcfOutputShadow = 0x00;
static bool doorOpen = false;
static bool reedCandidate = false;
static bool reedStableInitialized = false;
static uint32_t reedCandidateSinceMs = 0;
static uint32_t doorOpenSinceMs = 0;
static bool doorAlertSentForOpenCycle = false;

static bool rtcReady = false;
static bool rtcClockTrusted = false;
static uint32_t rtcEpoch = 0;

static bool adsReady = false;
static bool bmeReady = false;
static bool lcdReady = false;
static bool lcdBacklightOn = true;
static bool rc522Ready = false;

static bool storageReady = false;
static bool queueReady = false;
static bool inventoryStoreReady = false;
// The counter behind every event_id. 0 means "no counter has been established
// yet" and deliberately NOT 1. The initialiser here used to be 1, so any path
// that reached appendAlertEvent() without first loading a seeded header would
// hand out ids from the bottom of the number line - which is exactly the band
// every earlier life of this device has already published. A reflash recreated
// the queue file, the counter restarted at 1, and the backend's dedupe silently
// swallowed ~12,400 follow-on events while every POST returned 2xx and the
// queue drain looked perfectly healthy. Every path that needs an id now goes
// through seedQueuedEventId() or a validated header; neither can produce 1.
static uint32_t nextQueuedEventId = 0;
// Within-boot high-water mark: the greatest event_id this boot has reserved or
// issued. The backend scopes its dedupe by boot_generation, which it increments
// when uptime DECREASES - so a reboot that restarts the counter is covered
// upstream. What upstream cannot see is a counter restarting while uptime
// keeps counting: CLEARQ at the console, or a queue file recreated mid-run by
// flash recovery. (A header rejected after a brownout does not restart the
// counter at all - it stops the queue until CLEARQ, which reseeds through this
// clamp either way.) This variable is the layer for exactly that case: every
// reseed is clamped above it, so no id handed out during this boot can ever
// repeat, whatever the clock does in between (a server time correction can
// step the reported epoch BACKWARDS by hours on this hardware - see
// rememberServerTime()).
static uint32_t lastIssuedQueuedEventId = 0;
static uint8_t queuedEventCount = 0;

static bool wifiConnected = false;
static bool wifiConfigured = false;
static bool wifiCredentialsWarned = false;
static uint32_t lastWifiBeginMs = 0;

static bool thingspeakConfigured = false;
static bool thingspeakConfigWarned = false;
static bool iftttConfigured = false;
static bool iftttConfigWarned = false;
static BearSSL::WiFiClientSecure transportTls;

// Option B service sync. `backendSeq` is monotonic within one boot; the
// service treats a decreasing `uptime` as the reboot signal and restarts its
// own sequence tracking, so resetting both together on boot is correct.
static bool backendConfigured = false;
static bool mqttConfigured = false;
static bool backendConfigWarned = false;
static uint32_t backendSeq = 0;

// MQTT transport state. Declared with the other transport state rather than in
// the MQTT section further down, because the configuration check configures the
// client long before that section is reached.
static void onMqttMessage(char* topic, uint8_t* payload, unsigned int length);
// This PubSubClient version fixes the message callback at construction - there
// is no setCallback() - and only offers callback constructors that also take the
// server. The host, port and callback therefore all go in here, which replaces
// the setServer() call the configuration code used to make. Passing the callback
// is what makes the retained threshold profile arrive on connect instead of
// having to poll a topic over a port this network filters.
//
// One callback therefore serves every topic this device subscribes to, so it
// dispatches on `topic` internally. Registering a second handler is not an
// option in this library version, and treating the command topic as if it were
// the config topic would apply a threshold profile to an item registration.
static WiFiClient mqttNetworkClient;
static PubSubClient mqttClient(MQTT_BROKER_HOST, MQTT_BROKER_PORT,
                               onMqttMessage, mqttNetworkClient);
static bool mqttConnected = false;
static uint32_t lastMqttAttemptMs = 0;
static uint32_t mqttPublishFailures = 0;
static uint8_t mqttLoopFailures = 0;
static uint32_t mqttConnects = 0;
static char mqttSnapshotTopic[64];
static char mqttStatusTopic[64];
static char mqttConfigTopic[64];
static char mqttCommandTopic[64];

// Set by anything worth surfacing immediately. Deliberately not persisted: a
// pending push is worthless after a reboot, because the boot snapshot already
// reports the current state. Defined here rather than beside the interval
// constants because it reads backendConfigured and lastBackendAttemptMs, which
// are declared further down - a definition above them cannot compile.
static bool backendPostRequested = false;

static void requestBackendPost() { backendPostRequested = true; }

static uint32_t lastBackendAttemptMs = 0;

// The sensor values the backend last ACCEPTED, not the last ones read.
//
// Anchoring to what was published is what makes one change one event. Compared
// against the last READ values, a change seen during a post cooldown would keep
// re-triggering on every later poll, because the "previous" value it is measured
// against had itself moved on: the device would never stop asking, and the
// cooldown would be the only thing holding the cadence down.
//
// NAN means "no baseline yet" and is left alone by the comparison, which is
// exactly the behaviour wanted before the first snapshot of a boot: there is
// nothing to have changed relative to, and the heartbeat is about to publish
// the boot state anyway. A channel that is unavailable at the moment of a
// publish stays NAN here, so the reading that finally arrives is not mistaken
// for a change away from a value that was never reported.
struct PublishedReadings {
  float temperatureC;
  float humidityPct;
  float pressureHpa;
  float mqInputMv;
  float mqDeltaMv;
};
static PublishedReadings lastPublishedReadings = {NAN, NAN, NAN, NAN, NAN};

// Bumped whenever the in-memory registry changes, so the service can tell a
// genuine list change from an unchanged re-send.
static uint32_t inventoryRevision = 1;

// The highest cmd_seq this device has actually APPLIED, persisted in the
// inventory file's header alongside the item count rather than in a second
// storage system, so it shares the registry's already-proven save/load/CRC
// discipline and cannot drift out of step with it.
//
// This only became necessary once the session went persistent. A clean session
// could not redeliver anything, so a duplicate could not arrive. A persistent
// session can - the broker replays an unacked QoS 1 command, and a session that
// outlives a power cycle replays everything still queued - and item.clear and
// item.register are not idempotent for free. Zero means "nothing applied yet",
// which accepts every cmd_seq a backend that counts from 1 can send, and is
// also what a registry file written before this field existed loads as.
static uint32_t lastAppliedCmdSeq = 0;

static uint32_t bootMs = 0;
static uint32_t lastSensorPollMs = 0;
static uint32_t lastMqReadMs = 0;

// Heartbeat or an explicit request, whichever comes first, subject to a minimum
// gap so a flapping reed or a burst of alerts cannot become a request flood.
static bool backendPostDue(uint32_t nowMs) {
  if (!backendConfigured) return false;
  const uint32_t sinceLast = static_cast<uint32_t>(nowMs - lastBackendAttemptMs);
  if (sinceLast < BACKEND_MIN_POST_GAP_MS) return false;
  return backendPostRequested || sinceLast >= BACKEND_SNAPSHOT_INTERVAL_MS;
}
static uint32_t lastRtcPollMs = 0;
static uint32_t lastReedPollMs = 0;
static uint32_t lastRfidPollMs = 0;
static uint32_t lastLcdPageMs = 0;
static uint32_t lastTransportAttemptMs = 0;
static uint32_t lastThingSpeakAttemptMs = 0;

// Queue acknowledgement state. The RULE lives with the code that reads it,
// above sendBackendSnapshot(); this is only the storage.
//
// Both sets are RAM only, on purpose. They record what THIS boot has been TOLD,
// not anything about the event itself, and a reboot that loses them costs only a
// re-send of a slot that is still on flash - the service de-duplicates it, or
// files it under the new boot generation, and neither loses anything. The
// dangerous direction would be persisting them: a device that boots already
// believing an obligation was settled never tries again, and the resulting gap
// is indistinguishable from an alert that never happened.
//
// Ids are never issued twice inside one boot (seedQueuedEventId()'s high-water
// clamp), so a stale entry left by a popped or cleared slot can never match a
// later event - it is dead bytes, not a false acknowledgement.
static uint32_t inFlightEventIds[BACKEND_MAX_EVENTS];   // ids in the payload being sent
static uint8_t inFlightEventCount = 0;
static uint32_t storageAckedEventIds[BACKEND_MAX_EVENTS]; // ids the service confirmed a row for
static uint8_t storageAckedEventCount = 0;
// The one event_id the notification webhook has been delivered for. A single
// value is enough even though there are 24 slots: the notification leg only ever
// offers the HEAD of the queue, so at most one delivery can be outstanding and
// unconfirmed at any moment.
static uint32_t webhookDeliveredEventId = 0;

static ConfirmedLatch temperatureHighLatch = {};
static ConfirmedLatch temperatureLowLatch = {};
static ConfirmedLatch humidityHighLatch = {};
static ConfirmedLatch humidityLowLatch = {};
static ConfirmedLatch gasHighLatch = {};

static FaultDebounceState bme280Debounce = {};
static FaultDebounceState bme280HumidityDebounce = {};
static FaultDebounceState ads1115Debounce = {};
static FaultDebounceState mq135Debounce = {};
static FaultDebounceState ds3231Debounce = {};
static FaultDebounceState pcfReadDebounce = {};
static FaultDebounceState pcfWriteDebounce = {};

static FreshnessStatus zoneStatus = FreshnessStatus::SensorFault;
static uint16_t announcedSensorFaultMask = 0;
static uint16_t announcedStorageFaultMask = 0;
static uint32_t lastSensorFaultAlertMs = 0;
static uint32_t lastStorageFaultAlertMs = 0;

static uint8_t buzzerRemainingBeeps = 0;
static BuzzerState buzzerState = BuzzerState::Idle;
static uint32_t buzzerNextTransitionMs = 0;
static uint16_t buzzerOnMs = 200;
static uint16_t buzzerOffMs = 150;

static uint32_t redBlinkNextMs = 0;
static bool redBlinkOn = false;
static uint8_t lcdPage = 0;

// Tag-presentation debounce. The key is the LAST tag read, not a counter: a card
// held against the antenna is one presentation, while two different tags brought
// up in succession are two presentations and neither waits for the other.
//
// lastScanMs is left at its previous value while a card is being suppressed, so
// the window always runs from the first presentation of that tag rather than
// being extended by every poll - otherwise a tag that never leaves the field
// would never be re-reportable at all. The flag is only so the console gets one
// line per suppressed presentation instead of one per 500 ms poll.
static uint8_t rfidLastScanUid[EVENT_UID_MAX_BYTES] = {0};
static uint8_t rfidLastScanUidLength = 0;
static uint32_t rfidLastScanMs = 0;
static bool rfidDebounceReported = false;

static char lcdAlertText[ALERT_MESSAGE_CAPACITY] = "";
static uint32_t lcdAlertUntilMs = 0;

static char serialLine[SERIAL_LINE_CAPACITY];
static uint16_t serialLineLength = 0;
static bool serialLineOverflow = false;
static bool serialOverflowWarned = false;

// ============================================================================
// Small fixed-memory helpers
// ============================================================================

static void copyBounded(char* destination, size_t capacity, const char* source) {
  if (capacity == 0) return;
  size_t index = 0;
  while (source && source[index] != '\0' && index + 1 < capacity) {
    destination[index] = source[index];
    ++index;
  }
  destination[index] = '\0';
}

static void sanitizeField(char* destination, size_t capacity, const char* source) {
  if (capacity == 0) return;
  size_t index = 0;
  while (source && source[index] != '\0' && index + 1 < capacity) {
    char value = source[index];
    if (value < 32 || value > 126 || value == '|' || value == '"' || value == '\\') {
      value = ' ';
    }
    destination[index++] = value;
  }
  destination[index] = '\0';
}

static float smoothValue(float previous, float current, float newWeight) {
  return isnan(previous) ? current : ((1.0F - newWeight) * previous) + (newWeight * current);
}

static bool updateFaultDebounce(FaultDebounceState* state, bool sampleFailed, uint32_t nowMs) {
  if (!state) return false;
  if (sampleFailed) {
    state->recoveryCount = 0;
    if (state->failureCount < 255) ++state->failureCount;
    if (!state->active && state->failureCount >= SENSOR_FAULT_CONFIRM_SAMPLES) {
      state->active = true;
      state->lastTransitionMs = nowMs;
    }
  } else {
    state->failureCount = 0;
    if (state->recoveryCount < 255) ++state->recoveryCount;
    if (state->active && state->recoveryCount >= SENSOR_FAULT_RECOVER_SAMPLES) {
      state->active = false;
      state->lastTransitionMs = nowMs;
    }
  }
  return state->active;
}

static void clearFaultDebounce(FaultDebounceState* state) {
  if (!state) return;
  state->active = false;
  state->failureCount = 0;
  state->recoveryCount = 0;
  state->lastTransitionMs = 0;
}

static void forceFaultDebounce(FaultDebounceState* state, uint32_t nowMs) {
  if (!state) return;
  state->active = true;
  state->failureCount = SENSOR_FAULT_CONFIRM_SAMPLES;
  state->recoveryCount = 0;
  state->lastTransitionMs = nowMs;
}

static bool parseUint32(const char* text, uint32_t minimum, uint32_t maximum,
                        uint32_t* result) {
  if (!text || !*text || !result) return false;
  char* end = nullptr;
  unsigned long value = strtoul(text, &end, 10);
  if (end == text || *end != '\0') return false;
  if (value < minimum || value > maximum) return false;
  *result = static_cast<uint32_t>(value);
  return true;
}

static uint8_t splitFields(char* text, char delimiter, char** fields, uint8_t maximumFields) {
  if (!text || !fields || maximumFields == 0) return 0;
  uint8_t count = 1;
  fields[0] = text;
  while (*text != '\0') {
    if (*text == delimiter) {
      *text = '\0';
      if (count >= maximumFields) return static_cast<uint8_t>(maximumFields + 1);
      fields[count++] = text + 1;
    }
    ++text;
  }
  return count;
}

static bool asciiCaseEqual(const char* left, const char* right) {
  while (*left && *right) {
    char a = *left++;
    char b = *right++;
    if (a >= 'a' && a <= 'z') a = static_cast<char>(a - ('a' - 'A'));
    if (b >= 'a' && b <= 'z') b = static_cast<char>(b - ('a' - 'A'));
    if (a != b) return false;
  }
  return *left == '\0' && *right == '\0';
}

static void trimLine(char* text) {
  if (!text) return;
  size_t length = strlen(text);
  while (length > 0) {
    char value = text[length - 1];
    if (value == '\r' || value == '\n' || value == ' ' || value == '\t') {
      text[--length] = '\0';
    } else {
      break;
    }
  }
  size_t start = 0;
  while (text[start] == ' ' || text[start] == '\t') ++start;
  if (start > 0) memmove(text, text + start, length - start + 1);
}

static bool configurationSelfCheck() {
  if (MQ_LOAD_OHMS == 0 || MQ_AIN0_SCALE <= 0.0F) {
    return false;
  }
  if (PCF8574_ADDRESS == LCD_ADDRESS || PCF8574_ADDRESS == BME280_I2C_ADDRESS ||
      PCF8574_ADDRESS == DS3231_ADDRESS || PCF8574_ADDRESS == ADS1115_ADDRESS) {
    return false;
  }
  if (PCF_OUTPUT_PORT_MASK != 0xFF ||
      (PCF_REED_LATCH_BIT & (1U << PCF_PIN_REED)) == 0 ||
      (PCF_REED_LATCH_BIT & PCF_CONTROL_PIN_MASK) != 0) {
    return false;
  }
  return PIN_I2C_SDA != PIN_I2C_SCL;
}

static const char* freshnessStatusText(FreshnessStatus status) {
  switch (status) {
    case FreshnessStatus::Fresh: return "Fresh/Normal";
    case FreshnessStatus::UseSoon: return "Use Soon";
    case FreshnessStatus::CheckFood: return "Check Food";
    case FreshnessStatus::SensorFault: return "Sensor Fault/Data Unavailable";
  }
  return "Sensor Fault/Data Unavailable";
}

static FreshnessStatus worstStatus(FreshnessStatus left, FreshnessStatus right) {
  return static_cast<uint8_t>(left) >= static_cast<uint8_t>(right) ? left : right;
}

// ============================================================================
// I2C probing and direct PCF8574 register access
// ============================================================================

static bool i2cDevicePresent(uint8_t address) {
  Wire.beginTransmission(address);
  return Wire.endTransmission(true) == 0;
}

static bool i2cReadRegister8(uint8_t address, uint8_t reg, uint8_t* value) {
  if (!value) return false;
  Wire.beginTransmission(address);
  Wire.write(reg);
  if (Wire.endTransmission(false) != 0) return false;  // repeated START, no STOP
  // The 3-argument form. The 2-argument requestFrom(address, size) does NOT
  // send a STOP condition, which leaves the bus mid-transaction and can corrupt
  // the following operation - on the PCF8574 that showed up as the device
  // echoing the register pointer back instead of its contents.
  uint8_t received = Wire.requestFrom(address, static_cast<uint8_t>(1), static_cast<uint8_t>(1));
  if (received != 1) return false;
  *value = Wire.read();
  return true;
}

// I2C STOP-to-START recovery time, microseconds.
//
// The PCF8574 datasheet requires tSU;STO >= 4.0 us (typ 4.7 us) between the
// STOP that ends a write and the next START. Without it, a write immediately
// followed by a readback can return a stale byte, and the caller concludes the
// chip is faulty. 20 us is the value used here: comfortably over the limit at
// 100 kHz, and irrelevant against a 5 s sensor cadence. A shared helper, so it
// also protects the ADS1115 and BME280 write-then-read paths.
static constexpr uint8_t I2C_WRITE_RECOVERY_US = 20;

static bool i2cWriteRegister8(uint8_t address, uint8_t reg, uint8_t value) {
  Wire.beginTransmission(address);
  Wire.write(reg);
  Wire.write(value);
  bool ok = Wire.endTransmission(true) == 0;
  if (ok) delayMicroseconds(I2C_WRITE_RECOVERY_US);
  return ok;
}

// A floating or shorted bus has to be told apart from a misbehaving device,
// because a phantom ACK looks exactly like a device that answers at an address.
// With no pull-up, SDA idles LOW, the master's address register latches whatever
// byte was last on the wire, and reads return that stale byte - which is why a
// dead bus produces a "device" whose every register reads back its own index.
// Sampling the idle level separates these cases before any scan is trusted.
static bool i2cIdleLineHigh(uint8_t pin) {
  pinMode(pin, INPUT);
  delayMicroseconds(50);
  return digitalRead(pin) == HIGH;
}

static void i2cBusRecover() {
  // SDA and SCL are open-drain: this code may only ever PULL A LINE LOW, and
  // releasing it is done by handing it back to the pull-up. Driving either line
  // HIGH as a push-pull output fights the pull-up and any slave that is holding
  // the line, which is what jammed the bus and made every scan come back empty.
  // The latch is also set BEFORE switching to OUTPUT, because pinMode(OUTPUT)
  // alone leaves the previous latch value on the pin for a few cycles.
  pinMode(PIN_I2C_SDA, INPUT);
  pinMode(PIN_I2C_SCL, INPUT);
  delayMicroseconds(50);
  for (uint8_t i = 0; i < 9; ++i) {
    digitalWrite(PIN_I2C_SCL, LOW);
    pinMode(PIN_I2C_SCL, OUTPUT);
    delayMicroseconds(5);
    pinMode(PIN_I2C_SCL, INPUT);
    delayMicroseconds(5);
  }
  // STOP condition: hold SDA low, let SCL sit high on its pull-up, then release
  // SDA so the rising edge is seen as a STOP.
  digitalWrite(PIN_I2C_SDA, LOW);
  pinMode(PIN_I2C_SDA, OUTPUT);
  delayMicroseconds(5);
  pinMode(PIN_I2C_SDA, INPUT);
  delayMicroseconds(50);
}

static void logI2cBusHealth() {
  const bool sdaHigh = i2cIdleLineHigh(PIN_I2C_SDA);
  const bool sclHigh = i2cIdleLineHigh(PIN_I2C_SCL);
  Serial.printf("[I2C] Idle level: SDA=%s SCL=%s\n",
                sdaHigh ? "HIGH" : "LOW", sclHigh ? "HIGH" : "LOW");
  if (!sdaHigh || !sclHigh) {
    Serial.println(F("  A healthy idle bus sits HIGH on both lines. LOW means either"
                     " the pull-up"));
    Serial.println(F("  resistors are missing/failed, or the line is shorted to GND."
                     " Add 4.7k"));
    Serial.println(F("  from SDA to 3V3 and 4.7k from SCL to 3V3, nearest the ESP."
                     " Until this"));
    Serial.println(F("  reads HIGH, every address below is untrustworthy - a floating"
                     " bus fakes ACKs."));
  }
  i2cBusRecover();
  const bool sdaFree = i2cIdleLineHigh(PIN_I2C_SDA);
  const bool sclFree = i2cIdleLineHigh(PIN_I2C_SCL);
  if (sdaFree && sclFree) {
    Serial.println(F("[I2C] Bus released after 9-clock recovery"));
  } else {
    Serial.println(F("[I2C] Bus still held after recovery: a slave is driving a line"
                     " low. Disconnect"));
    Serial.println(F("  devices one at a time to find it."));
  }
  // Driving the pins by hand desynchronises the I2C peripheral from the state
  // Wire.begin() left it in, and a scan run against that stale state reports
  // nothing at all. Re-initialise before the peripheral is used again.
  Wire.begin(PIN_I2C_SDA, PIN_I2C_SCL);
  Wire.setClock(100000);
}

// A one-shot scan cannot tell "wrong address" from "not connected", because a
// device that is not answering is invisible either way. Watching the bus while
// hardware is plugged and unplugged settles it: an address that appears and
// disappears with the part is a real device at a discoverable address, and a
// part whose address never changes is not reaching the bus at all.
static const char* i2cAddressLabel(uint8_t address) {
  switch (address) {
    case BME280_I2C_ADDRESS: return "expected BME280";
    case DS3231_ADDRESS:     return "expected DS3231";
    case ADS1115_ADDRESS:    return "expected ADS1115";
    case PCF8574_ADDRESS:    return "expected separate expander";
    case LCD_ADDRESS:        return "expected LCD backpack";
    case 0x77:               return "BME280 with SDO tied high";
    case 0x3F:               return "common alternative LCD address";
    case 0x50: case 0x51: case 0x52: case 0x53:
    case 0x54: case 0x55: case 0x56: case 0x57: return "24Cxx EEPROM address range";
    default: return "";
  }
}

static void liveI2cScan() {
  static bool present[128];
  memset(present, 0, sizeof(present));
  Serial.println(F("[SCAN] Sweeping 0x01-0x7E once per second."));
  Serial.println(F("[SCAN] Plug or unplug a module now and watch for a change."));
  Serial.println(F("[SCAN] Send any character to stop. The sensor loop is paused"
                   " during this."));
  uint32_t lastReportMs = millis();
  for (;;) {
    uint8_t count = 0;
    bool changed = false;
    for (uint8_t address = 1; address < 127; ++address) {
      const bool now = i2cDevicePresent(address);
      if (now) ++count;
      if (now != present[address]) {
        present[address] = now;
        changed = true;
        Serial.printf("[SCAN] %s 0x%02X  %s\n", now ? "APPEARED  " : "DISAPPEARED",
                      static_cast<unsigned>(address), i2cAddressLabel(address));
      }
    }
    if (changed || millis() - lastReportMs >= 5000) {
      Serial.printf("[SCAN] %u device(s) responding now\n",
                    static_cast<unsigned>(count));
      lastReportMs = millis();
    }
    while (Serial.available() > 0) {
      Serial.read();
      Serial.println(F("[SCAN] Stopped."));
      return;
    }
    delay(500);
  }
}

// Raw channel readout, deliberately bypassing the plausibility gate.
//
// A baseline failure only says "the number did not look right". It cannot say
// what the number was, and the fix differs completely between a dead channel
// reading 0 mV and a working sensor reading a stable value the window was too
// short to accept. This reports the raw conversion so the two are separable.
static void reportMqRawReading() {
  if (!adsReady) {
    Serial.println(F("[MQRAW] ADS1115 not initialised"));
    return;
  }
  const int16_t code = ads1115.readADC_SingleEnded(0);
  const double millivolts =
      (static_cast<double>(code) * MQ_ADS_FULL_SCALE_MV) / 32767.0;
  Serial.printf("[MQRAW] AIN0 code=%d  %.1f mV  (full scale +/-%.0f mV)\n",
                static_cast<int>(code), millivolts, MQ_ADS_FULL_SCALE_MV);
  Serial.println(F("        0 mV means nothing is reaching A0. A value near full"
                   " scale means the divider"));
  Serial.println(F("        is wrong or the input is floating. A small stable value"
                   " means the load resistor"));
  Serial.println(F("        is present and the baseline window was simply too short."));
  Serial.println(F("        Take several readings: a value still moving is the sensor"
                   " warming up."));
}

/**
 * RFIDTEST: a read-only look at the reader's wiring and SPI path.
 *
 * DELIBERATELY SEPARATE FROM THE OPERATIONAL SCAN PATH
 * This is a diagnostic an engineer types while the reader is not yet trusted. It
 * pulses reset, reads registers and prints. It does not call serviceRc522(), does
 * not read a card serial, queues no event, sets no fault bit, changes no
 * freshness status and asks for no publish. Nothing in it reaches
 * publishRfidScanEvent(), so a diagnostic can never manufacture an
 * rfid_scanned event that no tag actually caused - which matters, because these
 * two paths were once easy to confuse and the difference is between "the reader
 * is wired correctly" and "this tag was presented".
 *
 * It also drives P5, which is why it is a command and not part of the poll loop.
 */
static void reportRc522Diagnosis() {
  if (!pcfInitialized) {
    Serial.println(F("[RFID] PCF8574 unavailable, so P5 cannot drive RST"));
    return;
  }
  uint8_t pins = 0;
  if (!pcfReadPort(&pins)) {
    Serial.println(F("[RFID] Could not read the expander pins"));
    return;
  }
  const bool rstHigh = (pins & (1U << PCF_PIN_RC522_RST)) != 0;
  Serial.printf("[RFID] P5 (RST) currently %s\n", rstHigh ? "HIGH" : "LOW");
  if (!rstHigh) {
    Serial.println(F("        RST is held LOW, so the reader is stuck in reset and"
                     " will never"));
    Serial.println(F("        report a version. Check the P5 wiring."));
    return;
  }
  if (!pulseRc522Reset()) {
    Serial.println(F("[RFID] Reset pulse reported failure"));
    return;
  }
  Serial.println(F("[RFID] Reset pulse sent; reading registers to confirm the SPI"
                   " path"));
  rc522.PCD_Init();
  // One odd value could be an odd part. Several registers all returning their
  // documented contents means the bus is shifting bits correctly, and a
  // misaligned or shorted SPI line would corrupt every one of them.
  struct Probe {
    MFRC522::PCD_Register reg;
    const char* name;
    const char* expected;
  };
  static const Probe probes[] = {
      {MFRC522::VersionReg,   "VersionReg",   "0x90/0x91/0x92 (0x88 on a clone)"},
      {MFRC522::CommandReg,   "CommandReg",   "0x00 when idle"},
      {MFRC522::ComIEnReg,    "ComIEnReg",    "0x7B after PCD_Init"},
      {MFRC522::DivIrqReg,    "DivIrqReg",    "0x00 when idle"},
      {MFRC522::FIFOLevelReg, "FIFOLevelReg", "0x00 with an empty FIFO"},
      {MFRC522::TxASKReg,     "TxASKReg",     "0x40 after PCD_Init"},
  };
  uint8_t sane = 0;
  for (const Probe& probe : probes) {
    const uint8_t value = rc522.PCD_ReadRegister(probe.reg);
    Serial.printf("[RFID]   %-14s 0x%02X   expect %s\n", probe.name,
                  static_cast<unsigned>(value), probe.expected);
    if (value != 0x00 && value != 0xFF) ++sane;
  }
  Serial.printf("[RFID] %u of %u registers returned real data\n",
                static_cast<unsigned>(sane),
                static_cast<unsigned>(sizeof(probes) / sizeof(probes[0])));
  if (sane == 0) {
    Serial.println(F("        Every register reads 0x00 or 0xFF: the bus is not"
                     " reaching the chip."));
  } else if (sane < 4) {
    Serial.println(F("        Some registers are blank, so the SPI path is"
                     " marginal. Check solder joints on the module headers"));
    Serial.println(F("        and keep the wires short."));
  } else {
    Serial.println(F("        The SPI path is sound. Hold a card to the antenna and"
                     " it should be detected."));
  }
}

static void logI2CBus() {
  Serial.println(F("[I2C] Scan at 100 kHz:"));
  uint8_t found = 0;
  for (uint8_t address = 1; address < 127; ++address) {
    if (i2cDevicePresent(address)) {
      Serial.printf("  0x%02X%s\n", static_cast<unsigned>(address),
                    address == BME280_I2C_ADDRESS ? " (expected BME280)" :
                    address == DS3231_ADDRESS ? " (expected DS3231)" :
                    address == ADS1115_ADDRESS ? " (expected ADS1115)" :
                    address == PCF8574_ADDRESS ? " (expected PCF8574)" :
                    address == LCD_ADDRESS ? " (expected LCD)" : "");
      ++found;
    }
  }
      if (found == 0) Serial.println(F("  no responding devices"));
      // A PCF8574's slave address is the three strapped pins A2/A1/A0, and the
      // register select travels in the first data byte AFTER the address - it is
      // not part of the address. So exactly one address in 0x20-0x27 responds,
      // and that is correct. (An MCP23017 behaves the opposite way: its register
      // pointer shares the low three address bits, so 0x20-0x27 all alias to one
      // device. If this board ever aliases, it is not a PCF8574.)
      if (i2cDevicePresent(PCF8574_ADDRESS) && !i2cDevicePresent(PCF8574_ADDRESS + 1)) {
        Serial.println(F("  note: one address only, which is correct for a PCF8574"));
      }
      // An address outside the five modules this build expects is worth naming,
      // but only for what it is: an address that answered. Saying it moved
      // between scans would require history this scan does not keep, and an
      // invented instability claim is worse than no claim at all.
      for (uint8_t address = 1; address < 127; ++address) {
        const bool expectedModule =
            address == BME280_I2C_ADDRESS || address == DS3231_ADDRESS ||
            address == ADS1115_ADDRESS || address == PCF8574_ADDRESS ||
            address == LCD_ADDRESS;
        const bool eepromRange = address >= 0x50 && address <= 0x57;
        if (!expectedModule && !eepromRange && i2cDevicePresent(address)) {
          Serial.printf("  NOTE: 0x%02X answered but is not a module this build"
                        " expects, and is not an\n        EEPROM address. It may be a"
                        " phantom from a marginal bus or a stray device.\n",
                        static_cast<unsigned>(address));
        }
      }
    }

// ---------------------------------------------------------------------------
// PCF8574 port access - one byte in, one byte out, no register pointer.
// ---------------------------------------------------------------------------

// Write the single data byte straight to the 8 pins.
static bool pcfWritePort(uint8_t value) {
  const uint32_t nowMs = millis();
  Wire.beginTransmission(PCF8574_ADDRESS);
  Wire.write(value);
  const bool ok = Wire.endTransmission(true) == 0;
  if (ok) delayMicroseconds(I2C_WRITE_RECOVERY_US);
  faults.pcf8574Write = updateFaultDebounce(&pcfWriteDebounce, !ok, nowMs);
  return ok;
}

// Read the live level of the 8 pins. No command byte is sent, so the part
// returns its input port directly. The stop flag matters: without an explicit
// STOP the ESP8266 core leaves the bus held, and the next transfer fails.
static bool pcfReadPort(uint8_t* value) {
  if (value == nullptr) return false;
  const uint32_t nowMs = millis();
  const uint8_t received =
      Wire.requestFrom(PCF8574_ADDRESS, static_cast<uint8_t>(1),
                       static_cast<uint8_t>(1));
  const bool ok = received == 1;
  if (ok) {
    *value = Wire.read();
    pcfReadReady = true;
    markSensorReady(SENSOR_FAULT_PCF8574_READ | SENSOR_FAULT_PCF8574_WRITE);
  }
  faults.pcf8574Read = updateFaultDebounce(&pcfReadDebounce, !ok, nowMs);
  return ok;
}

// Defined with the serial command interface, below, but needed here: a failed
// write dumps the device automatically rather than waiting for someone to type
// a command at the right moment.
static void dumpI2cRegisters(uint8_t address);

static void dumpAllI2cDevices();

static bool pcfWriteOutput(uint8_t value) {
  if (!pcfWritePort(value)) return false;

  // The port read returns the actual pin levels, so every controlled output
  // transition is verified after the bus write. A mismatch is a real bus or
  // load fault, not a cached-shadow success. The reed pin is excluded because
  // an external switch legitimately drives it to the opposite level of the
  // latch. Keep the old shadow until the readback succeeds so a later caller
  // retries the failed transition.
  uint8_t pins = 0;
  if (!pcfReadPort(&pins)) {
    faults.pcf8574Read = true;
    forceFaultDebounce(&pcfReadDebounce, millis());
    faults.pcf8574Write = true;
    forceFaultDebounce(&pcfWriteDebounce, millis());
    return false;
  }
  const uint8_t mask = PCF_CONTROL_PIN_MASK;
  if ((pins & mask) != (value & mask)) {
    faults.pcf8574Write = true;
    forceFaultDebounce(&pcfWriteDebounce, millis());
    Serial.printf("[PCF8574] Port readback mismatch: pins 0x%02X, wanted 0x%02X"
                  " (masked 0x%02X)\n",
                  static_cast<unsigned>(pins), static_cast<unsigned>(value),
                  static_cast<unsigned>(mask));
    return false;
  }
  pcfOutputShadow = value;
  return true;
}

static bool pcfSetRawBit(uint8_t pin, bool high) {
  if (pin > 7) return false;
  uint8_t mask = static_cast<uint8_t>(1U << pin);
  uint8_t desired = high ? static_cast<uint8_t>(pcfOutputShadow | mask)
                         : static_cast<uint8_t>(pcfOutputShadow & static_cast<uint8_t>(~mask));
  if (desired == pcfOutputShadow) return true;
  return pcfWriteOutput(desired);
}

static bool pcfSetOutputActive(uint8_t pin, bool active) {
  bool high = PCF_PIN_ACTIVE_HIGH(pin) ? active : !active;
  return pcfSetRawBit(pin, high);
}

static bool initializePcf8574() {
  pcfInitialized = false;
  // P0 must sit at 1 in the latch. On this chip a written 1 is a weak source,
  // so the reed switch can pull the pin to ground and the read will return 0
  // when the magnet is present. P0 is excluded from the latch-vs-pin
  // verification below for exactly that reason.
  const uint8_t initPattern =
      static_cast<uint8_t>(PCF_OUTPUTS_INACTIVE | (1U << PCF_PIN_REED));
  pcfOutputShadow = initPattern;

  if (!pcfWritePort(initPattern)) {
    Serial.println(F("[PCF8574] Port write failed at 0x20"));
    faults.pcf8574Write = true;
    forceFaultDebounce(&pcfWriteDebounce, millis());
    return false;
  }

  // Read the pin levels back. There is no configuration register to compare, so
  // this confirms the part is decoding and driving rather than a bus artefact.
  // Three attempts, because one corrupted frame in a fridge full of compressor
  // noise should not permanently disable door detection, the LEDs, the buzzer
  // and the RFID reader.
  uint8_t pins = 0;
  for (uint8_t attempt = 1; attempt <= 3; ++attempt) {
    if (!pcfReadPort(&pins)) {
      Serial.printf("[PCF8574] Port readback attempt %u: bus error\n",
                    static_cast<unsigned>(attempt));
    } else {
      break;
    }
    delay(10);
  }
  const uint8_t mask = PCF_CONTROL_PIN_MASK;
  if ((pins & mask) != (initPattern & mask)) {
    faults.pcf8574Read = true;
    forceFaultDebounce(&pcfReadDebounce, millis());
    Serial.printf("[PCF8574] Pins 0x%02X, expected 0x%02X on the controlled bits"
                  " after 3 attempts.\n"
                  "  The write was acknowledged, so the part is present. A driven"
                  " output that reads\n"
                  "  back differently points at a load fault: a missing gate"
                  " pull-down, an LED wired\n"
                  "  the wrong way round, or a pin already shorted.\n",
                  static_cast<unsigned>(pins), static_cast<unsigned>(initPattern));
    dumpAllI2cDevices();
    return false;
  }

  pcfOutputShadow = initPattern;
  pcfInitialized = true;
  Serial.printf("[PCF8574] OK at 0x20: P0 weak-high for the reed, P1-P5 driven,"
                " idle pattern 0x%02X, pins 0x%02X\n",
                static_cast<unsigned>(initPattern), static_cast<unsigned>(pins));
  return true;
}

// ============================================================================
// LCD helpers
// ============================================================================

static void lcdPrintRow(uint8_t row, const char* text) {
  if (!lcdReady || row >= LCD_ROWS) return;
  char line[LCD_COLUMNS + 1];
  copyBounded(line, sizeof(line), text ? text : "");
  lcd.setCursor(0, row);
  lcd.print(line);
  for (uint8_t column = strlen(line); column < LCD_COLUMNS; ++column) lcd.write(' ');
}

static void lcdPrintfRow(uint8_t row, const char* format, ...) {
  char line[LCD_COLUMNS + 1];
  va_list arguments;
  va_start(arguments, format);
  vsnprintf(line, sizeof(line), format, arguments);
  va_end(arguments);
  lcdPrintRow(row, line);
}

static void initializeLcd() {
  faults.lcd = !i2cDevicePresent(LCD_ADDRESS);
  if (faults.lcd) {
    lcdReady = false;
    Serial.printf("[LCD] No ACK at configured address 0x%02X\n",
                  static_cast<unsigned>(LCD_ADDRESS));
    return;
  }
  lcd.begin(LCD_COLUMNS, LCD_ROWS);
  lcdReady = true;
  if (lcdBacklightOn) lcd.backlight(); else lcd.noBacklight();
  lcdPrintRow(0, "FreshGuard ESP8266");
  lcdPrintRow(1, "Starting...");
  Serial.printf("[LCD] OK at 0x%02X (assume BSS138 verified)\n",
                static_cast<unsigned>(LCD_ADDRESS));
}

// ============================================================================
// Environmental sensors
// ============================================================================

static void initializeEnvironmentalSensors() {
  bmeDataReady = false;
  humidityReady = false;

  bmeReady = bme280.begin(BME280_I2C_ADDRESS);
  Serial.println(bmeReady ? F("[BME280] OK") : F("[BME280] No ACK; awaiting confirmed data"));

  // Humidity oversampling MUST be requested explicitly.
  //
  // Adafruit_BME280's default constructor is empty, so its ctrl_hum register
  // object is zero-initialised, and osrs_h = 0 means SAMPLING_NONE.
  // readHumidity() returns NAN in that case, silently. Without this call the
  // device would report humidity unavailable forever and latch a permanent
  // fault, which is the same class of bug as a wrong chip id.
  if (bmeReady) {
    bme280.setSampling(Adafruit_BME280::MODE_NORMAL,
                       Adafruit_BME280::SAMPLING_X16,   // temperature
                       Adafruit_BME280::SAMPLING_X16,   // pressure
                       Adafruit_BME280::SAMPLING_X16,   // humidity - the one that matters
                       Adafruit_BME280::FILTER_OFF,
                       Adafruit_BME280::STANDBY_MS_0_5);
  }

  lastAdsInitAttemptMs = millis();
  adsReady = ads1115.begin(ADS1115_ADDRESS, &Wire);
  if (adsReady) {
    ads1115.setGain(MQ_ADS_GAIN);
    ads1115.setDataRate(MQ_ADS_DATA_RATE);
    markSensorReady(SENSOR_FAULT_ADS1115);
    Serial.printf("[ADS1115] OK range=GAIN_ONE full-scale=+/-%.3f V rate=%u SPS\n",
                  static_cast<double>(MQ_ADS_FULL_SCALE_VOLTS),
                  static_cast<unsigned>(MQ_ADS_DATA_RATE_SPS));
  } else {
    Serial.println(F("[ADS1115] No ACK; will retry without raising a boot fault"));
  }
  mqState = MqState::WarmingUp;
  // Not a confirmed fault: shown as Data Unavailable until Ready, excluded
  // from the remote sensor-fault transition alert.
  faults.mq135 = false;
}

static void readBme280() {
  float newTemperature = NAN;
  float newPressure = NAN;
  bool valid = false;
  if (bmeReady) {
    newTemperature = bme280.readTemperature();
    newPressure = bme280.readPressure() / 100.0F;
    valid = !isnan(newTemperature) && !isinf(newTemperature) &&
            !isnan(newPressure) && !isinf(newPressure) &&
            newTemperature >= -40.0F && newTemperature <= 85.0F &&
            newPressure >= 300.0F && newPressure <= 1100.0F;
  }
  faults.bme280 = updateFaultDebounce(&bme280Debounce, !valid, millis());
  if (!valid) return;
  temperatureC = smoothValue(temperatureC, newTemperature, 0.20F);
  pressureHpa = smoothValue(pressureHpa, newPressure, 0.20F);
  bmeDataReady = true;
  markSensorReady(SENSOR_FAULT_BME280);
}

static void readBme280Humidity() {
  // Humidity now comes from the BME280, the same chip that supplies
  // temperature and pressure. readHumidity() returns NAN if humidity
  // oversampling was never requested, which initializeEnvironmentalSensors()
  // guarantees, so a NAN here means a genuine read failure and is debounced as
  // one rather than silently reported as 0 %RH.
  float newHumidity = bme280.readHumidity();
  bool valid = !isnan(newHumidity) && !isinf(newHumidity) &&
               newHumidity >= 0.0F && newHumidity <= 100.0F;
  faults.bme280Humidity = updateFaultDebounce(&bme280HumidityDebounce, !valid, millis());
  if (!valid) return;
  humidityPct = smoothValue(humidityPct, newHumidity, 0.20F);
  humidityReady = true;
  markSensorReady(SENSOR_FAULT_BME280_HUMIDITY);
}

static bool loadMqBaselineFromStorage();
static bool saveMqBaselineToStorage();

static const char* mqStateText(MqState state) {
  switch (state) {
    case MqState::WarmingUp: return "warming";
    case MqState::CapturingBaseline: return "capturing baseline";
    case MqState::Ready: return "ready";
    case MqState::Faulted: return "fault";
  }
  return "unknown";
}
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
void loop() {
  uint32_t nowMs = millis();
  ESP.wdtFeed();

  serviceSerial();
  serviceWiFi(nowMs);
  serviceRtc(nowMs);
  serviceReedInput(nowMs);
  serviceMq135(nowMs);

  bool sensorPollDue = static_cast<uint32_t>(nowMs - lastSensorPollMs) >= SENSOR_POLL_INTERVAL_MS;
  if (sensorPollDue) {
    lastSensorPollMs = nowMs;
    readBme280();
    readBme280Humidity();
    refreshFreshnessStatus();
    evaluateAlertConditions(nowMs);
    // Once per poll, and against the LAST PUBLISHED values. Called here rather
    // than on every loop iteration so one change is one event, and placed
    // before serviceTransport() below so a detected change is published in this
    // same pass instead of a poll later. serviceMq135() has already run by now,
    // so the MQ-135 figures are included even on a pass where the BME280 is not
    // due; the two share a 5 s cadence and drift apart by milliseconds at most.
    publishIfSensorChanged();
  }

  serviceFaultTransitionAlert(nowMs);
  refreshFreshnessStatus();
  FreshnessStatus overallStatus = calculateOverallStatus();

  serviceBuzzer(nowMs);
  serviceStatusLeds(overallStatus, nowMs);
  serviceRc522(nowMs);
  updateLcd(nowMs, overallStatus);
  serviceTransport(nowMs);

  yield();
}
